daveshah1/RFToolSDR/hardware/rftool/rftool_impedances.png

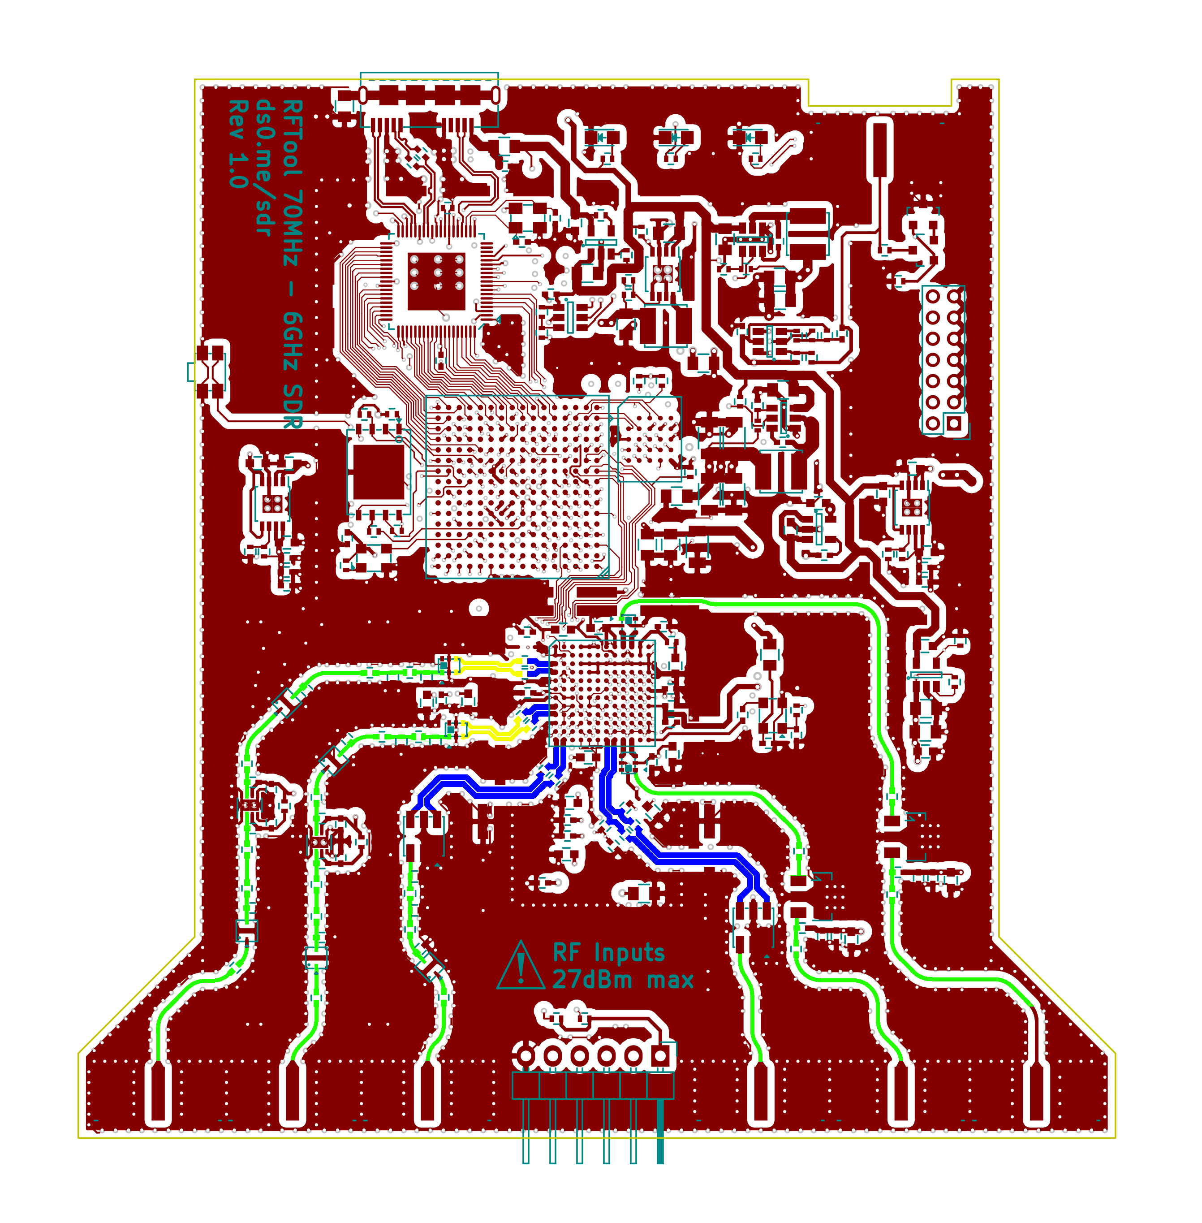
hardware/rftool/rftool_impedances.png
