daveshah1/RFToolSDR/hardware/rftool/bom/rftool_bom_r1.0_final_mpn.ods

Id | Designator | Package | Quantity | Designation | Description | Manufacturer | MPN | Notes/Positioning | Pin/Pad Count
23 | C103,C108,C111,C113,C118,C119,C120,C124,C132 | C_0805 | 9 | 4.7µ | 4.7uF 0805 capacitor | Murata | GRM21BR71A475KA73K | or any other equivalent part | 2
24 | C104,C105,C109,C110,C114,C115,C121,C123,C125,C126,C127,C128,C129,C130,C131,C133 | C_0402 | 16 | 470n | 470nF X7R 0402 capacitor | Murata | GRM155R71A474KE01D | or any other equivalent part | 2
13 | C122,C39,C41,C112,C116,C117 | C_1206 | 6 | 47µ | 47uF 6.3V 1206 capacitor | Murata | GRM31CR60J476ME19L | or any other equivalent part | 2
20 | C14,C30,C31,C58,C61,C101,C32 | C_0805 | 7 | 10µ | 10uF 0805 capacitor | Murata | GRM21BR71A106KA73K | or any other equivalent part | 2
15 | C2,C1,C7,C10,C11,C12,C22,C26,C27,C16,C146,C147,C149,C151 | C_0402 | 14 | 100p | 100pF 0402 C0G capacitor | Murata | GCM1555C1H101JA16D | or any other equivalent part | 2
5 | C20,C72,C59,C76,C25,C48,C56,C57,C60,C73,C79,C84,C87,C90,C150 | C_0402 | 15 | 10n | 10nF 0402 capacitor | Murata | GRM155R71E103KA01D | or any other equivalent part | 2
21 | C23,C24,C28,C29,C95,C100,C152,C153 | C_0402 | 8 | 18p | 18pF 0402 C0G capacitor | Murata | GRM1555C1E180JA01D | or any other equivalent part | 2
16 | C3,C9,C13,C62,C63,C85,C86,C15,C145 | C_0402 | 9 | 1n | 1nF 0402 capacitor | Murata | GRM155R71H102KA01D | or any other equivalent part | 2
22 | C36,C37,C38,C40 | C_0805 | 4 | 22µ | 22uF 0805 capacitor | Murata | GRM21BC80J226ME51L | or any other equivalent part | 2
17 | C4,C17 | C_0402 | 2 | 68p | 68pF 0402 C0G capacitor | Murata | GRM1555C1H680GA01D | or any other equivalent part | 2
18 | C5,C18 | C_0402 | 2 | 1.2n | 1.2nF 0402 capacitor | Murata | GRM155R71H122KA01J | or any other equivalent part | 2
3 | C52,C68,C8,C19,C21,C33,C42,C43,C44,C46,C47,C49,C53,C64,C69,C70,C71,C74,C75,C82,C83,C88,C89,C102,C135,C139,C148,C77,C45 | C_0603 | 29 | 1µ | 1uF 0603 capacitor | Murata | GRM188R71C105KE15D | or any other equivalent part | 2
19 | C6,C144 | C_0402 | 2 | 20p | 20pF 0402 C0G capacitor | Murata | GRM1555C1H200JA01D | or any other equivalent part | 2
7 | C80,C34,C35,C50,C54,C55,C65,C66,C67,C78,C81,C91,C92,C93,C94,C96,C97,C98,C99,C106,C107,C134,C136,C137,C138 | C_0402 | 25 | 100n | 100nF 0402 capacitor | Murata | GRM155R71C104KA88D | or any other equivalent part | 2
25 | D1,D2 | LED_0805 | 2 | GREEN | Green 0805 LED | OSRAM | LG R971-KN-1 | or any other equivalent part | 2
26 | D3 | LED_0805 | 1 | ORANGE | Orange 0805 LED | OSRAM | LO R976-PS-1 | or any other equivalent part | 2
27 | D4,D5,D6,D8,D9 | CLA4603-085LF | 5 | CLA4603-085LF | RF PIN limiter diode | Skyworks | CLA4603-085LF | or any other equivalent part | 3
9 | J2,J1 | BMI-S-230-F-R | 2 | BMI-S-230-F-R | RF shield frame 2”x1.5” | Laird | BMI-S-230-F-R | or any other equivalent part | 28
6 | J3 | BMI-S-209-F | 1 | BMI-S-209-F | RF shield frame 0.728”x1.156” | Laird | BMI-S-209-F | or any other equivalent part | 12
8 | J4,J5 | BMI-S-205-F | 2 | BMI-S-205-F | RF shield frame 1”x1.5” | Laird | BMI-S-205-F | or any other equivalent part | 20
12 | J6 | MICROUSB-GSB343K33HRCTV | 1 | GSB343K33HRCT | USB 3.0 micro-B connector SMD RA | Amphenol | GSB343K33HR | or any other equivalent part | 16
28 | L1,L8 | C_0402 | 2 | 43nH | 43nH 0402 inductor | Murata | LQW15AN43NG80D | or any other equivalent part | 2
32 | L12 | XFL4020 | 1 | 3.3µ | 3.3uH 5A 4x4mm inductor | Coilcraft | XFL4020-332MEB | or any other equivalent part | 2
33 | L13 | XFL4020 | 1 | 2.2µH | 2.2uH 8A 4x4mm inductor | Coilcraft | XFL4020-222MEB | or any other equivalent part | 2
34 | L14 | XFL4020 | 1 | 1.5µH | 1.5uH 9A 4x4mm inductor | Coilcraft | XFL4020-152MEB | or any other equivalent part | 2
35 | L15,L16,L17 | C_0805 | 3 | FERRITE | 120ohm@100MHz 3.5A 0805 ferrite | Laird | HI0805O121R-10 | or any other equivalent part | 2
2 | L3,L2,L5,L11,L10,L20,L22 | C_0402 | 7 | 30nH | 30nH 0402 inductor | Murata | LQW15AN30NG80D | or any other equivalent part | 2
29 | L4,L19 | C_0402 | 2 | 1nH | 1nH 0402 inductor | Murata | LQG15HN1N0S02D | or any other equivalent part | 2
30 | L6,L7 | C_0402 | 2 | 330nH | 330nH 0402 inductor | Bourns | CW201212-R33J | or any other equivalent part | 2
31 | L9,L21 | C_0402 | 2 | 36nH | 36nH 0402 inductor | Murata | LQW15AN36NG80D | or any other equivalent part | 2
36 | P5 | Pin_Header_Straight_2x07_Pitch2.00mm | 1 | JTAG | Shrouded 2x7 pin 2.00mm header | Molex | 0878311420 | or any other equivalent part | 14
11 | P6,P4,P8,P1,P2,P3,P9 | SMA-EDGE-73251-1150 | 7 | 73251-1150 | End launch SMA socket | Molex | 0732511150 | or any other equivalent part | 2
14 | P7 | Pin_Header_Angled_1x06 | 1 | AUX | 1x6 pin 2.54mm RA header | Molex | 0022053061 | or any other equivalent part | 6
1 | Q2,Q1 | SOT-23 | 2 | 2N7002 | N-channel logic level MOSFET | NXP | 2N7002P,215 | or any other equivalent part | 3
37 | R1,R61,R62 | R_0402 | 3 | 2.2k | 2.2kΩ 0402 resistor | Yageo | RC0402FR-072K2L | or any other equivalent part | 2
43 | R11 | R_0402 | 1 | 3.16k | 3.16kΩ 1% 0402 resistor | Yageo | RC0402FR-073K16L | or any other equivalent part | 2
44 | R17,R19 | R_0402 | 2 | 11.5k | 11.5kΩ 1% 0402 resistor | Yageo | RC0402FR-0711K5L | or any other equivalent part | 2
38 | R2,R3,R25,R56,R57,R58,R59 | R_0402 | 7 | 1k | 1kΩ 0402 resistor | Yageo | RC0402FR-071KL | or any other equivalent part | 2
45 | R24 | R_0402 | 1 | 14.3k | 14.3kΩ 1% 0402 resistor | Yageo | RC0402FR-0714K3L | or any other equivalent part | 2
69 | R26,R63,R70 | R_0402 | 3 | 82 | 82Ω 1% 0402 resistor | Yageo | RC0402FR-0782RL | or any other equivalent part | 2
70 | R27 | R_0402 | 1 | 100 | 100Ω 1% 0402 resistor | Yageo | RC0402FR-07100RL | or any other equivalent part | 2
46 | R29,R30 | R_0402 | 2 | 1 | 1Ω 0402 resistor | Panasonic | ERJ-2GEJ1R0X | or any other equivalent part | 2
47 | R34 | R_0402 | 1 | 1.6k | 1.6kΩ 1% 0402 resistor | Yageo | RC0402FR-071K6L | or any other equivalent part | 2
39 | R4,R15,R39,R40,R42,R43,R44,R45,R67 | R_0402 | 9 | 4.7k | 4.7kΩ 0402 resistor | Yageo | RC0402FR-074K7L | or any other equivalent part | 2
48 | R41 | R_0402 | 1 | 22 | 22Ω 0402 resistor | Yageo | RC0402FR-0722RL | or any other equivalent part | 2
71 | R46,R48,R68 | R_0402 | 3 | 75 | 75Ω 1% 0402 resistor | Yageo | RC0402FR-0775RL | or any other equivalent part | 2
49 | R47,R49,R50 | R_0402 | 3 | 0R | 0Ω 0402 resistor | Yageo | RC0402FR-070RL | or any other equivalent part | 2
40 | R5,R6,R8,R10,R12,R13,R14,R16,R18,R21,R22,R23,R28,R31,R32,R33,R35,R36,R37,R38,R53,R54,R55,R20 | R_0402 | 24 | 10k | 10kΩ 1% 0402 resistor | Yageo | RC0402FR-0710KL | or any other equivalent part | 2
72 | R51,R69 | R_0402 | 2 | 120 | 120Ω 1% 0402 resistor | Yageo | RC0402FR-07120RL | or any other equivalent part | 2
50 | R52 | R_0402 | 1 | 47 | 47Ω 1% 0402 resistor | Yageo | RC0402FR-0747RL | or any other equivalent part | 2
41 | R7,R60 | R_0402 | 2 | 45.3k | 45.3kΩ 1% 0402 resistor | Yageo | RC0402FR-0745K3L | or any other equivalent part | 2
42 | R9 | R_0402 | 1 | 13.7k | 13.7kΩ 1% 0402 resistor | Yageo | RC0402FR-0713K7L | or any other equivalent part | 2
73 | SWRST1 | PTS840G | 1 | PTS840 GKP SMTR LFS | Right Angle SMD tactile switch | Yageo | PTS840GKPSMTR |  | 4
51 | T1,T3 | TCM1-63AX+ | 2 | TCM1-63AX+ | RF Transformer 1:1 10MHz-6GHz | Mini-Circuits | TCM1-63AX+ |  | 6
67 | T4,T7 | 1720BL15B0050 | 2 | 1720BL15A0100 | Ceramic Balun 1:2 625MHz-2815MHz | Johanson | 1720BL15A0100 | coloured mark facing up | 6
68 | T5,T2 | 1720BL15B0050 | 2 | 1720BL15B0050 | Ceramic Balun 1:1 625MHz-2815MHz | Johanson | 1720BL15B0050 | coloured mark facing up | 6
10 | U1,U20 | SOT89-3 | 2 | ADL5611 | RF amplifier 30MHz-6GHz | Analog Devices | ADL5611ARKZ |  | 4
58 | U11 | SOT-23-6 | 1 | LM3880MF-1AA | Power supply sequencer | TI | LM3880MF-1AA |  | 6
4 | U12 | CSP_BGA_144_pitch0.8mm | 1 | AD9361BBCZ | RF transceiver 70MHz-6GHz | Analog Devices | AD9361BBCZ |  | 144
59 | U13 | XO_3.2x2.5mm | 1 | TXEAACSANF-40.000000 | 40MHz 2.8-3.3V 0.5ppm TCXO | Taiten | TXEAACSANF-40.000000 |  | 4
60 | U14 | QFN_76_pitch0.4mm | 1 | FT601Q | USB 3.0 to FIFO bridge | FTDI | FT601Q |  | 77
61 | U15 | XO_3.2x2.5mm | 1 | KC3225A50.0000C3GE00 | 50MHz 3.3V oscillator | AVX/Kyocera | KC3225A50.0000C3GE00 | or any other equivalent part | 4
62 | U16 | VDFPN8 | 1 | N25Q256A13EF840E | 256MBit 3.3V serial flash memory | Micron | N25Q256A13EF840E |  | 9
63 | U17 | BGA-256 | 1 | XC7A50T-2FTG256I | Artix-7 FPGA 52k logic cells | Xilinx | XC7A50T-2FTG256I | XC7A50T-2FTG256C also OK if cheaper | 256
64 | U18 | FBGA24_pitch1mm | 1 | IS66WVH8M8ALL-166B1LI | 64MBit HyperRAM 1.8V 166MHz | ISSI | IS66WVH8M8ALL-166B1LI |  | 24
65 | U19 | SOT-23-6 | 1 | SN74LVC2G17 | Dual schmitt-trigger buffer | TI | SN74LVC2G17DBVR |  | 6
52 | U2,U21 | DFN-8-1EP_2x2mm_Pitch0.5mm | 2 | SKY67159-396LF | RF LNA 200MHz-3.8GHz | Skyworks | SKY67159-396LF |  | 9
53 | U3,U8 | SOT-23-5 | 2 | TPS2069C-DBV | 1.5A USB power switch IC | TI | TPS2069CDBVR |  | 6
54 | U4 | MSOP-8-1EP_3x3mm_Pitch0.65mm | 1 | LM2832XMY | 2A buck switching regulator IC | TI | LM2832XMY/NOPB |  | 9
55 | U5,U6 | SOT-23-6 | 2 | TPS564208DDC | 4A buck switching regulator IC | TI | TPS564208DDCR |  | 6
56 | U7 | SOT-23-5 | 1 | LD3985M30R | 3.0V 150mA LDO regulator | ST | LD3985M30R |  | 5
57 | U9,U10 | MSOP-8-1EP_3x3mm_Pitch0.65mm | 2 | MIC47100YMME | Adjustable 1A LDO regulator | Microchip | MIC47100YMME |  | 9
66 | X1 | XTAL_3.2x2.5mm | 1 | ABM8-30.000MHZ-B2 | 30MHz crystal | Abracon | ABM8-30.000MHZ-B2-T | or any other equivalent part | 4
