daveshah1/RFToolSDR/hardware/rftool/pos/positions_bottom.pdf

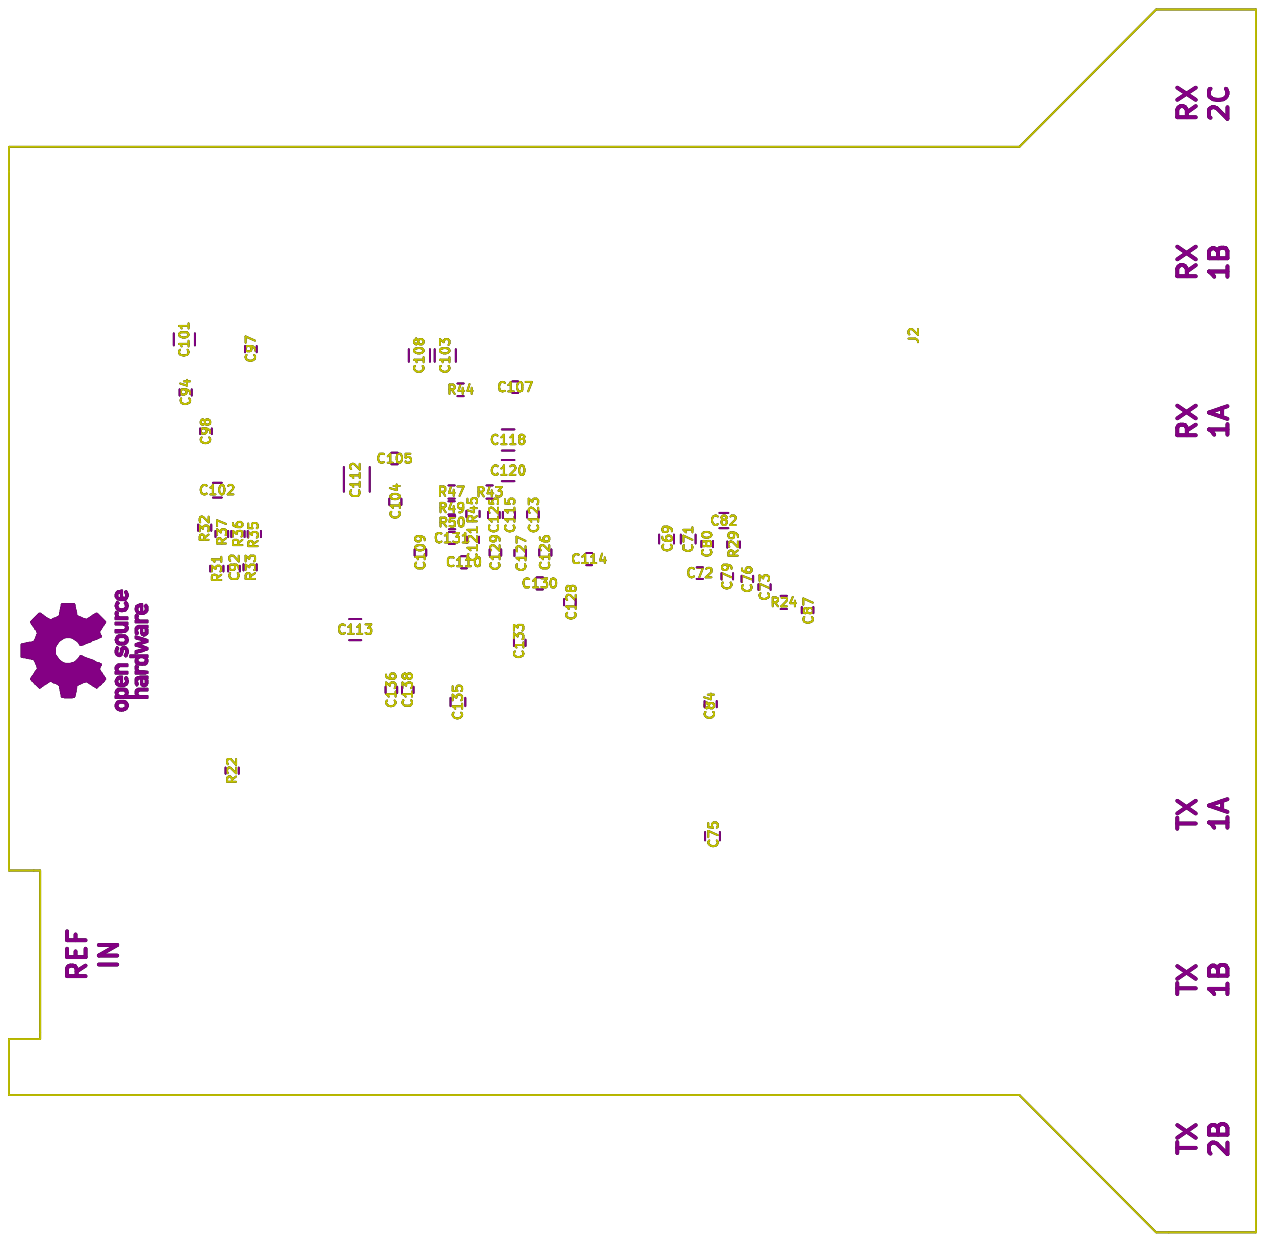
[picture p2: page 1]
