daveshah1/RFToolSDR/hardware/rftool/pos/positions_top.pdf

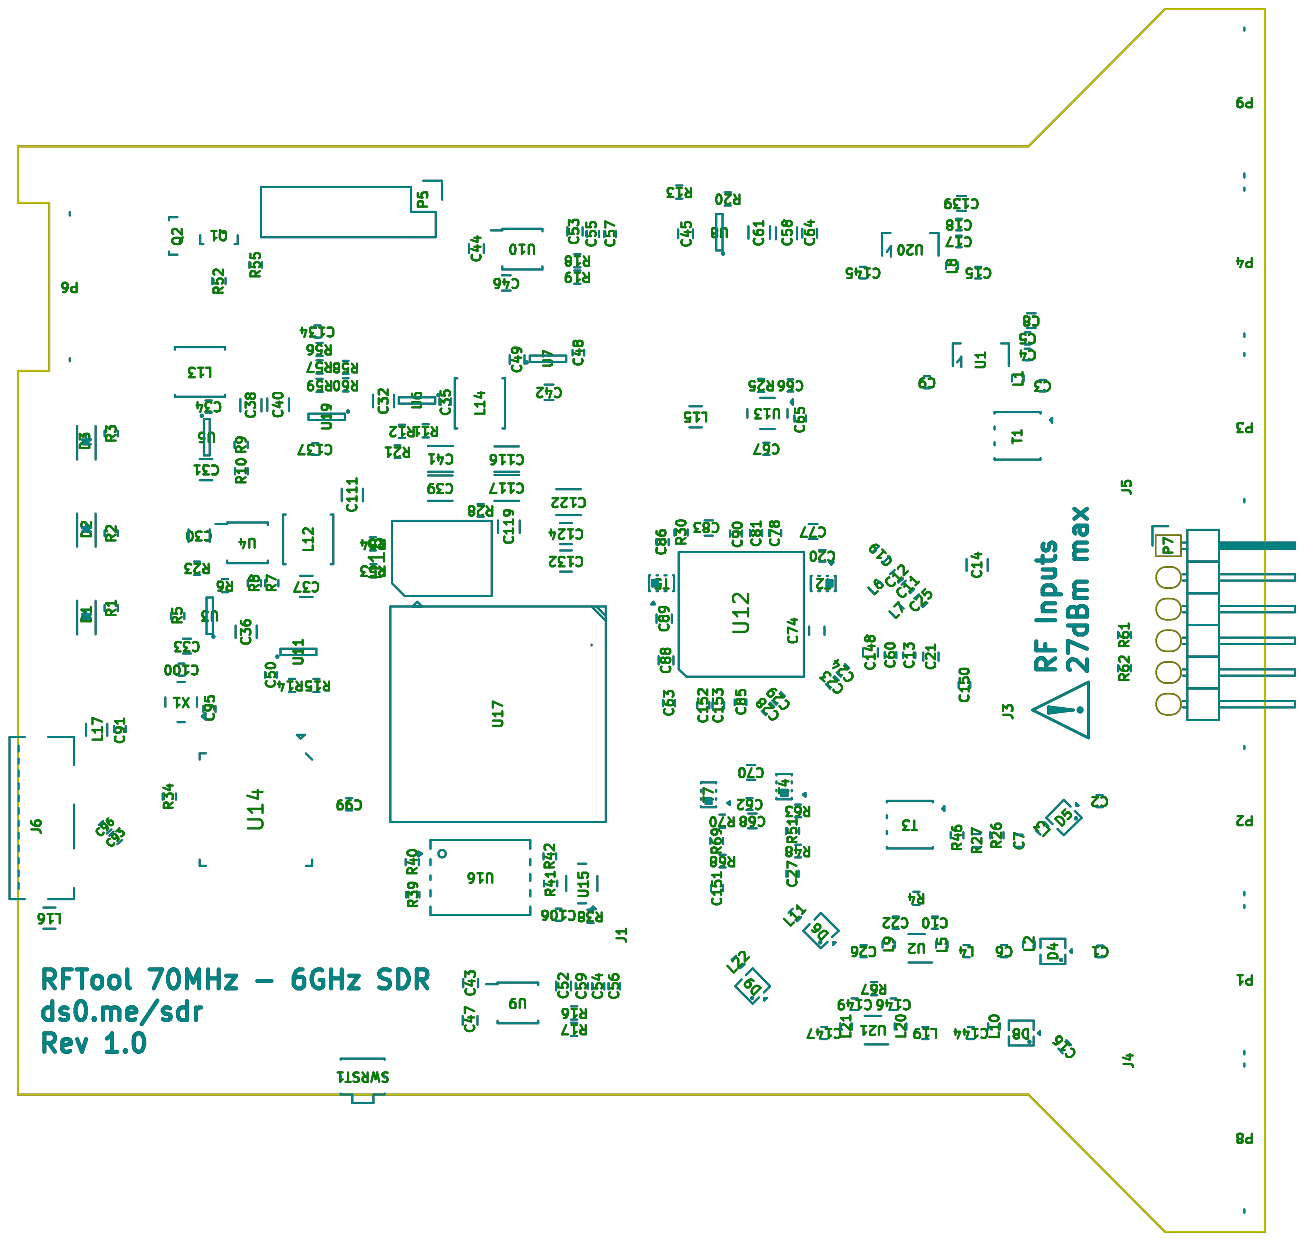
[picture p3: page 1]
