daveshah1/RFToolSDR/hardware/rftool/rftool.kicad_pcb

## KiCad design hardware/rftool/rftool.kicad_pcb (2016-12-20)

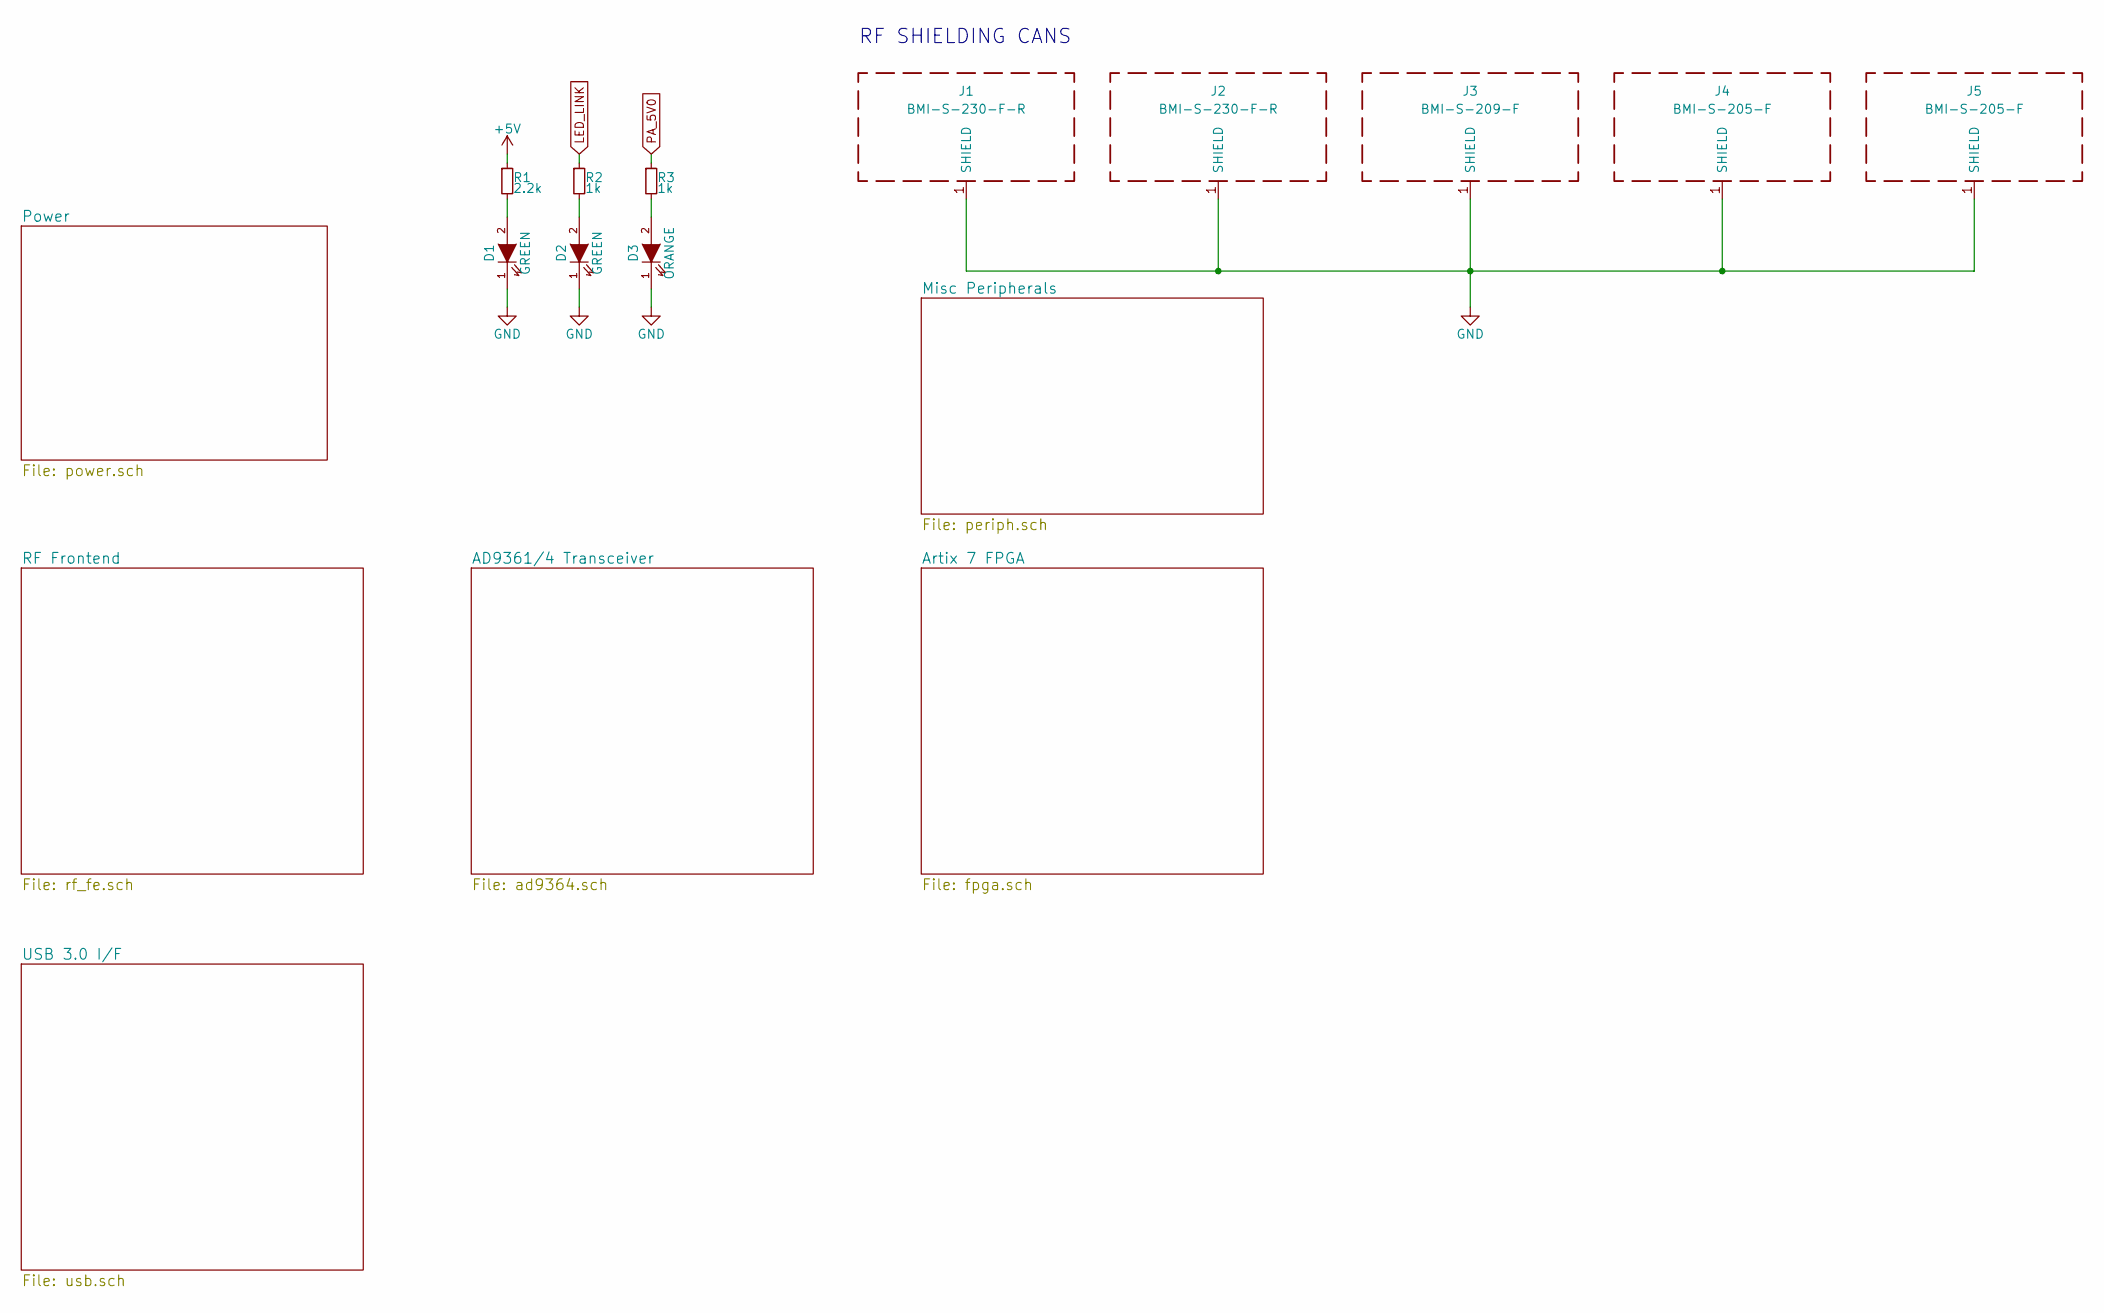
[picture p4: schematic rftool.sch, RFTool 70MHz-6GHz SDR]

Parts:
D1, D2: GREEN; LED_0805
D3: ORANGE; LED_0805
J1, J2: BMI-S-230-F-R
J3: BMI-S-209-F
J4, J5: BMI-S-205-F
R1: 2.2k; R_0402
R2, R3: 1k; R_0402

Connections:
+5V: R1.1; also elsewhere on the board
GND: D1.1 (K), D2.1 (K), D3.1 (K), J1.1, J2.1, J3.1, J4.1, J5.1; also elsewhere on the board
LED_LINK: R2.1; also elsewhere on the board
unnamed: D1.2 (A), R1.2
unnamed: D2.2 (A), R2.2
unnamed: D3.2 (A), R3.2
PA_5V0: R3.1; also elsewhere on the board

Notes on the sheet:
RF SHIELDING CANS

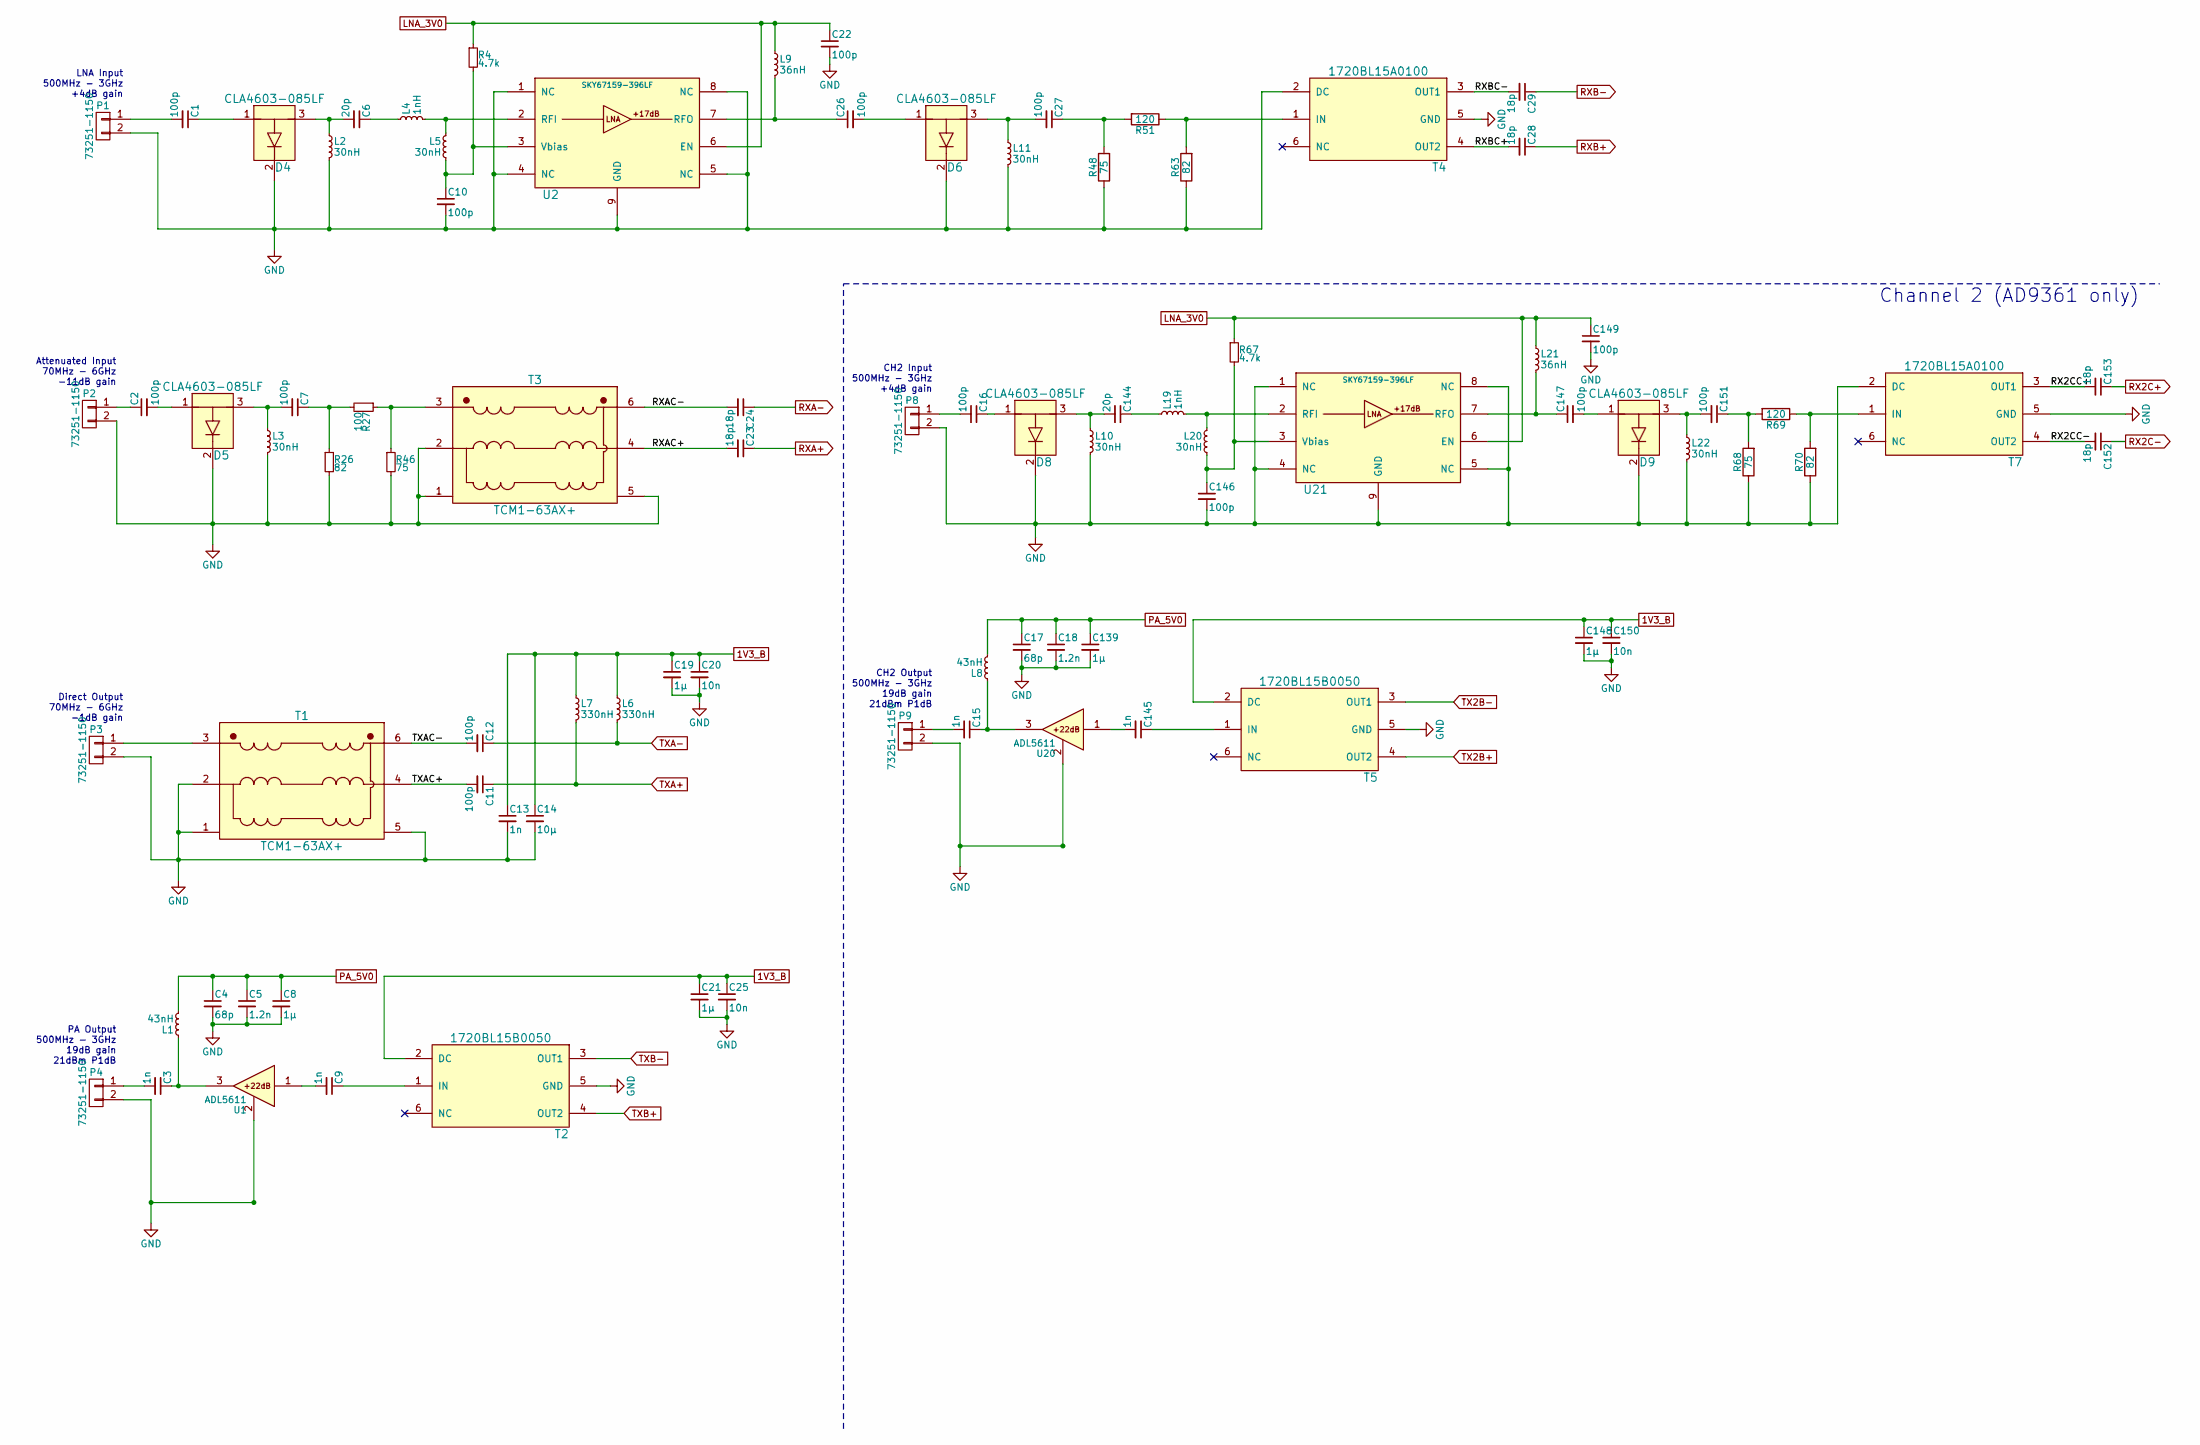
[picture p5: schematic rf_fe.sch, RFTool 70MHz-6GHz SDR]

Parts:
C1, C2, C7, C10, C11, C12, C16, C22, C26, C27, C146, C147, C149, C151: 100p; C_0402
C3, C9, C13, C15, C145: 1n; C_0402
C4, C17: 68p; C_0402
C5, C18: 1.2n; C_0402
C6, C144: 20p; C_0402
C8, C19, C21, C139, C148: 1µ; C_0603
C14: 10µ; C_0805
C20, C25, C150: 10n; C_0402
C23, C24, C28, C29, C152, C153: 18p; C_0402
D4, D5, D6, D8, D9: CLA4603-085LF
L1, L8: 43nH; C_0402
L2, L3, L5, L10, L11, L20, L22: 30nH; C_0402
L4, L19: 1nH; C_0402
L6, L7: 330nH; C_0402
L9, L21: 36nH; C_0402
P1, P2, P3, P4, P8, P9: 73251-1150; SMA-EDGE-73251-1150
R4, R67: 4.7k; R_0402
R26, R63, R70: 82; R_0402
R27: 100; R_0402
R46, R48, R68: 75; R_0402
R51, R69: 120; R_0402
T1, T3: TCM1-63AX+
T2, T5: 1720BL15B0050
T4, T7: 1720BL15A0100; 1720BL15B0050
U1, U20: ADL5611; SOT89-3_Housing
U2, U21: SKY67159-396LF; DFN-8-1EP_2x2mm_Pitch0.5mm

Connections:
1V3_B: C13.1, C14.1, C19.1, C20.1, C21.1, C25.1, C148.1, C150.1, L6.1, L7.1, T2.2 (DC), T5.2 (DC); also elsewhere on the board
/RF Frontend/RX2CC+: C153.2, T7.3 (OUT1)
/RF Frontend/RX2CC-: C152.2, T7.4 (OUT2)
/RF Frontend/RXAC+: C23.2, T3.4 (S)
/RF Frontend/RXAC-: C24.2, T3.6 (Sd)
/RF Frontend/RXBC+: C28.2, T4.4 (OUT2)
/RF Frontend/RXBC-: C29.2, T4.3 (OUT1)
/RF Frontend/TXAC+: C11.2, T1.4 (S)
/RF Frontend/TXAC-: C12.2, T1.6 (Sd)
GND: C4.2, C5.2, C8.2, C10.2, C13.2, C14.2, C17.2, C18.2, C19.2, C20.2, C21.2, C22.2, C25.2, C139.2, C146.2, C148.2, C149.2, C150.2, D4.2 (C), D5.2 (C), D6.2 (C), D8.2 (C), D9.2 (C), L2.2, L3.2, L10.2, L11.2, L22.2, P1.2, P2.2, P3.2, P4.2, P8.2, P9.2, R26.2, R46.2, R48.1, R63.1, R68.1, R70.1, T1.1 (NC), T1.2 (p), T1.5 (NC), T2.5 (GND), T3.1 (NC), T3.2 (p), T3.5 (NC), T4.2 (DC), T4.5 (GND), T5.5 (GND), T7.2 (DC), T7.5 (GND), U1.2 (GND), U2.1 (NC), U2.4 (NC), U2.5 (NC), U2.8 (NC), U2.9 (GND), U20.2 (GND), U21.1 (NC), U21.4 (NC), U21.5 (NC), U21.8 (NC), U21.9 (GND); also elsewhere on the board
LNA_3V0: C22.1, C149.1, L9.1, L21.1, R4.1, R67.1, U2.6 (EN), U21.6 (EN); also elsewhere on the board
unnamed: C1.1, D4.1 (A)
unnamed: C1.2, P1.1
unnamed: C2.1, P2.1
unnamed: C2.2, D5.1 (A)
unnamed: C3.1, L1.1, U1.3 (RFOUT)
unnamed: C3.2, P4.1
unnamed: C6.1, L4.1
unnamed: C6.2, D4.3 (A), L2.1
unnamed: C7.1, R26.1, R27.2
unnamed: C7.2, D5.3 (A), L3.1
unnamed: C9.1, T2.1 (IN)
unnamed: C9.2, U1.1 (RFIN)
unnamed: C10.1, L5.2, R4.2, U2.3 (Vbias)
unnamed: C15.1, L8.1, U20.3 (RFOUT)
unnamed: C15.2, P9.1
unnamed: C16.1, D8.1 (A)
unnamed: C16.2, P8.1
unnamed: C26.1, L9.2, U2.7 (RFO)
unnamed: C26.2, D6.1 (A)
unnamed: C27.1, R48.2, R51.2
unnamed: C27.2, D6.3 (A), L11.1
unnamed: C144.1, L19.1
unnamed: C144.2, D8.3 (A), L10.1
unnamed: C145.1, T5.1 (IN)
unnamed: C145.2, U20.1 (RFIN)
unnamed: C146.1, L20.2, R67.2, U21.3 (Vbias)
unnamed: C147.1, L21.2, U21.7 (RFO)
unnamed: C147.2, D9.1 (A)
unnamed: C151.1, R68.2, R69.2
unnamed: C151.2, D9.3 (A), L22.1
unnamed: L4.2, L5.1, U2.2 (RFI)
unnamed: L19.2, L20.1, U21.2 (RFI)
unnamed: P3.1, T1.3 (Pd)
unnamed: R27.1, R46.1, T3.3 (Pd)
unnamed: R51.1, R63.2, T4.1 (IN)
unnamed: R69.1, R70.2, T7.1 (IN)
PA_5V0: C4.1, C5.1, C8.1, C17.1, C18.1, C139.1, L1.2, L8.2; also elsewhere on the board
RX2C+: C153.1; also elsewhere on the board
RX2C-: C152.1; also elsewhere on the board
RXA+: C23.1; also elsewhere on the board
RXA-: C24.1; also elsewhere on the board
RXB+: C28.1; also elsewhere on the board
RXB-: C29.1; also elsewhere on the board
TX2B+: T5.4 (OUT2); also elsewhere on the board
TX2B-: T5.3 (OUT1); also elsewhere on the board
TXA+: C11.1, L7.2; also elsewhere on the board
TXA-: C12.1, L6.2; also elsewhere on the board
TXB+: T2.4 (OUT2); also elsewhere on the board
TXB-: T2.3 (OUT1); also elsewhere on the board

Notes on the sheet:
LNA Input 500MHz - 3GHz +4dB gain
Attenuated Input 70MHz - 6GHz -11dB gain
Direct Output 70MHz - 6GHz -1dB gain
PA Output 500MHz - 3GHz 19dB gain 21dBm P1dB
Channel 2 (AD9361 only)
CH2 Input 500MHz - 3GHz +4dB gain
CH2 Output 500MHz - 3GHz 19dB gain 21dBm P1dB

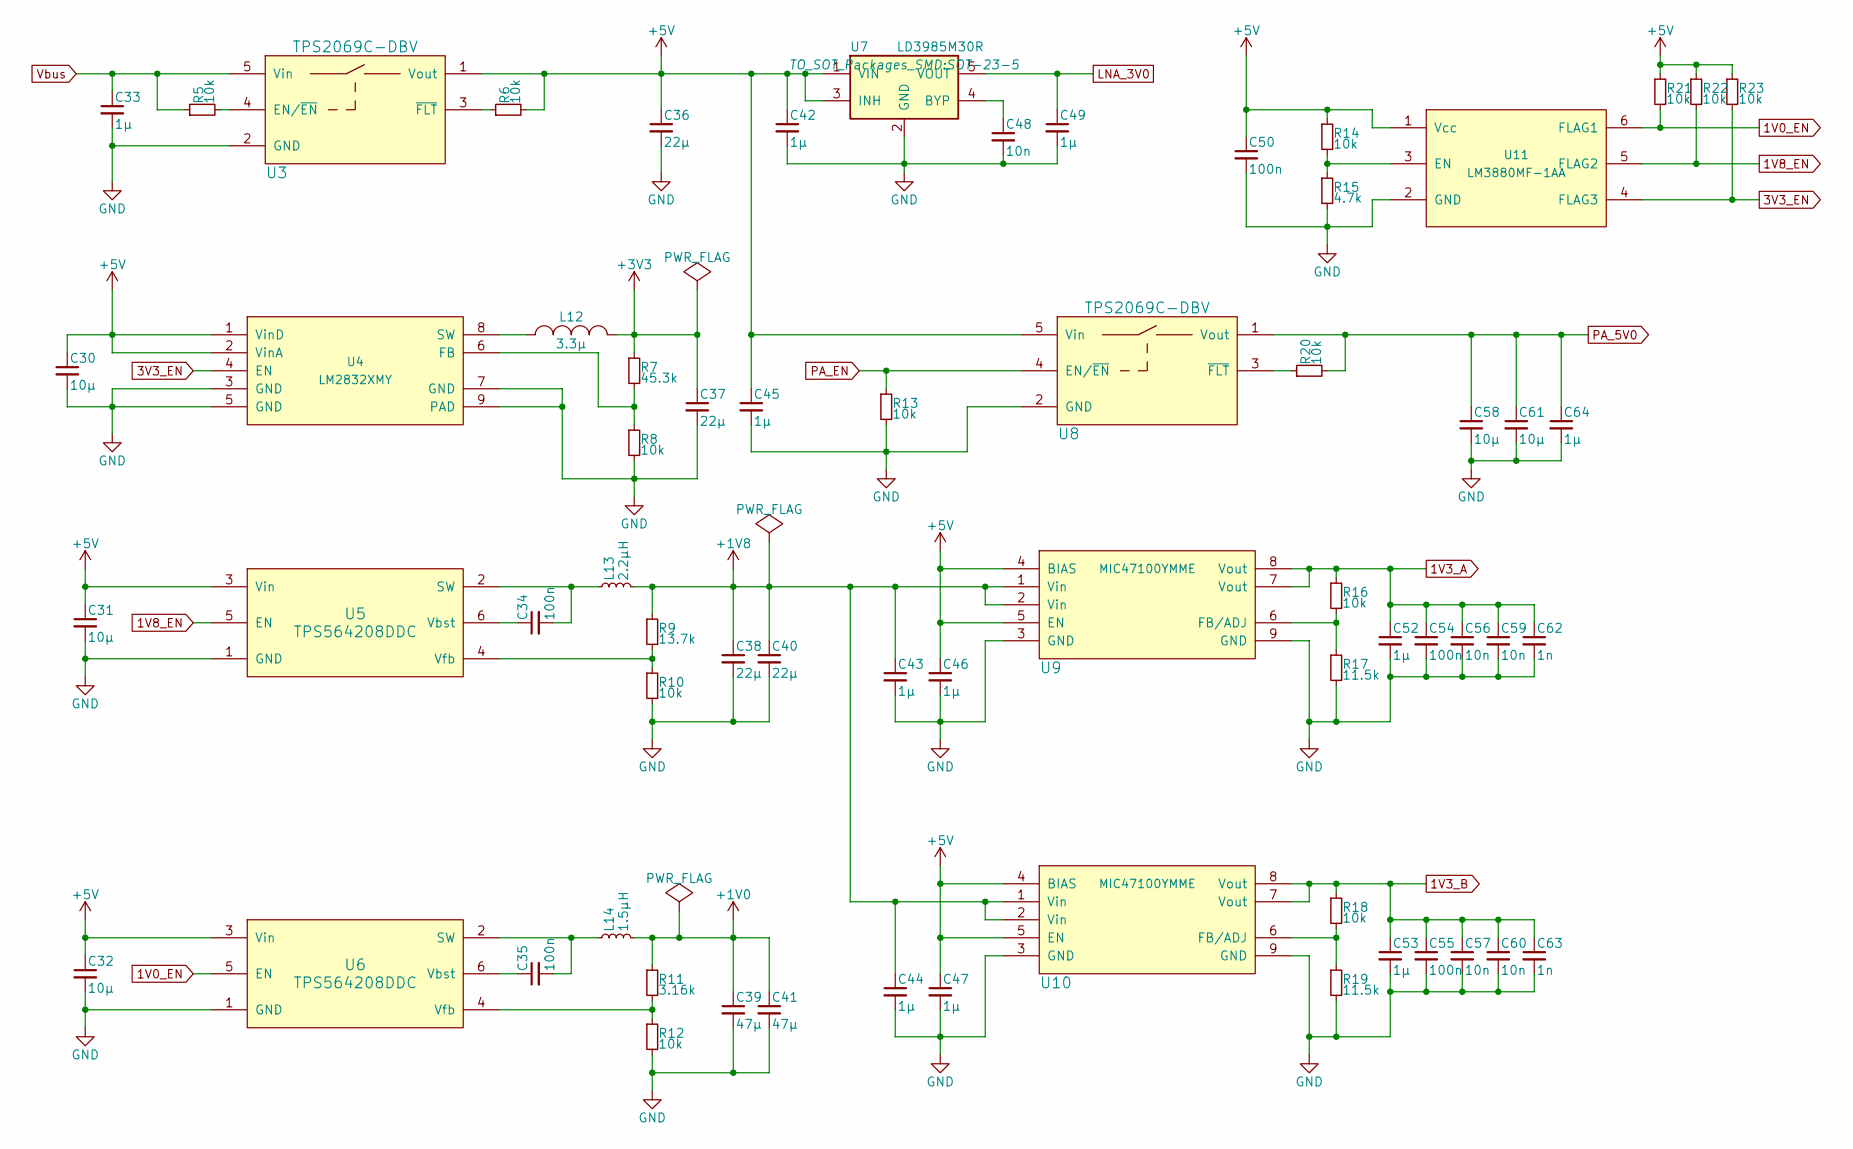
[picture p6: schematic power.sch, RFTool 70MHz-6GHz SDR]

Parts:
C30, C31, C32, C58, C61: 10µ; C_0805
C33, C42, C43, C44, C45, C46, C47, C49, C52, C53, C64: 1µ; C_0603
C34, C35, C50, C54, C55: 100n; C_0402
C36, C37, C38, C40: 22µ; C_0805
C39, C41: 47µ; C_1206
C48, C56, C57, C59, C60: 10n; C_0402
C62, C63: 1n; C_0402
L12: 3.3µ; XFL4020
L13: 2.2µH; XFL4020
L14: 1.5µH; XFL4020
R5, R6, R8, R10, R12, R13, R14, R16, R18, R20, R21, R22, R23: 10k; R_0402
R7: 45.3k; R_0402
R9: 13.7k; R_0402
R11: 3.16k; R_0402
R15: 4.7k; R_0402
R17, R19: 11.5k; R_0402
U3, U8: TPS2069C-DBV; SOT-23-5
U4: LM2832XMY; MSOP-8-1EP_3x3mm_Pitch0.65mm
U5, U6: TPS564208DDC; SOT-23-6
U7: LD3985M30R; SOT-23-5
U9, U10: MIC47100YMME; MSOP-8-1EP_3x3mm_Pitch0.65mm
U11: LM3880MF-1AA; SOT-23-6

Connections:
1V0_EN: R21.2, U6.5 (EN), U11.6 (FLAG1)
1V3_A: C52.1, C54.1, C56.1, C59.1, C62.1, R16.1, U9.7 (Vout), U9.8 (Vout); also elsewhere on the board
1V3_B: C53.1, C55.1, C57.1, C60.1, C63.1, R18.1, U10.7 (Vout), U10.8 (Vout); also elsewhere on the board
1V8_EN: R22.2, U5.5 (EN), U11.5 (FLAG2)
3V3_EN: R23.2, U4.4 (EN), U11.4 (FLAG3)
+1V0: C39.1, C41.1, L14.2, R11.1; also elsewhere on the board
+1V8: C38.1, C40.1, C43.1, C44.1, L13.2, R9.1, U9.1 (Vin), U9.2 (Vin), U10.1 (Vin), U10.2 (Vin); also elsewhere on the board
+3V3: C37.1, L12.2, R7.1; also elsewhere on the board
+5V: C30.1, C31.1, C32.1, C36.1, C42.1, C45.1, C46.1, C47.1, C50.1, R6.2, R14.1, R21.1, R22.1, R23.1, U3.1 (Vout), U4.1 (VinD), U4.2 (VinA), U5.3 (Vin), U6.3 (Vin), U7.1 (VIN), U7.3 (INH), U8.5 (Vin), U9.4 (BIAS), U9.5 (EN), U10.4 (BIAS), U10.5 (EN), U11.1 (Vcc); also elsewhere on the board
GND: C30.2, C31.2, C32.2, C33.2, C36.2, C37.2, C38.2, C39.2, C40.2, C41.2, C42.2, C43.2, C44.2, C45.2, C46.2, C47.2, C48.2, C49.2, C50.2, C52.2, C53.2, C54.2, C55.2, C56.2, C57.2, C58.2, C59.2, C60.2, C61.2, C62.2, C63.2, C64.2, R8.2, R10.2, R12.2, R13.2, R15.2, R17.2, R19.2, U3.2 (GND), U4.3 (GND), U4.5 (GND), U4.7 (GND), U4.9 (PAD), U5.1 (GND), U6.1 (GND), U7.2 (GND), U8.2 (GND), U9.3 (GND), U9.9 (GND), U10.3 (GND), U10.9 (GND), U11.2 (GND); also elsewhere on the board
LNA_3V0: C49.1, U7.5 (VOUT); also elsewhere on the board
unnamed: C34.1, U5.6 (Vbst)
unnamed: C34.2, L13.1, U5.2 (SW)
unnamed: C35.1, U6.6 (Vbst)
unnamed: C35.2, L14.1, U6.2 (SW)
unnamed: C48.1, U7.4 (BYP)
unnamed: L12.1, U4.8 (SW)
unnamed: R5.2, U3.4 (EN/~EN)
unnamed: R6.1, U3.3 (~FLT)
unnamed: R7.2, R8.1, U4.6 (FB)
unnamed: R9.2, R10.1, U5.4 (Vfb)
unnamed: R11.2, R12.1, U6.4 (Vfb)
unnamed: R14.2, R15.1, U11.3 (EN)
unnamed: R16.2, R17.1, U9.6 (FB/ADJ)
unnamed: R18.2, R19.1, U10.6 (FB/ADJ)
unnamed: R20.1, U8.3 (~FLT)
PA_5V0: C58.1, C61.1, C64.1, R20.2, U8.1 (Vout); also elsewhere on the board
PA_EN: R13.1, U8.4 (EN/~EN); also elsewhere on the board
Vbus: C33.1, R5.1, U3.5 (Vin); also elsewhere on the board

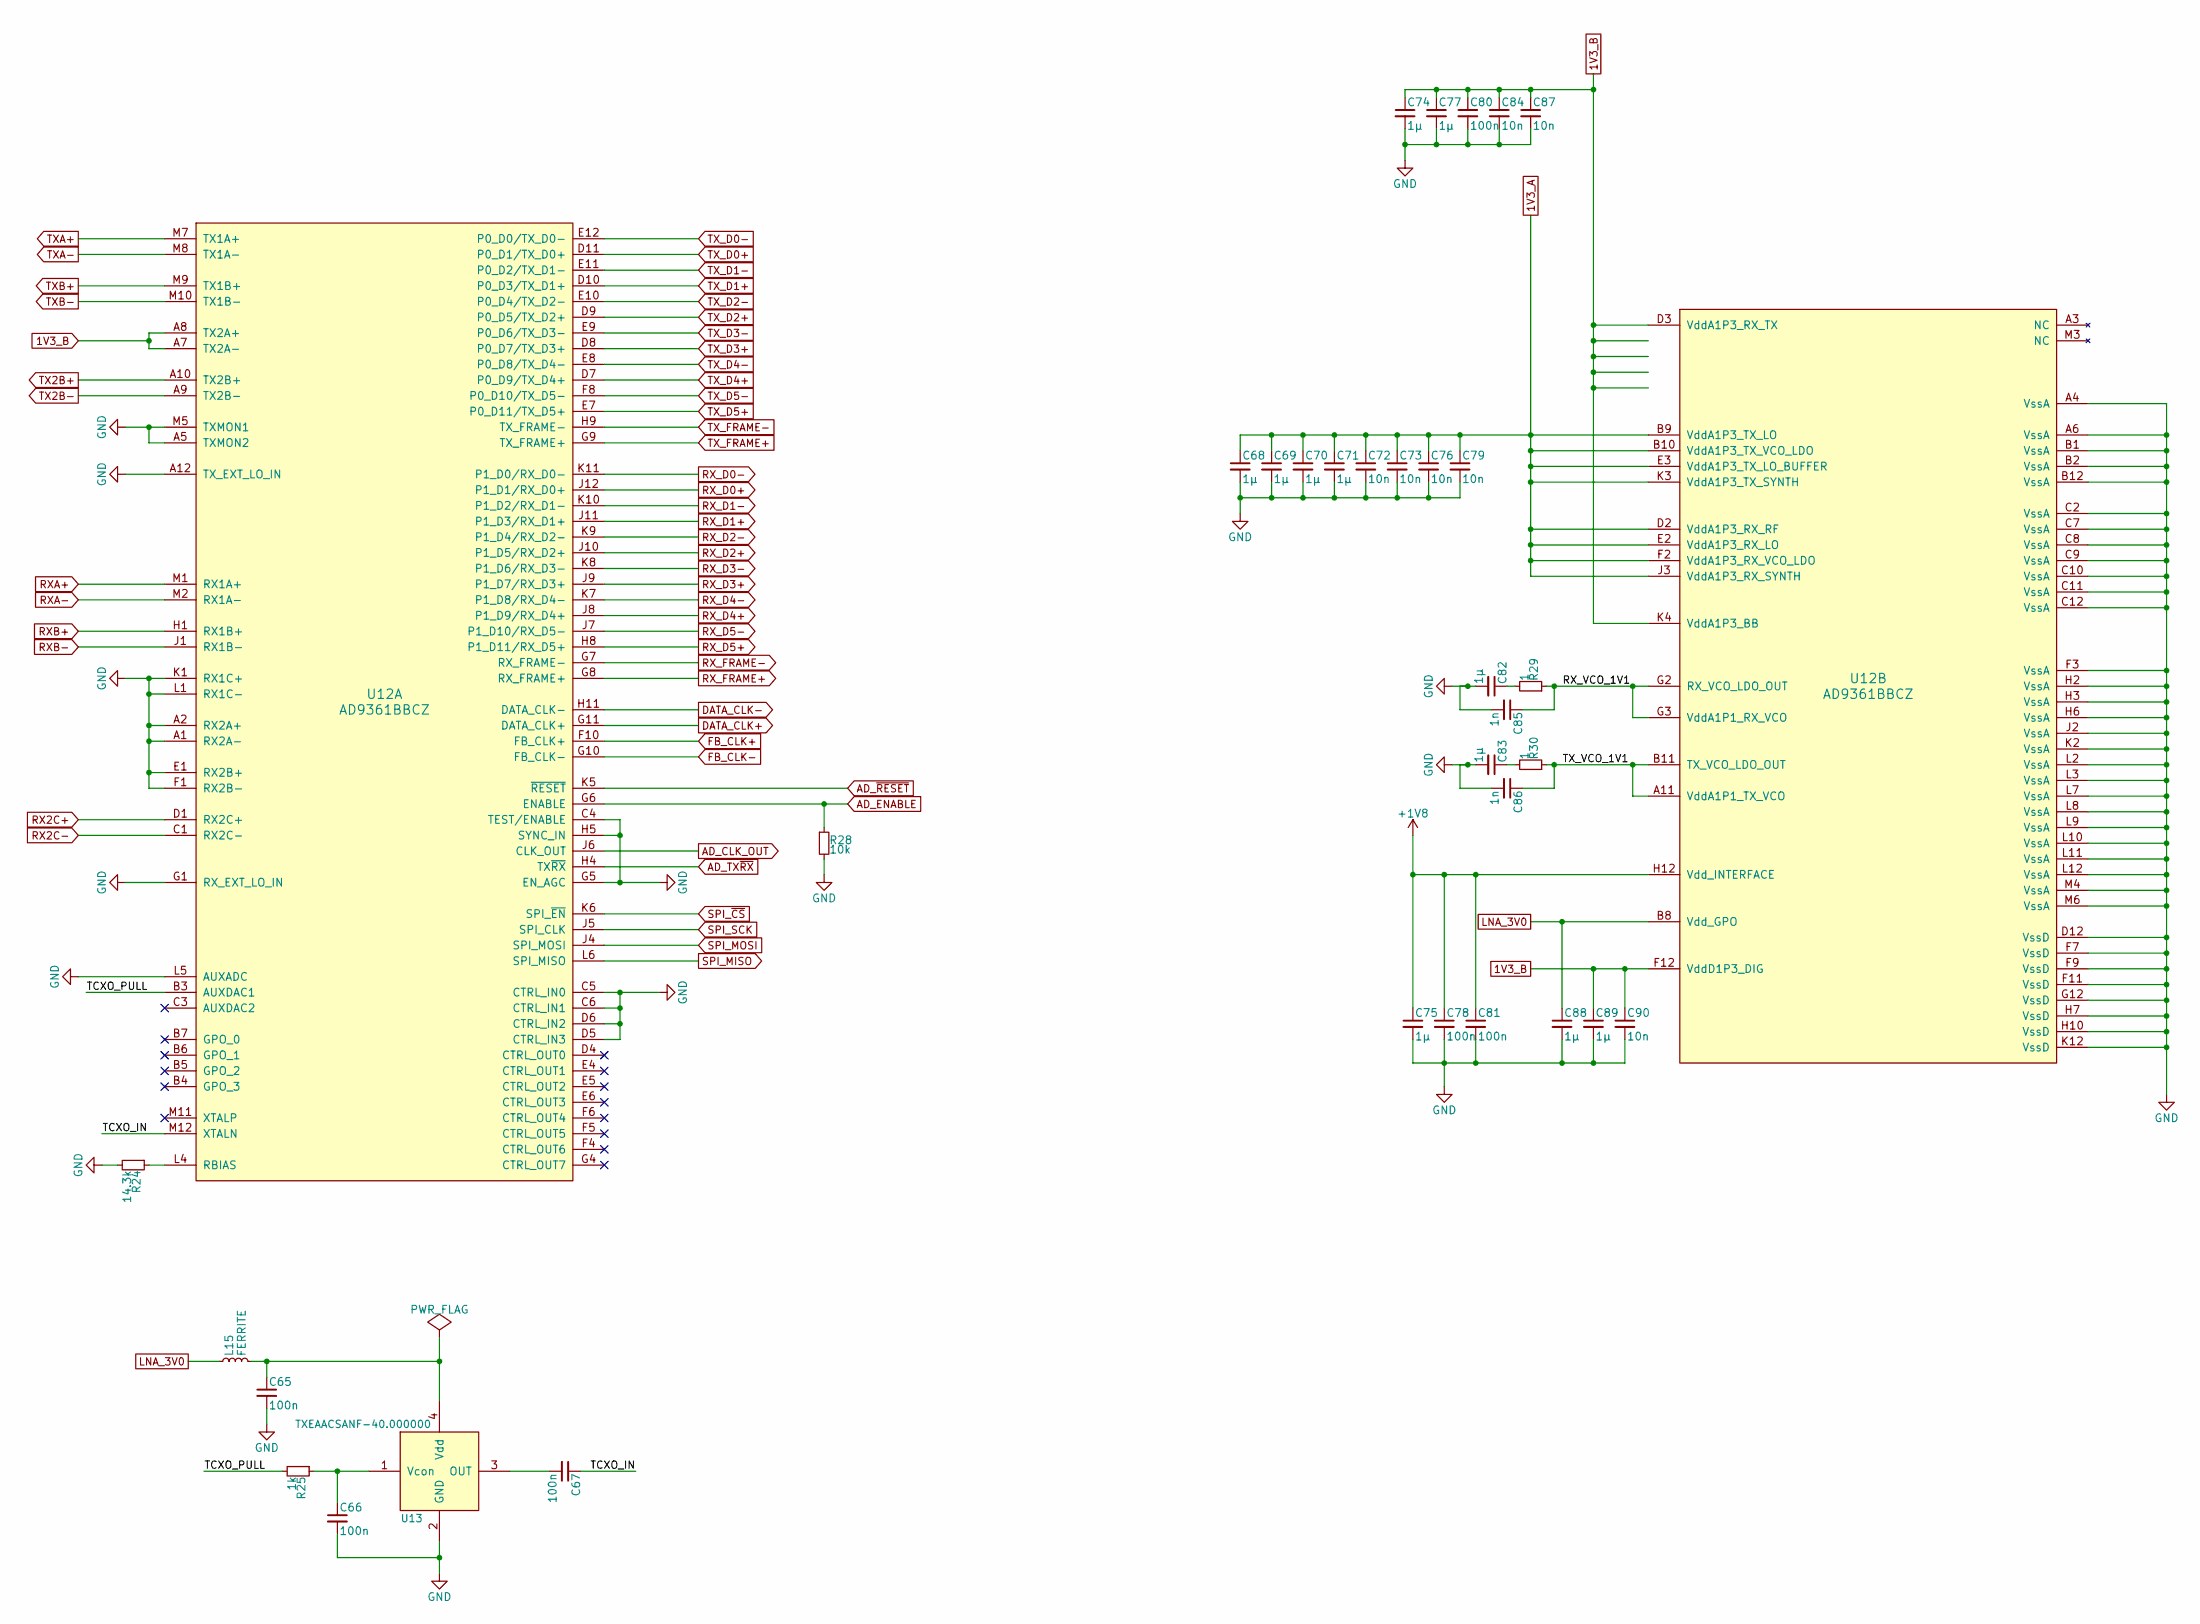
[picture p7: schematic ad9364.sch, RFTool 70MHz-6GHz SDR]

Parts:
C65, C66, C67, C78, C80, C81: 100n; C_0402
C68, C69, C70, C71, C74, C75, C77, C82, C83, C88, C89: 1µ; C_0603
C72, C73, C76, C79, C84, C87, C90: 10n; C_0402
C85, C86: 1n; C_0402
L15: FERRITE; C_0805
R24: 14.3k; R_0402
R25: 1k; R_0402
R28: 10k; R_0402
R29, R30: 1; R_0402
U12: AD9361BBCZ; CSP_BGA_144_pitch0.8mm
U13: TXEAACSANF-40.000000; VCTCXO_TX_3.2x2.5mm

Connections:
1V3_A: C68.1, C69.1, C70.1, C71.1, C72.1, C73.1, C76.1, C79.1, U12.B9 (VddA1P3_TX_LO), U12.B10 (VddA1P3_TX_VCO_LDO), U12.D2 (VddA1P3_RX_RF), U12.E2 (VddA1P3_RX_LO), U12.E3 (VddA1P3_TX_LO_BUFFER), U12.F2 (VddA1P3_RX_VCO_LDO), U12.J3 (VddA1P3_RX_SYNTH), U12.K3 (VddA1P3_TX_SYNTH); also elsewhere on the board
1V3_B: C74.1, C77.1, C80.1, C84.1, C87.1, C89.1, C90.1, U12.A7 (TX2A-), U12.A8 (TX2A+), U12.D3 (VddA1P3_RX_TX), U12.F12 (VddD1P3_DIG), U12.K4 (VddA1P3_BB); also elsewhere on the board
+1V8: C75.1, C78.1, C81.1, U12.H12 (Vdd_INTERFACE); also elsewhere on the board
/AD9361/4 Transceiver/RX_VCO_1V1: C85.1, R29.1, U12.G2 (RX_VCO_LDO_OUT), U12.G3 (VddA1P1_RX_VCO)
/AD9361/4 Transceiver/TCXO_IN: C67.1, U12.M12 (XTALN)
/AD9361/4 Transceiver/TCXO_PULL: R25.2, U12.B3 (AUXDAC1)
/AD9361/4 Transceiver/TX_VCO_1V1: C86.1, R30.1, U12.A11 (VddA1P1_TX_VCO), U12.B11 (TX_VCO_LDO_OUT)
AD_CLK_OUT: U12.J6 (CLK_OUT); also elsewhere on the board
AD_ENABLE: R28.1, U12.G6 (ENABLE); also elsewhere on the board
AD_TX~RX: U12.H4 (TX~RX); also elsewhere on the board
AD_~RESET: U12.K5 (~RESET); also elsewhere on the board
DATA_CLK+: U12.G11 (DATA_CLK+); also elsewhere on the board
DATA_CLK-: U12.H11 (DATA_CLK-); also elsewhere on the board
FB_CLK+: U12.F10 (FB_CLK+); also elsewhere on the board
FB_CLK-: U12.G10 (FB_CLK-); also elsewhere on the board
GND: C65.2, C66.2, C68.2, C69.2, C70.2, C71.2, C72.2, C73.2, C74.2, C75.2, C76.2, C77.2, C78.2, C79.2, C80.2, C81.2, C82.2, C83.2, C84.2, C85.2, C86.2, C87.2, C88.2, C89.2, C90.2, R24.2, R28.2, U12.A1 (RX2A-), U12.A2 (RX2A+), U12.A4 (VssA), U12.A5 (TXMON2), U12.A6 (VssA), U12.A12 (TX_EXT_LO_IN), U12.B1 (VssA), U12.B2 (VssA), U12.B12 (VssA), U12.C2 (VssA), U12.C4 (TEST/ENABLE), U12.C5 (CTRL_IN0), U12.C6 (CTRL_IN1), U12.C7 (VssA), U12.C8 (VssA), U12.C9 (VssA), U12.C10 (VssA), U12.C11 (VssA), U12.C12 (VssA), U12.D5 (CTRL_IN3), U12.D6 (CTRL_IN2), U12.D12 (VssD), U12.E1 (RX2B+), U12.F1 (RX2B-), U12.F3 (VssA), U12.F7 (VssD), U12.F9 (VssD), U12.F11 (VssD), U12.G1 (RX_EXT_LO_IN), U12.G5 (EN_AGC), U12.G12 (VssD), U12.H2 (VssA), U12.H3 (VssA), U12.H5 (SYNC_IN), U12.H6 (VssA), U12.H7 (VssD), U12.H10 (VssD), U12.J2 (VssA), U12.K1 (RX1C+), U12.K2 (VssA), U12.K12 (VssD), U12.L1 (RX1C-), U12.L2 (VssA), U12.L3 (VssA), U12.L5 (AUXADC), U12.L7 (VssA), U12.L8 (VssA), U12.L9 (VssA), U12.L10 (VssA), U12.L11 (VssA), U12.L12 (VssA), U12.M4 (VssA), U12.M5 (TXMON1), U12.M6 (VssA), U13.2 (GND); also elsewhere on the board
LNA_3V0: C88.1, L15.1, U12.B8 (Vdd_GPO); also elsewhere on the board
unnamed: C65.1, L15.2, U13.4 (Vdd)
unnamed: C66.1, R25.1, U13.1 (Vcon)
unnamed: C67.2, U13.3 (OUT)
unnamed: C82.1, R29.2
unnamed: C83.1, R30.2
unnamed: R24.1, U12.L4 (RBIAS)
RX2C+: U12.D1 (RX2C+); also elsewhere on the board
RX2C-: U12.C1 (RX2C-); also elsewhere on the board
RXA+: U12.M1 (RX1A+); also elsewhere on the board
RXA-: U12.M2 (RX1A-); also elsewhere on the board
RXB+: U12.H1 (RX1B+); also elsewhere on the board
RXB-: U12.J1 (RX1B-); also elsewhere on the board
RX_D0+: U12.J12 (P1_D1/RX_D0+); also elsewhere on the board
RX_D0-: U12.K11 (P1_D0/RX_D0-); also elsewhere on the board
RX_D1+: U12.J11 (P1_D3/RX_D1+); also elsewhere on the board
RX_D1-: U12.K10 (P1_D2/RX_D1-); also elsewhere on the board
RX_D2+: U12.J10 (P1_D5/RX_D2+); also elsewhere on the board
RX_D2-: U12.K9 (P1_D4/RX_D2-); also elsewhere on the board
RX_D3+: U12.J9 (P1_D7/RX_D3+); also elsewhere on the board
RX_D3-: U12.K8 (P1_D6/RX_D3-); also elsewhere on the board
RX_D4+: U12.J8 (P1_D9/RX_D4+); also elsewhere on the board
RX_D4-: U12.K7 (P1_D8/RX_D4-); also elsewhere on the board
RX_D5+: U12.H8 (P1_D11/RX_D5+); also elsewhere on the board
RX_D5-: U12.J7 (P1_D10/RX_D5-); also elsewhere on the board
RX_FRAME+: U12.G8 (RX_FRAME+); also elsewhere on the board
RX_FRAME-: U12.G7 (RX_FRAME-); also elsewhere on the board
SPI_MISO: U12.L6 (SPI_MISO); also elsewhere on the board
SPI_MOSI: U12.J4 (SPI_MOSI); also elsewhere on the board
SPI_SCK: U12.J5 (SPI_CLK); also elsewhere on the board
SPI_~CS: U12.K6 (SPI_~EN); also elsewhere on the board
TX2B+: U12.A10 (TX2B+); also elsewhere on the board
TX2B-: U12.A9 (TX2B-); also elsewhere on the board
TXA+: U12.M7 (TX1A+); also elsewhere on the board
TXA-: U12.M8 (TX1A-); also elsewhere on the board
TXB+: U12.M9 (TX1B+); also elsewhere on the board
TXB-: U12.M10 (TX1B-); also elsewhere on the board
TX_D0+: U12.D11 (P0_D1/TX_D0+); also elsewhere on the board
TX_D0-: U12.E12 (P0_D0/TX_D0-); also elsewhere on the board
TX_D1+: U12.D10 (P0_D3/TX_D1+); also elsewhere on the board
TX_D1-: U12.E11 (P0_D2/TX_D1-); also elsewhere on the board
TX_D2+: U12.D9 (P0_D5/TX_D2+); also elsewhere on the board
TX_D2-: U12.E10 (P0_D4/TX_D2-); also elsewhere on the board
TX_D3+: U12.D8 (P0_D7/TX_D3+); also elsewhere on the board
TX_D3-: U12.E9 (P0_D6/TX_D3-); also elsewhere on the board
TX_D4+: U12.D7 (P0_D9/TX_D4+); also elsewhere on the board
TX_D4-: U12.E8 (P0_D8/TX_D4-); also elsewhere on the board
TX_D5+: U12.E7 (P0_D11/TX_D5+); also elsewhere on the board
TX_D5-: U12.F8 (P0_D10/TX_D5-); also elsewhere on the board
TX_FRAME+: U12.G9 (TX_FRAME+); also elsewhere on the board
TX_FRAME-: U12.H9 (TX_FRAME-); also elsewhere on the board
