daveshah1/RFToolSDR/hardware/rftool/rftool.kicad_pcb

## KiCad design hardware/rftool/rftool.kicad_pcb (continued)

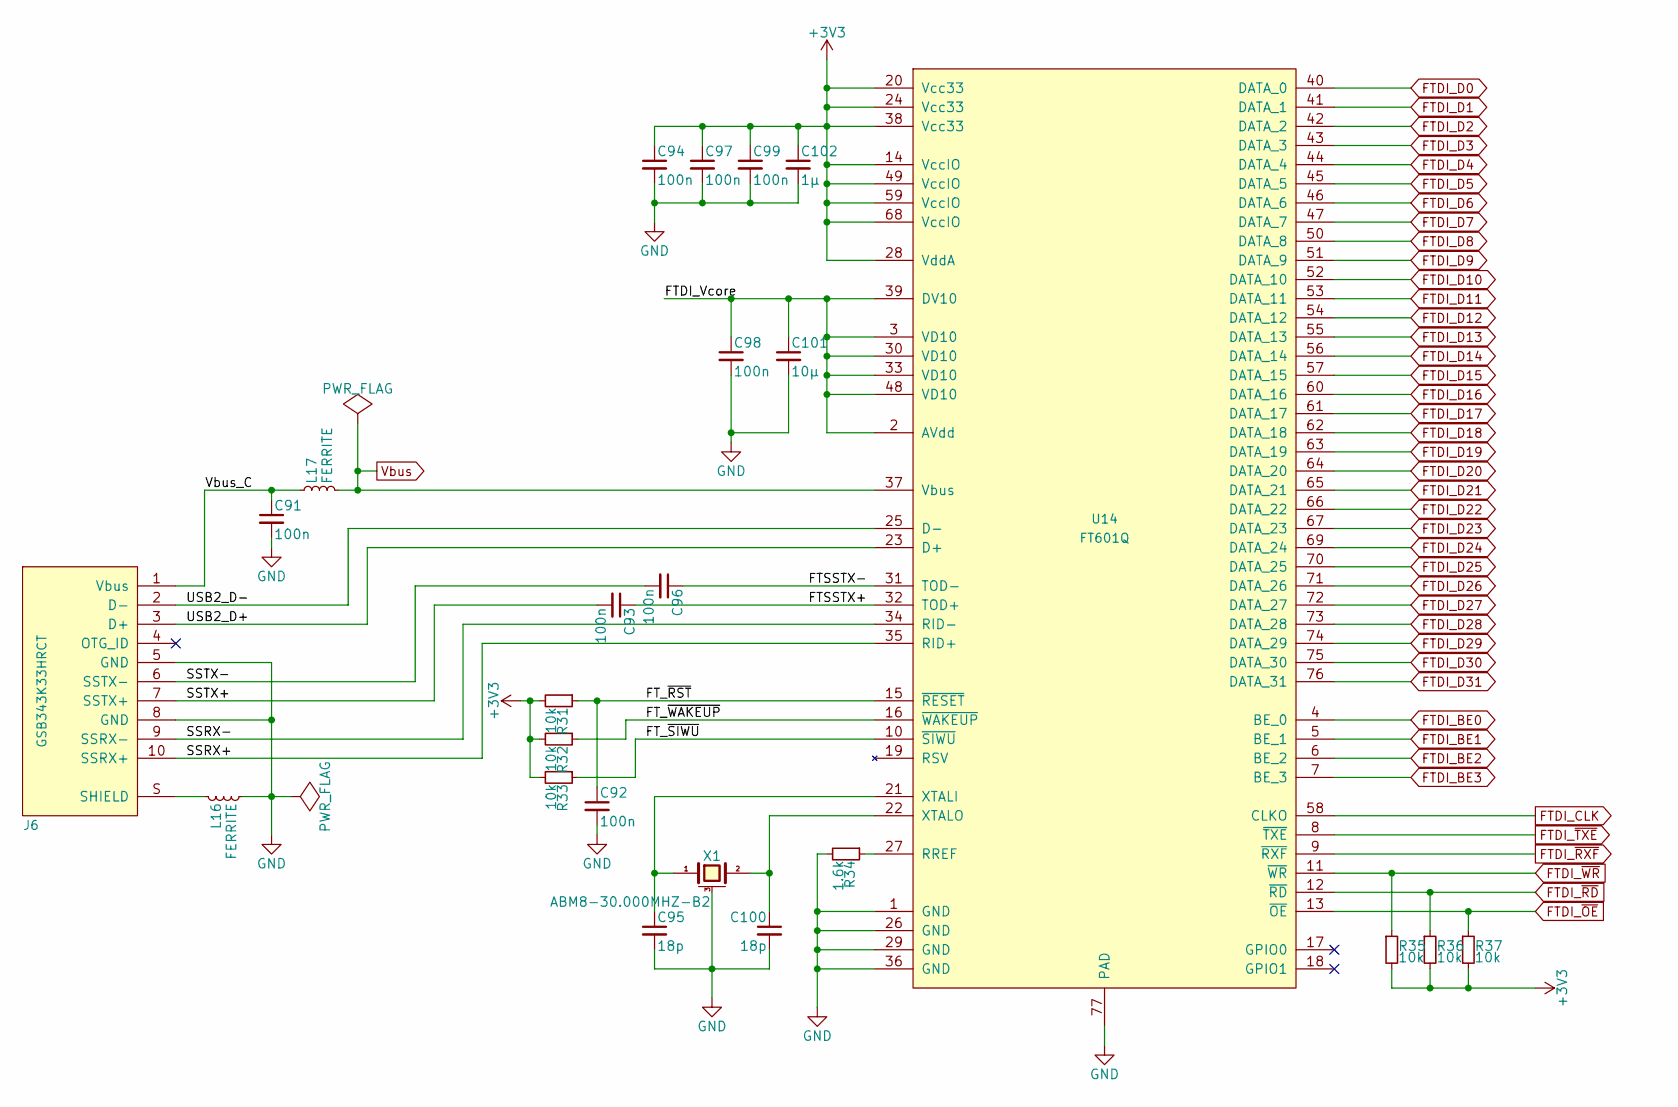
[picture p8: schematic usb.sch, RFTool 70MHz-6GHz SDR]

Parts:
C91, C92, C93, C94, C96, C97, C98, C99: 100n; C_0402
C95, C100: 18p; C_0402
C101: 10µ; C_0805
C102: 1µ; C_0603
J6: GSB343K33HRCT; MICROUSB-GSB343K33HRCTV
L16, L17: FERRITE; C_0805
R31, R32, R33, R35, R36, R37: 10k; R_0402
R34: 1.6k; R_0402
U14: FT601Q; QFN_76_pitch0.4mm
X1: ABM8-30.000MHZ-B2; XTAL_ABM8_3.2x2.5mm

Connections:
+3V3: C94.1, C97.1, C99.1, C102.1, R31.2, R32.2, R33.2, R35.2, R36.2, R37.2, U14.14 (VccIO), U14.20 (Vcc33), U14.24 (Vcc33), U14.28 (VddA), U14.38 (Vcc33), U14.49 (VccIO), U14.59 (VccIO), U14.68 (VccIO); also elsewhere on the board
/USB 3.0 I/F/FTDI_Vcore: C98.1, C101.1, U14.2 (AVdd), U14.3 (VD10), U14.30 (VD10), U14.33 (VD10), U14.39 (DV10), U14.48 (VD10)
/USB 3.0 I/F/FTSSTX+: C93.1, U14.32 (TOD+)
/USB 3.0 I/F/FTSSTX-: C96.1, U14.31 (TOD-)
/USB 3.0 I/F/FT_~RST: C92.1, R31.1, U14.15 (~RESET)
/USB 3.0 I/F/FT_~SIWU: R33.1, U14.10 (~SIWU)
/USB 3.0 I/F/FT_~WAKEUP: R32.1, U14.16 (~WAKEUP)
/USB 3.0 I/F/SSRX+: J6.10 (SSRX+), U14.35 (RID+)
/USB 3.0 I/F/SSRX-: J6.9 (SSRX-), U14.34 (RID-)
/USB 3.0 I/F/SSTX+: C93.2, J6.7 (SSTX+)
/USB 3.0 I/F/SSTX-: C96.2, J6.6 (SSTX-)
/USB 3.0 I/F/USB2_D+: J6.3 (D+), U14.23 (D+)
/USB 3.0 I/F/USB2_D-: J6.2 (D-), U14.25 (D-)
/USB 3.0 I/F/Vbus_C: C91.1, J6.1 (Vbus), L17.1
FTDI_BE0: U14.4 (BE_0); also elsewhere on the board
FTDI_BE1: U14.5 (BE_1); also elsewhere on the board
FTDI_BE2: U14.6 (BE_2); also elsewhere on the board
FTDI_BE3: U14.7 (BE_3); also elsewhere on the board
FTDI_CLK: U14.58 (CLKO); also elsewhere on the board
FTDI_D0: U14.40 (DATA_0); also elsewhere on the board
FTDI_D1: U14.41 (DATA_1); also elsewhere on the board
FTDI_D2: U14.42 (DATA_2); also elsewhere on the board
FTDI_D3: U14.43 (DATA_3); also elsewhere on the board
FTDI_D4: U14.44 (DATA_4); also elsewhere on the board
FTDI_D5: U14.45 (DATA_5); also elsewhere on the board
FTDI_D6: U14.46 (DATA_6); also elsewhere on the board
FTDI_D7: U14.47 (DATA_7); also elsewhere on the board
FTDI_D8: U14.50 (DATA_8); also elsewhere on the board
FTDI_D9: U14.51 (DATA_9); also elsewhere on the board
FTDI_D10: U14.52 (DATA_10); also elsewhere on the board
FTDI_D11: U14.53 (DATA_11); also elsewhere on the board
FTDI_D12: U14.54 (DATA_12); also elsewhere on the board
FTDI_D13: U14.55 (DATA_13); also elsewhere on the board
FTDI_D14: U14.56 (DATA_14); also elsewhere on the board
FTDI_D15: U14.57 (DATA_15); also elsewhere on the board
FTDI_D16: U14.60 (DATA_16); also elsewhere on the board
FTDI_D17: U14.61 (DATA_17); also elsewhere on the board
FTDI_D18: U14.62 (DATA_18); also elsewhere on the board
FTDI_D19: U14.63 (DATA_19); also elsewhere on the board
FTDI_D20: U14.64 (DATA_20); also elsewhere on the board
FTDI_D21: U14.65 (DATA_21); also elsewhere on the board
FTDI_D22: U14.66 (DATA_22); also elsewhere on the board
FTDI_D23: U14.67 (DATA_23); also elsewhere on the board
FTDI_D24: U14.69 (DATA_24); also elsewhere on the board
FTDI_D25: U14.70 (DATA_25); also elsewhere on the board
FTDI_D26: U14.71 (DATA_26); also elsewhere on the board
FTDI_D27: U14.72 (DATA_27); also elsewhere on the board
FTDI_D28: U14.73 (DATA_28); also elsewhere on the board
FTDI_D29: U14.74 (DATA_29); also elsewhere on the board
FTDI_D30: U14.75 (DATA_30); also elsewhere on the board
FTDI_D31: U14.76 (DATA_31); also elsewhere on the board
FTDI_~OE: R37.1, U14.13 (~OE); also elsewhere on the board
FTDI_~RD: R36.1, U14.12 (~RD); also elsewhere on the board
FTDI_~RXF: U14.9 (~RXF); also elsewhere on the board
FTDI_~TXE: U14.8 (~TXE); also elsewhere on the board
FTDI_~WR: R35.1, U14.11 (~WR); also elsewhere on the board
GND: C91.2, C92.2, C94.2, C95.2, C97.2, C98.2, C99.2, C100.2, C101.2, C102.2, J6.5 (GND), J6.8 (GND), L16.2, R34.2, U14.1 (GND), U14.26 (GND), U14.29 (GND), U14.36 (GND), U14.77 (PAD), X1.3 (case); also elsewhere on the board
unnamed: C95.1, U14.21 (XTALI), X1.1
unnamed: C100.1, U14.22 (XTALO), X1.2
unnamed: J6.S (SHIELD), L16.1
unnamed: R34.1, U14.27 (RREF)
Vbus: L17.2, U14.37 (Vbus); also elsewhere on the board

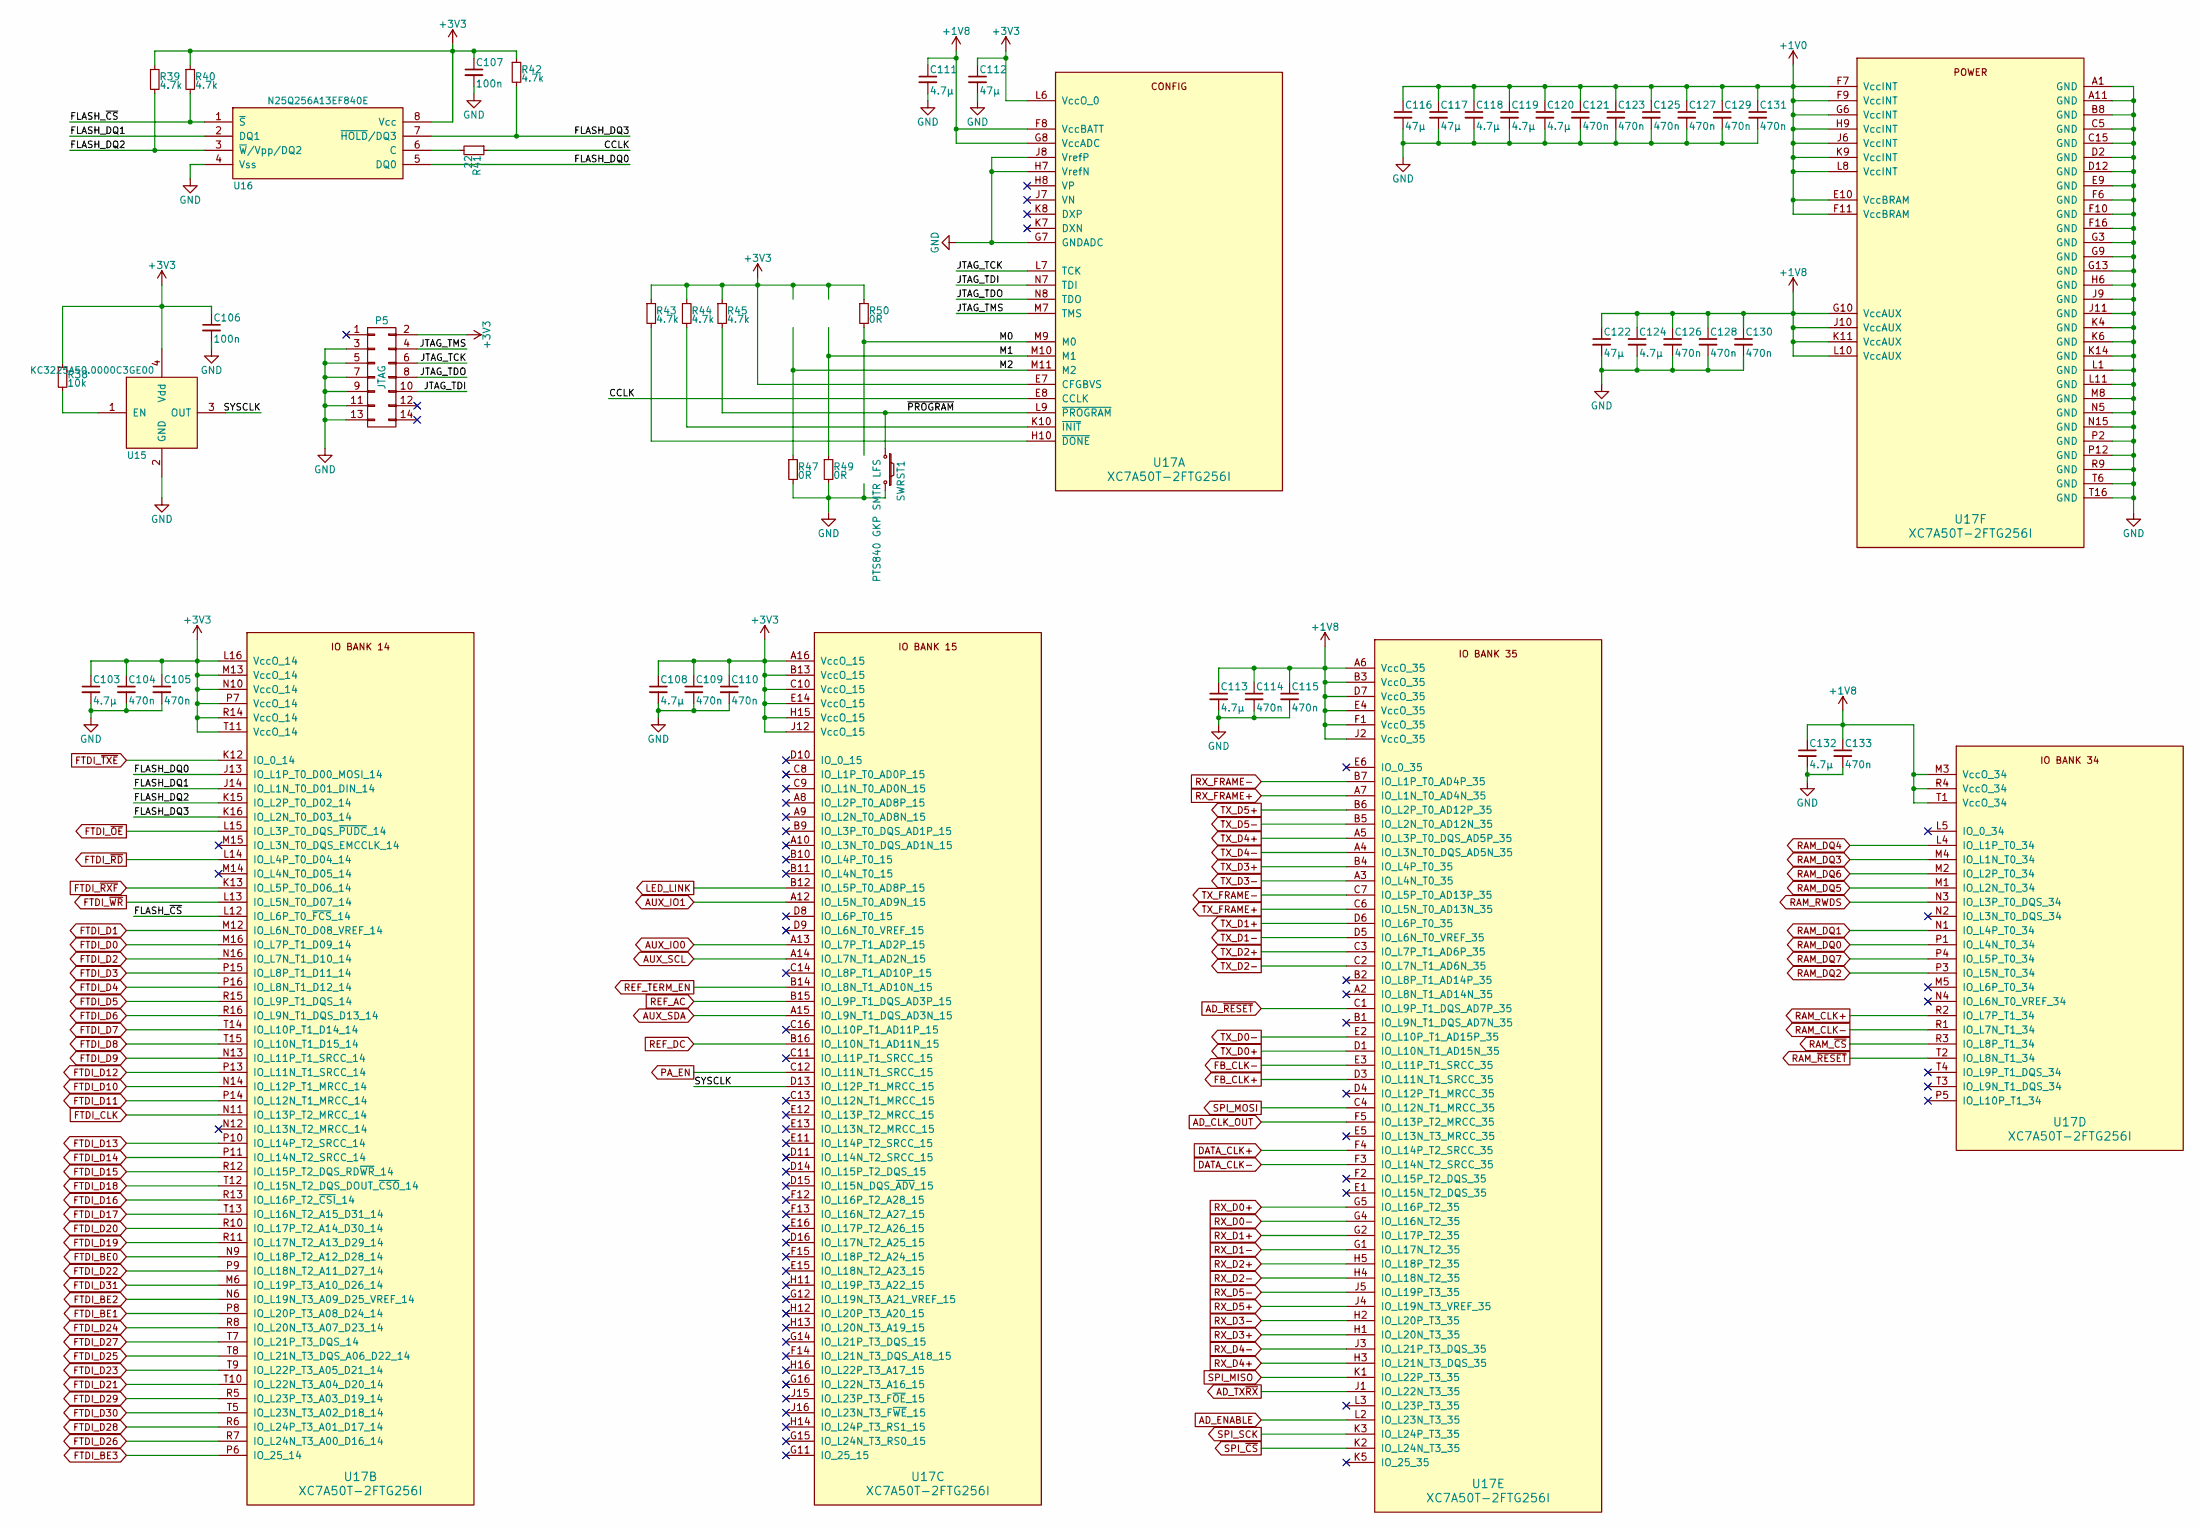
[picture p9: schematic fpga.sch, RFTool 70MHz-6GHz SDR]

Parts:
C103, C108, C111, C113, C118, C119, C120, C124, C132: 4.7µ; C_0805
C104, C105, C109, C110, C114, C115, C121, C123, C125, C126, C127, C128, C129, C130, C131, C133: 470n; C_0402
C106, C107: 100n; C_0402
C112, C116, C117, C122: 47µ; C_1206
P5: JTAG; Pin_Header_Straight_2x07_Pitch2.00mm
R38: 10k; R_0402
R39, R40, R42, R43, R44, R45: 4.7k; R_0402
R41: 22; R_0402
R47, R49, R50: 0R; R_0402
SWRST1: PTS840 GKP SMTR LFS; PTS840G
U15: KC3225A50.0000C3GE00; VCTCXO_TX_3.2x2.5mm
U16: N25Q256A13EF840E; VDFPN8
U17: XC7A50T-2FTG256I; BGA-256

Connections:
+1V0: C116.1, C117.1, C118.1, C119.1, C120.1, C121.1, C123.1, C125.1, C127.1, C129.1, C131.1, U17.E10 (VccBRAM), U17.F7 (VccINT), U17.F9 (VccINT), U17.F11 (VccBRAM), U17.G6 (VccINT), U17.H9 (VccINT), U17.J6 (VccINT), U17.K9 (VccINT), U17.L8 (VccINT); also elsewhere on the board
+1V8: C111.1, C113.1, C114.1, C115.1, C122.1, C124.1, C126.1, C128.1, C130.1, C132.1, C133.1, U17.A6 (VccO_35), U17.B3 (VccO_35), U17.D7 (VccO_35), U17.E4 (VccO_35), U17.F1 (VccO_35), U17.F8 (VccBATT), U17.G8 (VccADC), U17.G10 (VccAUX), U17.J2 (VccO_35), U17.J10 (VccAUX), U17.K11 (VccAUX), U17.L10 (VccAUX), U17.M3 (VccO_34), U17.R4 (VccO_34), U17.T1 (VccO_34); also elsewhere on the board
+3V3: C103.1, C104.1, C105.1, C106.1, C107.1, C108.1, C109.1, C110.1, C112.1, P5.2, R38.1, R39.1, R40.1, R42.1, R43.1, R44.1, R45.1, R50.1, U15.4 (Vdd), U16.8 (Vcc), U17.A16 (VccO_15), U17.B13 (VccO_15), U17.C10 (VccO_15), U17.E7 (CFGBVS), U17.E14 (VccO_15), U17.H15 (VccO_15), U17.J12 (VccO_15), U17.L6 (VccO_0), U17.L16 (VccO_14), U17.M13 (VccO_14), U17.N10 (VccO_14), U17.P7 (VccO_14), U17.R14 (VccO_14), U17.T11 (VccO_14); also elsewhere on the board
/Artix 7 FPGA/CCLK: R41.1, U17.E8 (CCLK)
/Artix 7 FPGA/FLASH_DQ0: U16.5 (DQ0), U17.J13 (IO_L1P_T0_D00_MOSI_14)
/Artix 7 FPGA/FLASH_DQ1: U16.2 (DQ1), U17.J14 (IO_L1N_T0_D01_DIN_14)
/Artix 7 FPGA/FLASH_DQ2: R39.2, U16.3 (~W~/Vpp/DQ2), U17.K15 (IO_L2P_T0_D02_14)
/Artix 7 FPGA/FLASH_DQ3: R42.2, U16.7 (~HOLD~/DQ3), U17.K16 (IO_L2N_T0_D03_14)
/Artix 7 FPGA/FLASH_~CS: R40.2, U16.1 (~S), U17.L12 (IO_L6P_T0_~FCS~_14)
/Artix 7 FPGA/JTAG_TCK: P5.6, U17.L7 (TCK)
/Artix 7 FPGA/JTAG_TDI: P5.10, U17.N7 (TDI)
/Artix 7 FPGA/JTAG_TDO: P5.8, U17.N8 (TDO)
/Artix 7 FPGA/JTAG_TMS: P5.4, U17.M7 (TMS)
/Artix 7 FPGA/M0: R50.2, U17.M9 (M0)
/Artix 7 FPGA/M1: R49.1, U17.M10 (M1)
/Artix 7 FPGA/M2: R47.1, U17.M11 (M2)
/Artix 7 FPGA/SYSCLK: U15.3 (OUT), U17.D13 (IO_L12P_T1_MRCC_15)
/Artix 7 FPGA/~PROGRAM: R45.2, SWRST1.1, U17.L9 (~PROGRAM)
AD_CLK_OUT: U17.F5 (IO_L13P_T2_MRCC_35); also elsewhere on the board
AD_ENABLE: U17.L2 (IO_L23N_T3_35); also elsewhere on the board
AD_TX~RX: U17.J1 (IO_L22N_T3_35); also elsewhere on the board
AD_~RESET: U17.C1 (IO_L9P_T1_DQS_AD7P_35); also elsewhere on the board
AUX_IO0: U17.A13 (IO_L7P_T1_AD2P_15); also elsewhere on the board
AUX_IO1: U17.A12 (IO_L5N_T0_AD9N_15); also elsewhere on the board
AUX_SCL: U17.A14 (IO_L7N_T1_AD2N_15); also elsewhere on the board
AUX_SDA: U17.A15 (IO_L9N_T1_DQS_AD3N_15); also elsewhere on the board
DATA_CLK+: U17.F4 (IO_L14P_T2_SRCC_35); also elsewhere on the board
DATA_CLK-: U17.F3 (IO_L14N_T2_SRCC_35); also elsewhere on the board
FB_CLK+: U17.D3 (IO_L11N_T1_SRCC_35); also elsewhere on the board
FB_CLK-: U17.E3 (IO_L11P_T1_SRCC_35); also elsewhere on the board
FTDI_BE0: U17.N9 (IO_L18P_T2_A12_D28_14); also elsewhere on the board
FTDI_BE1: U17.P8 (IO_L20P_T3_A08_D24_14); also elsewhere on the board
FTDI_BE2: U17.N6 (IO_L19N_T3_A09_D25_VREF_14); also elsewhere on the board
FTDI_BE3: U17.P6 (IO_25_14); also elsewhere on the board
FTDI_CLK: U17.N11 (IO_L13P_T2_MRCC_14); also elsewhere on the board
FTDI_D0: U17.M16 (IO_L7P_T1_D09_14); also elsewhere on the board
FTDI_D1: U17.M12 (IO_L6N_T0_D08_VREF_14); also elsewhere on the board
FTDI_D2: U17.N16 (IO_L7N_T1_D10_14); also elsewhere on the board
FTDI_D3: U17.P15 (IO_L8P_T1_D11_14); also elsewhere on the board
FTDI_D4: U17.P16 (IO_L8N_T1_D12_14); also elsewhere on the board
FTDI_D5: U17.R15 (IO_L9P_T1_DQS_14); also elsewhere on the board
FTDI_D6: U17.R16 (IO_L9N_T1_DQS_D13_14); also elsewhere on the board
FTDI_D7: U17.T14 (IO_L10P_T1_D14_14); also elsewhere on the board
FTDI_D8: U17.T15 (IO_L10N_T1_D15_14); also elsewhere on the board
FTDI_D9: U17.N13 (IO_L11P_T1_SRCC_14); also elsewhere on the board
FTDI_D10: U17.N14 (IO_L12P_T1_MRCC_14); also elsewhere on the board
FTDI_D11: U17.P14 (IO_L12N_T1_MRCC_14); also elsewhere on the board
FTDI_D12: U17.P13 (IO_L11N_T1_SRCC_14); also elsewhere on the board
FTDI_D13: U17.P10 (IO_L14P_T2_SRCC_14); also elsewhere on the board
FTDI_D14: U17.P11 (IO_L14N_T2_SRCC_14); also elsewhere on the board
FTDI_D15: U17.R12 (IO_L15P_T2_DQS_RD~WR~_14); also elsewhere on the board
FTDI_D16: U17.R13 (IO_L16P_T2_~CSI~_14); also elsewhere on the board
FTDI_D17: U17.T13 (IO_L16N_T2_A15_D31_14); also elsewhere on the board
FTDI_D18: U17.T12 (IO_L15N_T2_DQS_DOUT_~CSO~_14); also elsewhere on the board
FTDI_D19: U17.R11 (IO_L17N_T2_A13_D29_14); also elsewhere on the board
FTDI_D20: U17.R10 (IO_L17P_T2_A14_D30_14); also elsewhere on the board
FTDI_D21: U17.T10 (IO_L22N_T3_A04_D20_14); also elsewhere on the board
FTDI_D22: U17.P9 (IO_L18N_T2_A11_D27_14); also elsewhere on the board
FTDI_D23: U17.T9 (IO_L22P_T3_A05_D21_14); also elsewhere on the board
FTDI_D24: U17.R8 (IO_L20N_T3_A07_D23_14); also elsewhere on the board
FTDI_D25: U17.T8 (IO_L21N_T3_DQS_A06_D22_14); also elsewhere on the board
FTDI_D26: U17.R7 (IO_L24N_T3_A00_D16_14); also elsewhere on the board
FTDI_D27: U17.T7 (IO_L21P_T3_DQS_14); also elsewhere on the board
FTDI_D28: U17.R6 (IO_L24P_T3_A01_D17_14); also elsewhere on the board
FTDI_D29: U17.R5 (IO_L23P_T3_A03_D19_14); also elsewhere on the board
FTDI_D30: U17.T5 (IO_L23N_T3_A02_D18_14); also elsewhere on the board
FTDI_D31: U17.M6 (IO_L19P_T3_A10_D26_14); also elsewhere on the board
FTDI_~OE: U17.L15 (IO_L3P_T0_DQS_~PUDC~_14); also elsewhere on the board
FTDI_~RD: U17.L14 (IO_L4P_T0_D04_14); also elsewhere on the board
FTDI_~RXF: U17.K13 (IO_L5P_T0_D06_14); also elsewhere on the board
FTDI_~TXE: U17.K12 (IO_0_14); also elsewhere on the board
FTDI_~WR: U17.L13 (IO_L5N_T0_D07_14); also elsewhere on the board
GND: C103.2, C104.2, C105.2, C106.2, C107.2, C108.2, C109.2, C110.2, C111.2, C112.2, C113.2, C114.2, C115.2, C116.2, C117.2, C118.2, C119.2, C120.2, C121.2, C122.2, C123.2, C124.2, C125.2, C126.2, C127.2, C128.2, C129.2, C130.2, C131.2, C132.2, C133.2, P5.3, P5.5, P5.7, P5.9, P5.11, P5.13, R47.2, R49.2, SWRST1.2, U15.2 (GND), U16.4 (Vss), U17.A1 (GND), U17.A11 (GND), U17.B8 (GND), U17.C5 (GND), U17.C15 (GND), U17.D2 (GND), U17.D12 (GND), U17.E9 (GND), U17.F6 (GND), U17.F10 (GND), U17.F16 (GND), U17.G3 (GND), U17.G7 (GNDADC), U17.G9 (GND), U17.G13 (GND), U17.H6 (GND), U17.H7 (VrefN), U17.J8 (VrefP), U17.J9 (GND), U17.J11 (GND), U17.K4 (GND), U17.K6 (GND), U17.K14 (GND), U17.L1 (GND), U17.L11 (GND), U17.M8 (GND), U17.N5 (GND), U17.N15 (GND), U17.P2 (GND), U17.P12 (GND), U17.R9 (GND), U17.T6 (GND), U17.T16 (GND); also elsewhere on the board
LED_LINK: U17.B12 (IO_L5P_T0_AD8P_15); also elsewhere on the board
unnamed: R38.2, U15.1 (EN)
unnamed: R41.2, U16.6 (C)
unnamed: R43.2, U17.H10 (~DONE)
unnamed: R44.2, U17.K10 (~INIT)
PA_EN: U17.C12 (IO_L11N_T1_SRCC_15); also elsewhere on the board
RAM_CLK+: U17.R2 (IO_L7P_T1_34); also elsewhere on the board
RAM_CLK-: U17.R1 (IO_L7N_T1_34); also elsewhere on the board
RAM_DQ0: U17.P1 (IO_L4N_T0_34); also elsewhere on the board
RAM_DQ1: U17.N1 (IO_L4P_T0_34); also elsewhere on the board
RAM_DQ2: U17.P3 (IO_L5N_T0_34); also elsewhere on the board
RAM_DQ3: U17.M4 (IO_L1N_T0_34); also elsewhere on the board
RAM_DQ4: U17.L4 (IO_L1P_T0_34); also elsewhere on the board
RAM_DQ5: U17.M1 (IO_L2N_T0_34); also elsewhere on the board
RAM_DQ6: U17.M2 (IO_L2P_T0_34); also elsewhere on the board
RAM_DQ7: U17.P4 (IO_L5P_T0_34); also elsewhere on the board
RAM_RWDS: U17.N3 (IO_L3P_T0_DQS_34); also elsewhere on the board
RAM_~CS: U17.R3 (IO_L8P_T1_34); also elsewhere on the board
RAM_~RESET: U17.T2 (IO_L8N_T1_34); also elsewhere on the board
REF_AC: U17.B15 (IO_L9P_T1_DQS_AD3P_15); also elsewhere on the board
REF_DC: U17.B16 (IO_L10N_T1_AD11N_15); also elsewhere on the board
REF_TERM_EN: U17.B14 (IO_L8N_T1_AD10N_15); also elsewhere on the board
RX_D0+: U17.G5 (IO_L16P_T2_35); also elsewhere on the board
RX_D0-: U17.G4 (IO_L16N_T2_35); also elsewhere on the board
RX_D1+: U17.G2 (IO_L17P_T2_35); also elsewhere on the board
RX_D1-: U17.G1 (IO_L17N_T2_35); also elsewhere on the board
RX_D2+: U17.H5 (IO_L18P_T2_35); also elsewhere on the board
RX_D2-: U17.H4 (IO_L18N_T2_35); also elsewhere on the board
RX_D3+: U17.H1 (IO_L20N_T3_35); also elsewhere on the board
RX_D3-: U17.H2 (IO_L20P_T3_35); also elsewhere on the board
RX_D4+: U17.H3 (IO_L21N_T3_DQS_35); also elsewhere on the board
RX_D4-: U17.J3 (IO_L21P_T3_DQS_35); also elsewhere on the board
RX_D5+: U17.J4 (IO_L19N_T3_VREF_35); also elsewhere on the board
RX_D5-: U17.J5 (IO_L19P_T3_35); also elsewhere on the board
RX_FRAME+: U17.A7 (IO_L1N_T0_AD4N_35); also elsewhere on the board
RX_FRAME-: U17.B7 (IO_L1P_T0_AD4P_35); also elsewhere on the board
SPI_MISO: U17.K1 (IO_L22P_T3_35); also elsewhere on the board
SPI_MOSI: U17.C4 (IO_L12N_T1_MRCC_35); also elsewhere on the board
SPI_SCK: U17.K3 (IO_L24P_T3_35); also elsewhere on the board
SPI_~CS: U17.K2 (IO_L24N_T3_35); also elsewhere on the board
TX_D0+: U17.D1 (IO_L10N_T1_AD15N_35); also elsewhere on the board
TX_D0-: U17.E2 (IO_L10P_T1_AD15P_35); also elsewhere on the board
TX_D1+: U17.D6 (IO_L6P_T0_35); also elsewhere on the board
TX_D1-: U17.D5 (IO_L6N_T0_VREF_35); also elsewhere on the board
TX_D2+: U17.C3 (IO_L7P_T1_AD6P_35); also elsewhere on the board
TX_D2-: U17.C2 (IO_L7N_T1_AD6N_35); also elsewhere on the board
TX_D3+: U17.B4 (IO_L4P_T0_35); also elsewhere on the board
TX_D3-: U17.A3 (IO_L4N_T0_35); also elsewhere on the board
TX_D4+: U17.A5 (IO_L3P_T0_DQS_AD5P_35); also elsewhere on the board
TX_D4-: U17.A4 (IO_L3N_T0_DQS_AD5N_35); also elsewhere on the board
TX_D5+: U17.B6 (IO_L2P_T0_AD12P_35); also elsewhere on the board
TX_D5-: U17.B5 (IO_L2N_T0_AD12N_35); also elsewhere on the board
TX_FRAME+: U17.C6 (IO_L5N_T0_AD13N_35); also elsewhere on the board
TX_FRAME-: U17.C7 (IO_L5P_T0_AD13P_35); also elsewhere on the board

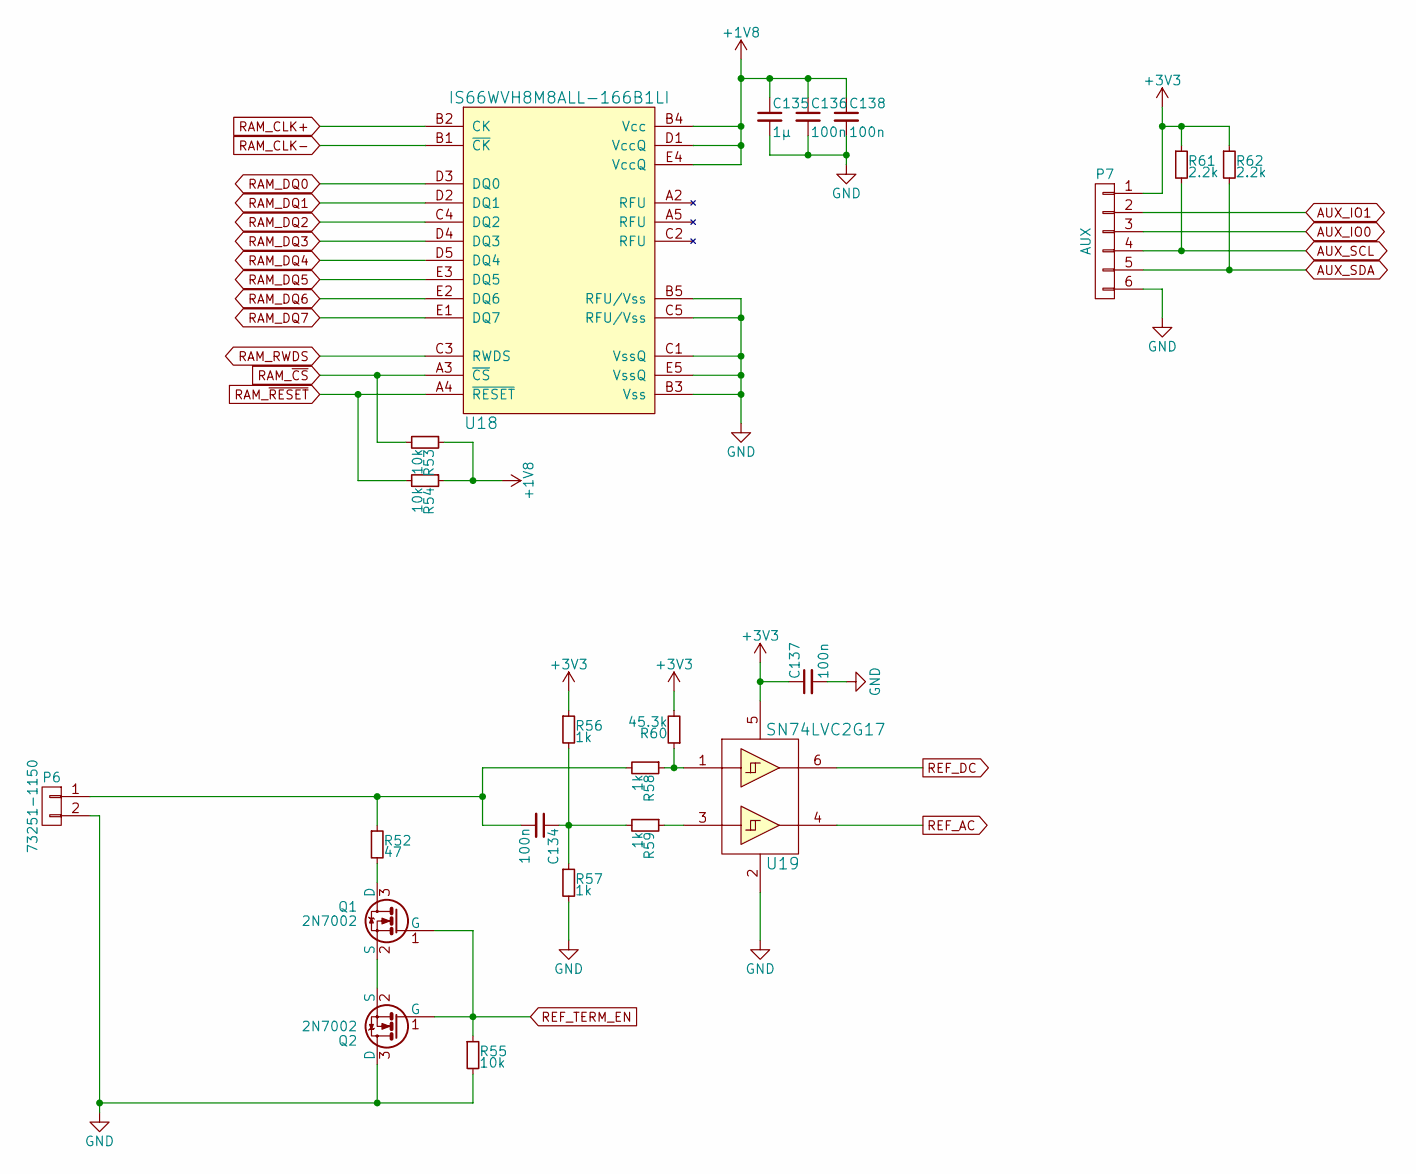
[picture p10: schematic periph.sch, RFTool 70MHz-6GHz SDR]

Parts:
C134, C136, C137, C138: 100n; C_0402
C135: 1µ; C_0603
P6: 73251-1150; SMA-EDGE-73251-1150
P7: AUX; Pin_Header_Angled_1x06
Q1, Q2: 2N7002; SOT-23
R52: 47; R_0402
R53, R54, R55: 10k; R_0402
R56, R57, R58, R59: 1k; R_0402
R60: 45.3k; R_0402
R61, R62: 2.2k; R_0402
U18: IS66WVH8M8ALL-166B1LI; FBGA24_pitch1mm
U19: SN74LVC2G17; SOT-23-6

Connections:
+1V8: C135.1, C136.1, C138.1, R53.1, R54.1, U18.B4 (Vcc), U18.D1 (VccQ), U18.E4 (VccQ); also elsewhere on the board
+3V3: C137.1, P7.1, R56.1, R60.2, R61.1, R62.1, U19.5 (Vcc); also elsewhere on the board
AUX_IO0: P7.3; also elsewhere on the board
AUX_IO1: P7.2; also elsewhere on the board
AUX_SCL: P7.4, R61.2; also elsewhere on the board
AUX_SDA: P7.5, R62.2; also elsewhere on the board
GND: C135.2, C136.2, C137.2, C138.2, P6.2, P7.6, Q2.3 (D), R55.2, R57.2, U18.B3 (Vss), U18.B5 (RFU/Vss), U18.C1 (VssQ), U18.C5 (RFU/Vss), U18.E5 (VssQ), U19.2 (GND); also elsewhere on the board
unnamed: C134.1, R56.2, R57.1, R59.2
unnamed: C134.2, P6.1, R52.1, R58.2
unnamed: Q1.2 (S), Q2.2 (S)
unnamed: Q1.3 (D), R52.2
unnamed: R58.1, R60.1, U19.1 (1A)
unnamed: R59.1, U19.3 (2A)
RAM_CLK+: U18.B2 (CK); also elsewhere on the board
RAM_CLK-: U18.B1 (~CK); also elsewhere on the board
RAM_DQ0: U18.D3 (DQ0); also elsewhere on the board
RAM_DQ1: U18.D2 (DQ1); also elsewhere on the board
RAM_DQ2: U18.C4 (DQ2); also elsewhere on the board
RAM_DQ3: U18.D4 (DQ3); also elsewhere on the board
RAM_DQ4: U18.D5 (DQ4); also elsewhere on the board
RAM_DQ5: U18.E3 (DQ5); also elsewhere on the board
RAM_DQ6: U18.E2 (DQ6); also elsewhere on the board
RAM_DQ7: U18.E1 (DQ7); also elsewhere on the board
RAM_RWDS: U18.C3 (RWDS); also elsewhere on the board
RAM_~CS: R53.2, U18.A3 (~CS); also elsewhere on the board
RAM_~RESET: R54.2, U18.A4 (~RESET); also elsewhere on the board
REF_AC: U19.4 (Y); also elsewhere on the board
REF_DC: U19.6 (1Y); also elsewhere on the board
REF_TERM_EN: Q1.1 (G), Q2.1 (G), R55.1; also elsewhere on the board

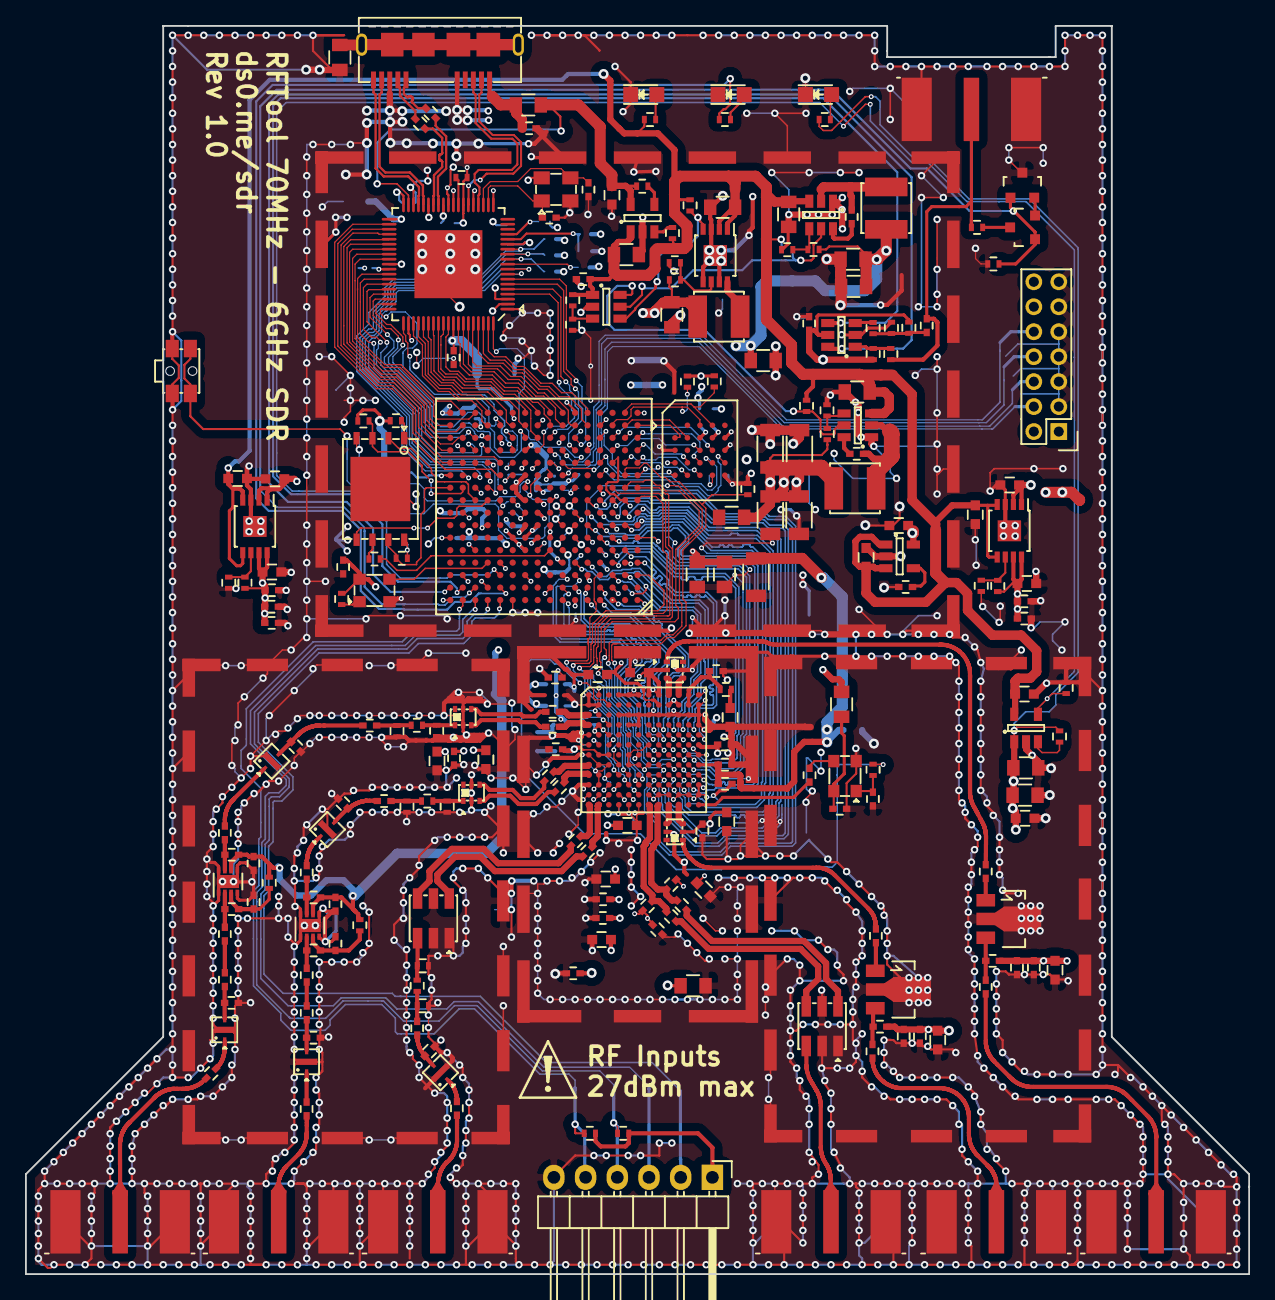
[picture p11: board rftool.kicad_pcb from above]

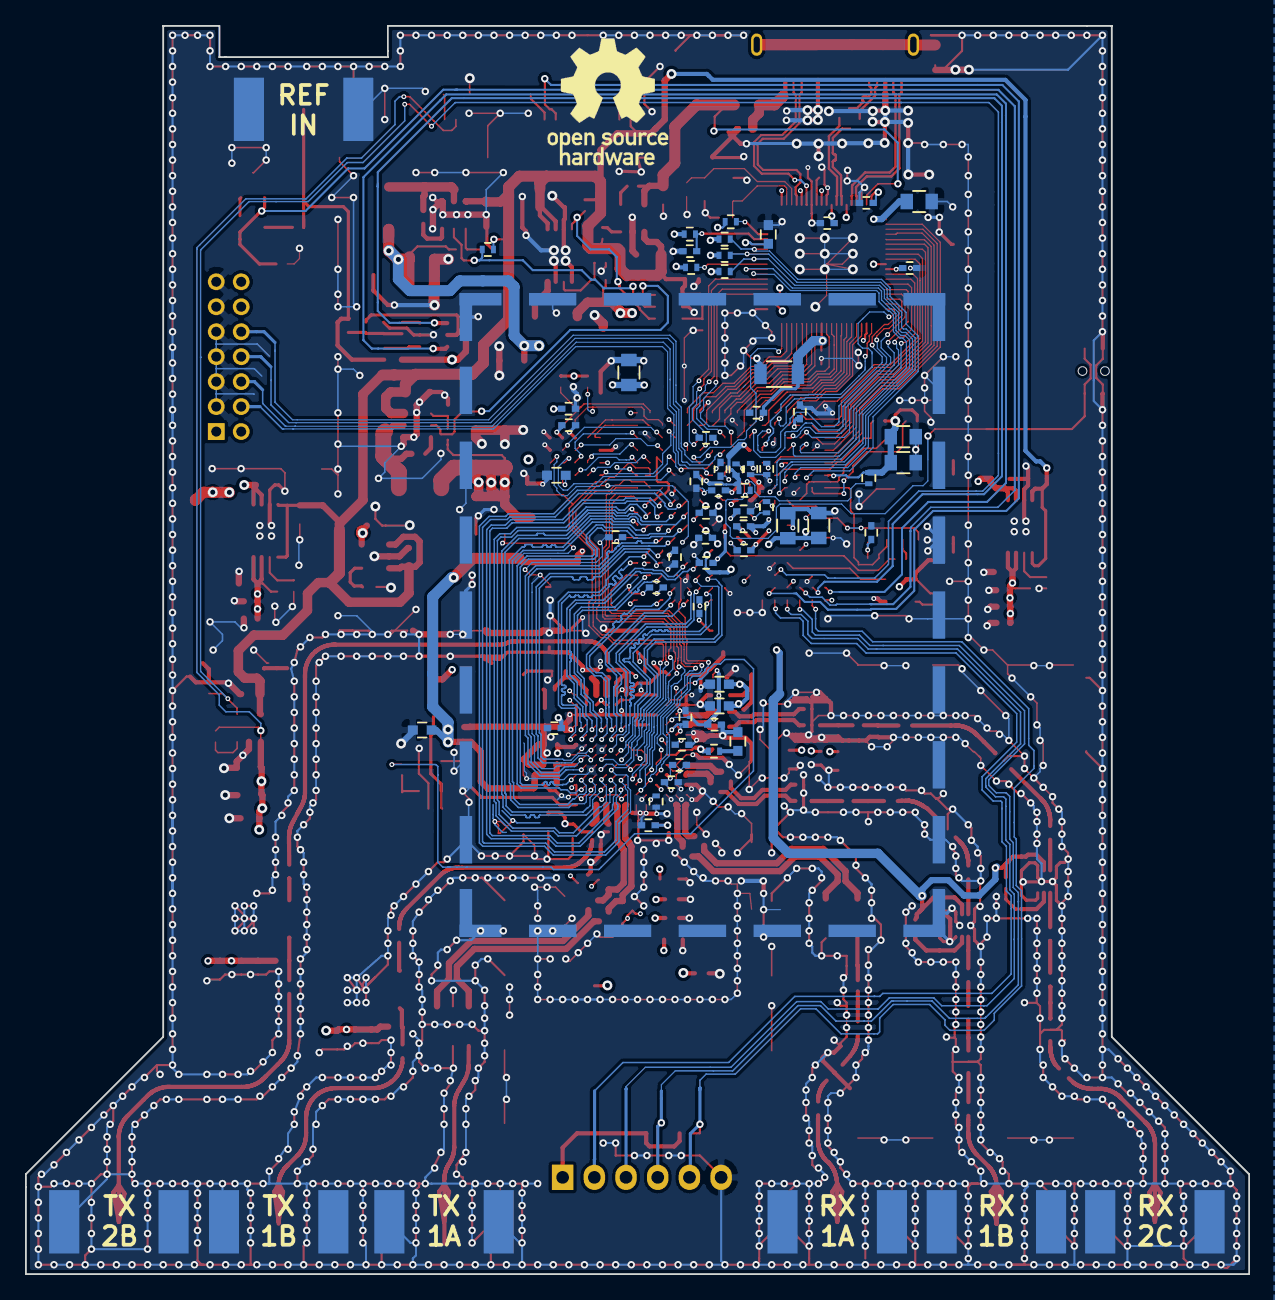
[picture p12: board rftool.kicad_pcb from below]

Board: 4 copper layers, 98.0 x 100.0 mm, 290 parts (59 on the bottom side), 243 nets.
