daveshah1/RFToolSDR/fpga/projects/rx_only/rx_only.runs/synth_1/.Xil/rx_only_top_propImpl.xdc

set_property SRC_FILE_INFO {cfile:/home/dave/misc-projects/rftool-fpga/projects/rx_only/rx_only.srcs/constrs_1/new/rftool_rev1.xdc rfile:../../../rx_only.srcs/constrs_1/new/rftool_rev1.xdc id:1} [current_design]
set_property src_info {type:XDC file:1 line:1 export:INPUT save:INPUT read:READ} [current_design]
set_property PACKAGE_PIN F5 [get_ports ad_clock]
set_property src_info {type:XDC file:1 line:2 export:INPUT save:INPUT read:READ} [current_design]
set_property PACKAGE_PIN F3 [get_ports ad_data_clock_n]
set_property src_info {type:XDC file:1 line:3 export:INPUT save:INPUT read:READ} [current_design]
set_property PACKAGE_PIN F4 [get_ports ad_data_clock_p]
set_property src_info {type:XDC file:1 line:4 export:INPUT save:INPUT read:READ} [current_design]
set_property PACKAGE_PIN L2 [get_ports ad_enable]
set_property src_info {type:XDC file:1 line:5 export:INPUT save:INPUT read:READ} [current_design]
set_property PACKAGE_PIN D3 [get_ports ad_fb_clock_p]
set_property src_info {type:XDC file:1 line:6 export:INPUT save:INPUT read:READ} [current_design]
set_property PACKAGE_PIN E3 [get_ports ad_fb_clock_n]
set_property src_info {type:XDC file:1 line:7 export:INPUT save:INPUT read:READ} [current_design]
set_property PACKAGE_PIN D1 [get_ports {ad_p0_d[1]}]
set_property src_info {type:XDC file:1 line:8 export:INPUT save:INPUT read:READ} [current_design]
set_property PACKAGE_PIN E2 [get_ports {ad_p0_d[0]}]
set_property src_info {type:XDC file:1 line:9 export:INPUT save:INPUT read:READ} [current_design]
set_property PACKAGE_PIN D5 [get_ports {ad_p0_d[2]}]
set_property src_info {type:XDC file:1 line:10 export:INPUT save:INPUT read:READ} [current_design]
set_property PACKAGE_PIN D6 [get_ports {ad_p0_d[3]}]
set_property src_info {type:XDC file:1 line:11 export:INPUT save:INPUT read:READ} [current_design]
set_property PACKAGE_PIN C3 [get_ports {ad_p0_d[5]}]
set_property src_info {type:XDC file:1 line:12 export:INPUT save:INPUT read:READ} [current_design]
set_property PACKAGE_PIN C2 [get_ports {ad_p0_d[4]}]
set_property src_info {type:XDC file:1 line:13 export:INPUT save:INPUT read:READ} [current_design]
set_property PACKAGE_PIN B4 [get_ports {ad_p0_d[7]}]
set_property src_info {type:XDC file:1 line:14 export:INPUT save:INPUT read:READ} [current_design]
set_property PACKAGE_PIN A3 [get_ports {ad_p0_d[6]}]
set_property src_info {type:XDC file:1 line:15 export:INPUT save:INPUT read:READ} [current_design]
set_property PACKAGE_PIN A5 [get_ports {ad_p0_d[9]}]
set_property src_info {type:XDC file:1 line:16 export:INPUT save:INPUT read:READ} [current_design]
set_property PACKAGE_PIN A4 [get_ports {ad_p0_d[8]}]
set_property src_info {type:XDC file:1 line:17 export:INPUT save:INPUT read:READ} [current_design]
set_property PACKAGE_PIN B6 [get_ports {ad_p0_d[11]}]
set_property src_info {type:XDC file:1 line:18 export:INPUT save:INPUT read:READ} [current_design]
set_property PACKAGE_PIN B5 [get_ports {ad_p0_d[10]}]
set_property src_info {type:XDC file:1 line:19 export:INPUT save:INPUT read:READ} [current_design]
set_property PACKAGE_PIN G5 [get_ports {ad_p1_d[1]}]
set_property src_info {type:XDC file:1 line:20 export:INPUT save:INPUT read:READ} [current_design]
set_property PACKAGE_PIN G4 [get_ports {ad_p1_d[0]}]
set_property src_info {type:XDC file:1 line:21 export:INPUT save:INPUT read:READ} [current_design]
set_property PACKAGE_PIN G1 [get_ports {ad_p1_d[2]}]
set_property src_info {type:XDC file:1 line:22 export:INPUT save:INPUT read:READ} [current_design]
set_property PACKAGE_PIN G2 [get_ports {ad_p1_d[3]}]
set_property src_info {type:XDC file:1 line:23 export:INPUT save:INPUT read:READ} [current_design]
set_property PACKAGE_PIN H4 [get_ports {ad_p1_d[4]}]
set_property src_info {type:XDC file:1 line:24 export:INPUT save:INPUT read:READ} [current_design]
set_property PACKAGE_PIN H5 [get_ports {ad_p1_d[5]}]
set_property src_info {type:XDC file:1 line:25 export:INPUT save:INPUT read:READ} [current_design]
set_property PACKAGE_PIN H2 [get_ports {ad_p1_d[6]}]
set_property src_info {type:XDC file:1 line:26 export:INPUT save:INPUT read:READ} [current_design]
set_property PACKAGE_PIN H1 [get_ports {ad_p1_d[7]}]
set_property src_info {type:XDC file:1 line:27 export:INPUT save:INPUT read:READ} [current_design]
set_property PACKAGE_PIN J3 [get_ports {ad_p1_d[8]}]
set_property src_info {type:XDC file:1 line:28 export:INPUT save:INPUT read:READ} [current_design]
set_property PACKAGE_PIN H3 [get_ports {ad_p1_d[9]}]
set_property src_info {type:XDC file:1 line:29 export:INPUT save:INPUT read:READ} [current_design]
set_property PACKAGE_PIN J4 [get_ports {ad_p1_d[11]}]
set_property src_info {type:XDC file:1 line:30 export:INPUT save:INPUT read:READ} [current_design]
set_property PACKAGE_PIN J5 [get_ports {ad_p1_d[10]}]
set_property src_info {type:XDC file:1 line:31 export:INPUT save:INPUT read:READ} [current_design]
set_property PACKAGE_PIN C1 [get_ports ad_reset]
set_property src_info {type:XDC file:1 line:32 export:INPUT save:INPUT read:READ} [current_design]
set_property PACKAGE_PIN B7 [get_ports ad_rx_frame_n]
set_property src_info {type:XDC file:1 line:33 export:INPUT save:INPUT read:READ} [current_design]
set_property PACKAGE_PIN A7 [get_ports ad_rx_frame_p]
set_property src_info {type:XDC file:1 line:34 export:INPUT save:INPUT read:READ} [current_design]
set_property PACKAGE_PIN K3 [get_ports ad_spi_clk]
set_property src_info {type:XDC file:1 line:35 export:INPUT save:INPUT read:READ} [current_design]
set_property PACKAGE_PIN K2 [get_ports ad_spi_csn]
set_property src_info {type:XDC file:1 line:36 export:INPUT save:INPUT read:READ} [current_design]
set_property PACKAGE_PIN K1 [get_ports ad_spi_miso]
set_property src_info {type:XDC file:1 line:37 export:INPUT save:INPUT read:READ} [current_design]
set_property PACKAGE_PIN C4 [get_ports ad_spi_mosi]
set_property src_info {type:XDC file:1 line:38 export:INPUT save:INPUT read:READ} [current_design]
set_property PACKAGE_PIN C7 [get_ports ad_tx_frame_n]
set_property src_info {type:XDC file:1 line:39 export:INPUT save:INPUT read:READ} [current_design]
set_property PACKAGE_PIN C6 [get_ports ad_tx_frame_p]
set_property src_info {type:XDC file:1 line:40 export:INPUT save:INPUT read:READ} [current_design]
set_property PACKAGE_PIN J1 [get_ports ad_txnrx]
set_property src_info {type:XDC file:1 line:41 export:INPUT save:INPUT read:READ} [current_design]
set_property PACKAGE_PIN A13 [get_ports aux_io0]
set_property src_info {type:XDC file:1 line:42 export:INPUT save:INPUT read:READ} [current_design]
set_property PACKAGE_PIN A12 [get_ports aux_io1]
set_property src_info {type:XDC file:1 line:43 export:INPUT save:INPUT read:READ} [current_design]
set_property PACKAGE_PIN A14 [get_ports aux_scl]
set_property src_info {type:XDC file:1 line:44 export:INPUT save:INPUT read:READ} [current_design]
set_property PACKAGE_PIN A15 [get_ports aux_sda]
set_property src_info {type:XDC file:1 line:45 export:INPUT save:INPUT read:READ} [current_design]
set_property PACKAGE_PIN N9 [get_ports {ftdi_be[0]}]
set_property src_info {type:XDC file:1 line:46 export:INPUT save:INPUT read:READ} [current_design]
set_property PACKAGE_PIN P8 [get_ports {ftdi_be[1]}]
set_property src_info {type:XDC file:1 line:47 export:INPUT save:INPUT read:READ} [current_design]
set_property PACKAGE_PIN N6 [get_ports {ftdi_be[2]}]
set_property src_info {type:XDC file:1 line:48 export:INPUT save:INPUT read:READ} [current_design]
set_property PACKAGE_PIN P6 [get_ports {ftdi_be[3]}]
set_property src_info {type:XDC file:1 line:49 export:INPUT save:INPUT read:READ} [current_design]
set_property PACKAGE_PIN N11 [get_ports ftdi_clock]
set_property src_info {type:XDC file:1 line:50 export:INPUT save:INPUT read:READ} [current_design]
set_property PACKAGE_PIN M16 [get_ports {ftdi_data[0]}]
set_property src_info {type:XDC file:1 line:51 export:INPUT save:INPUT read:READ} [current_design]
set_property PACKAGE_PIN M12 [get_ports {ftdi_data[1]}]
set_property src_info {type:XDC file:1 line:52 export:INPUT save:INPUT read:READ} [current_design]
set_property PACKAGE_PIN N16 [get_ports {ftdi_data[2]}]
set_property src_info {type:XDC file:1 line:53 export:INPUT save:INPUT read:READ} [current_design]
set_property PACKAGE_PIN P15 [get_ports {ftdi_data[3]}]
set_property src_info {type:XDC file:1 line:54 export:INPUT save:INPUT read:READ} [current_design]
set_property PACKAGE_PIN P16 [get_ports {ftdi_data[4]}]
set_property src_info {type:XDC file:1 line:55 export:INPUT save:INPUT read:READ} [current_design]
set_property PACKAGE_PIN R15 [get_ports {ftdi_data[5]}]
set_property src_info {type:XDC file:1 line:56 export:INPUT save:INPUT read:READ} [current_design]
set_property PACKAGE_PIN R16 [get_ports {ftdi_data[6]}]
set_property src_info {type:XDC file:1 line:57 export:INPUT save:INPUT read:READ} [current_design]
set_property PACKAGE_PIN T14 [get_ports {ftdi_data[7]}]
set_property src_info {type:XDC file:1 line:58 export:INPUT save:INPUT read:READ} [current_design]
set_property PACKAGE_PIN T15 [get_ports {ftdi_data[8]}]
set_property src_info {type:XDC file:1 line:59 export:INPUT save:INPUT read:READ} [current_design]
set_property PACKAGE_PIN N13 [get_ports {ftdi_data[9]}]
set_property src_info {type:XDC file:1 line:60 export:INPUT save:INPUT read:READ} [current_design]
set_property PACKAGE_PIN P13 [get_ports {ftdi_data[12]}]
set_property src_info {type:XDC file:1 line:61 export:INPUT save:INPUT read:READ} [current_design]
set_property PACKAGE_PIN N14 [get_ports {ftdi_data[10]}]
set_property src_info {type:XDC file:1 line:62 export:INPUT save:INPUT read:READ} [current_design]
set_property PACKAGE_PIN P14 [get_ports {ftdi_data[11]}]
set_property src_info {type:XDC file:1 line:63 export:INPUT save:INPUT read:READ} [current_design]
set_property PACKAGE_PIN P10 [get_ports {ftdi_data[13]}]
set_property src_info {type:XDC file:1 line:64 export:INPUT save:INPUT read:READ} [current_design]
set_property PACKAGE_PIN P11 [get_ports {ftdi_data[14]}]
set_property src_info {type:XDC file:1 line:65 export:INPUT save:INPUT read:READ} [current_design]
set_property PACKAGE_PIN R12 [get_ports {ftdi_data[15]}]
set_property src_info {type:XDC file:1 line:66 export:INPUT save:INPUT read:READ} [current_design]
set_property PACKAGE_PIN R13 [get_ports {ftdi_data[16]}]
set_property src_info {type:XDC file:1 line:67 export:INPUT save:INPUT read:READ} [current_design]
set_property PACKAGE_PIN T13 [get_ports {ftdi_data[17]}]
set_property src_info {type:XDC file:1 line:68 export:INPUT save:INPUT read:READ} [current_design]
set_property PACKAGE_PIN T12 [get_ports {ftdi_data[18]}]
set_property src_info {type:XDC file:1 line:69 export:INPUT save:INPUT read:READ} [current_design]
set_property PACKAGE_PIN R11 [get_ports {ftdi_data[19]}]
set_property src_info {type:XDC file:1 line:70 export:INPUT save:INPUT read:READ} [current_design]
set_property PACKAGE_PIN R10 [get_ports {ftdi_data[20]}]
set_property src_info {type:XDC file:1 line:71 export:INPUT save:INPUT read:READ} [current_design]
set_property PACKAGE_PIN T10 [get_ports {ftdi_data[21]}]
set_property src_info {type:XDC file:1 line:72 export:INPUT save:INPUT read:READ} [current_design]
set_property PACKAGE_PIN P9 [get_ports {ftdi_data[22]}]
set_property src_info {type:XDC file:1 line:73 export:INPUT save:INPUT read:READ} [current_design]
set_property PACKAGE_PIN T9 [get_ports {ftdi_data[23]}]
set_property src_info {type:XDC file:1 line:74 export:INPUT save:INPUT read:READ} [current_design]
set_property PACKAGE_PIN R8 [get_ports {ftdi_data[24]}]
set_property src_info {type:XDC file:1 line:75 export:INPUT save:INPUT read:READ} [current_design]
set_property PACKAGE_PIN T8 [get_ports {ftdi_data[25]}]
set_property src_info {type:XDC file:1 line:76 export:INPUT save:INPUT read:READ} [current_design]
set_property PACKAGE_PIN R7 [get_ports {ftdi_data[26]}]
set_property src_info {type:XDC file:1 line:77 export:INPUT save:INPUT read:READ} [current_design]
set_property PACKAGE_PIN T7 [get_ports {ftdi_data[27]}]
set_property src_info {type:XDC file:1 line:78 export:INPUT save:INPUT read:READ} [current_design]
set_property PACKAGE_PIN R6 [get_ports {ftdi_data[28]}]
set_property src_info {type:XDC file:1 line:79 export:INPUT save:INPUT read:READ} [current_design]
set_property PACKAGE_PIN R5 [get_ports {ftdi_data[29]}]
set_property src_info {type:XDC file:1 line:80 export:INPUT save:INPUT read:READ} [current_design]
set_property PACKAGE_PIN T5 [get_ports {ftdi_data[30]}]
set_property src_info {type:XDC file:1 line:81 export:INPUT save:INPUT read:READ} [current_design]
set_property PACKAGE_PIN M6 [get_ports {ftdi_data[31]}]
set_property src_info {type:XDC file:1 line:82 export:INPUT save:INPUT read:READ} [current_design]
set_property PACKAGE_PIN L15 [get_ports ftdi_oe_n]
set_property src_info {type:XDC file:1 line:83 export:INPUT save:INPUT read:READ} [current_design]
set_property PACKAGE_PIN L14 [get_ports ftdi_rd_n]
set_property src_info {type:XDC file:1 line:84 export:INPUT save:INPUT read:READ} [current_design]
set_property PACKAGE_PIN K13 [get_ports ftdi_rxf_n]
set_property src_info {type:XDC file:1 line:85 export:INPUT save:INPUT read:READ} [current_design]
set_property PACKAGE_PIN K12 [get_ports ftdi_txe_n]
set_property src_info {type:XDC file:1 line:86 export:INPUT save:INPUT read:READ} [current_design]
set_property PACKAGE_PIN L13 [get_ports ftdi_wr_n]
set_property src_info {type:XDC file:1 line:87 export:INPUT save:INPUT read:READ} [current_design]
set_property PACKAGE_PIN B12 [get_ports led_link]
set_property src_info {type:XDC file:1 line:88 export:INPUT save:INPUT read:READ} [current_design]
set_property PACKAGE_PIN C12 [get_ports pa_en]
set_property src_info {type:XDC file:1 line:89 export:INPUT save:INPUT read:READ} [current_design]
set_property PACKAGE_PIN R1 [get_ports ram_clk_n]
set_property src_info {type:XDC file:1 line:90 export:INPUT save:INPUT read:READ} [current_design]
set_property PACKAGE_PIN R2 [get_ports ram_clk_p]
set_property src_info {type:XDC file:1 line:91 export:INPUT save:INPUT read:READ} [current_design]
set_property PACKAGE_PIN R3 [get_ports ram_csn]
set_property src_info {type:XDC file:1 line:92 export:INPUT save:INPUT read:READ} [current_design]
set_property PACKAGE_PIN P1 [get_ports {ram_dq[0]}]
set_property src_info {type:XDC file:1 line:93 export:INPUT save:INPUT read:READ} [current_design]
set_property PACKAGE_PIN N1 [get_ports {ram_dq[1]}]
set_property src_info {type:XDC file:1 line:94 export:INPUT save:INPUT read:READ} [current_design]
set_property PACKAGE_PIN P3 [get_ports {ram_dq[2]}]
set_property src_info {type:XDC file:1 line:95 export:INPUT save:INPUT read:READ} [current_design]
set_property PACKAGE_PIN M4 [get_ports {ram_dq[3]}]
set_property src_info {type:XDC file:1 line:96 export:INPUT save:INPUT read:READ} [current_design]
set_property PACKAGE_PIN L4 [get_ports {ram_dq[4]}]
set_property src_info {type:XDC file:1 line:97 export:INPUT save:INPUT read:READ} [current_design]
set_property PACKAGE_PIN M1 [get_ports {ram_dq[5]}]
set_property src_info {type:XDC file:1 line:98 export:INPUT save:INPUT read:READ} [current_design]
set_property PACKAGE_PIN M2 [get_ports {ram_dq[6]}]
set_property src_info {type:XDC file:1 line:99 export:INPUT save:INPUT read:READ} [current_design]
set_property PACKAGE_PIN P4 [get_ports {ram_dq[7]}]
set_property src_info {type:XDC file:1 line:100 export:INPUT save:INPUT read:READ} [current_design]
set_property PACKAGE_PIN T2 [get_ports ram_rstn]
set_property src_info {type:XDC file:1 line:101 export:INPUT save:INPUT read:READ} [current_design]
set_property PACKAGE_PIN N3 [get_ports ram_rwds]
set_property src_info {type:XDC file:1 line:102 export:INPUT save:INPUT read:READ} [current_design]
set_property PACKAGE_PIN B15 [get_ports ref_ac]
set_property src_info {type:XDC file:1 line:103 export:INPUT save:INPUT read:READ} [current_design]
set_property PACKAGE_PIN B16 [get_ports ref_dc]
set_property src_info {type:XDC file:1 line:104 export:INPUT save:INPUT read:READ} [current_design]
set_property PACKAGE_PIN B14 [get_ports ref_term_en]
set_property src_info {type:XDC file:1 line:105 export:INPUT save:INPUT read:READ} [current_design]
set_property PACKAGE_PIN D13 [get_ports sys_clock_in]
