daveshah1/RFToolSDR/fpga/projects/rx_tx_gen/rx_tx_gen.runs/command_fifo_synth_1/.Xil/command_fifo_propImpl.xdc

set_property SRC_FILE_INFO {cfile:/home/dave/misc-projects/rftool-fpga/projects/rx_only/rx_only.srcs/sources_1/ip/command_fifo/command_fifo/command_fifo_clocks.xdc rfile:../../../rx_only.srcs/sources_1/ip/command_fifo/command_fifo/command_fifo_clocks.xdc id:1 order:LATE scoped_inst:U0} [current_design]
set_property src_info {type:SCOPED_XDC file:1 line:62 export:INPUT save:INPUT read:READ} [current_design]
set_max_delay -from [get_cells inst_fifo_gen/gconvfifo.rf/grf.rf/gntv_or_sync_fifo.gcx.clkx/*rd_pntr_gc_reg[*]] -to [get_cells inst_fifo_gen/gconvfifo.rf/grf.rf/gntv_or_sync_fifo.gcx.clkx/*gsync_stage[1].wr_stg_inst/Q_reg_reg[*]] -datapath_only [get_property -min PERIOD [get_clocks -of_objects [get_ports rd_clk]]]
set_property src_info {type:SCOPED_XDC file:1 line:65 export:INPUT save:INPUT read:READ} [current_design]
set_max_delay -from [get_cells inst_fifo_gen/gconvfifo.rf/grf.rf/gntv_or_sync_fifo.gcx.clkx/*wr_pntr_gc_reg[*]] -to [get_cells inst_fifo_gen/gconvfifo.rf/grf.rf/gntv_or_sync_fifo.gcx.clkx/*gsync_stage[1].rd_stg_inst/Q_reg_reg[*]] -datapath_only [get_property -min PERIOD [get_clocks -of_objects [get_ports wr_clk]]]
current_instance U0
set_property src_info {type:SCOPED_XDC file:1 line:63 export:INPUT save:INPUT read:READ} [current_design]
set_bus_skew -from [get_cells {inst_fifo_gen/gconvfifo.rf/grf.rf/gntv_or_sync_fifo.gcx.clkx/*rd_pntr_gc_reg[*]}] -to [get_cells {inst_fifo_gen/gconvfifo.rf/grf.rf/gntv_or_sync_fifo.gcx.clkx/*gsync_stage[1].wr_stg_inst/Q_reg_reg[*]}] 10.000
set_property src_info {type:SCOPED_XDC file:1 line:66 export:INPUT save:INPUT read:READ} [current_design]
set_bus_skew -from [get_cells {inst_fifo_gen/gconvfifo.rf/grf.rf/gntv_or_sync_fifo.gcx.clkx/*wr_pntr_gc_reg[*]}] -to [get_cells {inst_fifo_gen/gconvfifo.rf/grf.rf/gntv_or_sync_fifo.gcx.clkx/*gsync_stage[1].rd_stg_inst/Q_reg_reg[*]}] 10.000
