daveshah1/RFToolSDR/linux-app/spectrum-analyser/ad9361/ad9361.c

/***************************************************************************//**
 *   @file   ad9361.c
 *   @brief  Implementation of AD9361 Driver.
********************************************************************************
 * Copyright 2014-2015(c) Analog Devices, Inc.
 *
 * All rights reserved.
 *
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
 * THIS SOFTWARE IS PROVIDED BY ANALOG DEVICES "AS IS" AND ANY EXPRESS OR
 * IMPLIED WARRANTIES, INCLUDING, BUT NOT LIMITED TO, NON-INFRINGEMENT,
 * MERCHANTABILITY AND FITNESS FOR A PARTICULAR PURPOSE ARE DISCLAIMED.
 * IN NO EVENT SHALL ANALOG DEVICES BE LIABLE FOR ANY DIRECT, INDIRECT,
 * INCIDENTAL, SPECIAL, EXEMPLARY, OR CONSEQUENTIAL DAMAGES (INCLUDING, BUT NOT
 * LIMITED TO, INTELLECTUAL PROPERTY RIGHTS, PROCUREMENT OF SUBSTITUTE GOODS OR
 * SERVICES; LOSS OF USE, DATA, OR PROFITS; OR BUSINESS INTERRUPTION) HOWEVER
 * CAUSED AND ON ANY THEORY OF LIABILITY, WHETHER IN CONTRACT, STRICT LIABILITY,
 * OR TORT (INCLUDING NEGLIGENCE OR OTHERWISE) ARISING IN ANY WAY OUT OF THE USE
 * OF THIS SOFTWARE, EVEN IF ADVISED OF THE POSSIBILITY OF SUCH DAMAGE.
*******************************************************************************/

/******************************************************************************/
/***************************** Include Files **********************************/
/******************************************************************************/
#include <malloc.h>
#include <limits.h>
#include <stdint.h>
#include <stdio.h>
#include <stdlib.h>
#include <string.h>
#include <inttypes.h>
#include "ad9361.h"
#include "platform.h"
#include "util.h"
#include "config.h"

/* Used for static code size optimization: please see config.h */
const bool has_split_gt = HAVE_SPLIT_GAIN_TABLE;
const bool have_tdd_tables = HAVE_TDD_SYNTH_TABLE;

#define SYNTH_LUT_SIZE	53

static const struct SynthLUT SynthLUT_FDD[LUT_FTDD_ENT][SYNTH_LUT_SIZE] = {
	{
		{ 12605, 10, 0, 4, 0, 15, 8, 8, 12, 3, 14, 15, 11 }, /* 40 MHz */
		{ 12245, 10, 0, 4, 0, 15, 8, 9, 12, 3, 14, 15, 11 },
		{ 11906, 10, 0, 4, 0, 15, 8, 9, 12, 3, 14, 15, 11 },
		{ 11588, 10, 0, 4, 0, 15, 8, 10, 12, 3, 14, 15, 11 },
		{ 11288, 10, 0, 4, 0, 15, 8, 11, 12, 3, 14, 15, 11 },
		{ 11007, 10, 0, 4, 0, 15, 8, 11, 12, 3, 14, 15, 11 },
		{ 10742, 10, 0, 4, 0, 14, 8, 12, 12, 3, 14, 15, 11 },
		{ 10492, 10, 0, 5, 1, 14, 9, 13, 12, 3, 14, 15, 11 },
		{ 10258, 10, 0, 5, 1, 14, 9, 13, 12, 3, 14, 15, 11 },
		{ 10036, 10, 0, 5, 1, 14, 9, 14, 12, 3, 14, 15, 11 },
		{ 9827, 10, 0, 5, 1, 14, 9, 15, 12, 3, 14, 15, 11 },
		{ 9631, 10, 0, 5, 1, 14, 9, 15, 12, 3, 14, 15, 11 },
		{ 9445, 10, 0, 5, 1, 14, 9, 16, 12, 3, 14, 15, 11 },
		{ 9269, 10, 0, 5, 1, 14, 9, 17, 12, 3, 14, 15, 11 },
		{ 9103, 10, 0, 5, 1, 14, 9, 17, 12, 3, 14, 15, 11 },
		{ 8946, 10, 0, 5, 1, 14, 9, 18, 12, 3, 14, 15, 11 },
		{ 8797, 10, 1, 6, 1, 15, 11, 13, 12, 3, 14, 15, 11 },
		{ 8655, 10, 1, 6, 1, 15, 11, 14, 12, 3, 14, 15, 11 },
		{ 8520, 10, 1, 6, 1, 15, 11, 14, 12, 3, 14, 15, 11 },
		{ 8392, 10, 1, 6, 1, 15, 11, 15, 12, 3, 14, 15, 11 },
		{ 8269, 10, 1, 6, 1, 15, 11, 15, 12, 3, 14, 15, 11 },
		{ 8153, 10, 1, 6, 1, 15, 11, 16, 12, 3, 14, 15, 11 },
		{ 8041, 10, 1, 6, 1, 15, 11, 16, 12, 3, 14, 15, 11 },
		{ 7934, 10, 1, 6, 1, 15, 11, 17, 12, 3, 14, 15, 11 },
		{ 7831, 10, 1, 6, 1, 15, 11, 17, 12, 3, 14, 15, 11 },
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
	{ 0x65, 0x38, 0x20 }, { 0x66, 0x38, 0x20 }, { 0x67, 0x38, 0x20 },
	{ 0x68, 0x38, 0x20 }, { 0x69, 0x38, 0x20 }, { 0x6A, 0x38, 0x20 },
	{ 0x6B, 0x38, 0x20 }, { 0x6C, 0x38, 0x20 }, { 0x6D, 0x38, 0x20 },
	{ 0x6E, 0x38, 0x20 }, { 0x6F, 0x38, 0x20 },
} };

/* Mixer GM Sub-table */

static const uint8_t gm_st_gain[16] = { 0x78, 0x74, 0x70, 0x6C, 0x68, 0x64, 0x60,
0x5C, 0x58, 0x54, 0x50, 0x4C, 0x48, 0x30, 0x18, 0x0 };
static const uint8_t gm_st_ctrl[16] = { 0x0, 0xD, 0x15, 0x1B, 0x21, 0x25, 0x29,
0x2C, 0x2F, 0x31, 0x33, 0x34, 0x35, 0x3A, 0x3D, 0x3E };

static const int8_t lna_table[RXGAIN_TBLS_END][4] = {
	{5, 17, 19, 24}, {3, 14, 17, 21}, {-4, 10, 13, 14}};
static const int8_t tia_table[] = { -6, 0 };
static const int8_t mixer_table[RXGAIN_TBLS_END][16] = {
	{0, 3, 9, 13, 14, 15, 16, 17, 18, 19, 20, 21, 22, 23, 24, 25},
	{0, 3, 9, 14, 15, 16, 17, 18, 19, 20, 21, 22, 23, 24, 25, 26},
	{0, 3, 8, 12, 13, 14, 15, 16, 17, 18, 19, 20, 21, 22, 23, 24}};

/******************************************************************************/
/********************** Macros and Constants Definitions **********************/
/******************************************************************************/
const char *ad9361_ensm_states[] = {
	"sleep", "", "", "", "", "alert", "tx", "tx flush",
	"rx", "rx_flush", "fdd", "fdd_flush"
};

/**
 * SPI multiple bytes register read.
 * @param spi
 * @param reg The register address.
 * @param rbuf The data buffer.
 * @param num The number of bytes to read.
 * @return 0 in case of success, negative error code otherwise.
 */
int32_t ad9361_spi_readm(struct spi_device *spi, uint32_t reg,
	uint8_t *rbuf, uint32_t num)
{
	uint8_t buf[2];
	int32_t ret;
	uint16_t cmd;

	if (num > MAX_MBYTE_SPI)
		return -EINVAL;

	cmd = AD_READ | AD_CNT(num) | AD_ADDR(reg);
	buf[0] = cmd >> 8;
	buf[1] = cmd & 0xFF;

	ret = spi_write_then_read(spi, &buf[0], 2, rbuf, num);
	if (ret < 0) {
		dev_err(&spi->dev, "Read Error %"PRId32, ret);
		return ret;
	}
#ifdef _DEBUG
	{
		int32_t i;
		for (i = 0; i < num; i++)
			dev_dbg(&spi->dev, "%s: reg 0x%"PRIX32" val 0x%X",
			__func__, reg--, rbuf[i]);
	}
#endif

	return 0;
}

/**
 * SPI register read.
 * @param spi
 * @param reg The register address.
 * @return The register value or negative error code in case of failure.
 */
int32_t ad9361_spi_read(struct spi_device *spi, uint32_t reg)
{
	uint8_t buf;
	int32_t ret;

	ret = ad9361_spi_readm(spi, reg, &buf, 1);
	if (ret < 0)
		return ret;

	return buf;
}

/**
 * SPI register bits read.
 * @param spi
 * @param reg The register address.
 * @param mask The bits mask.
 * @param offset The mask offset.
 * @return The bits value or negative error code in case of failure.
 */
static int32_t __ad9361_spi_readf(struct spi_device *spi, uint32_t reg,
	uint32_t mask, uint32_t offset)
{
	uint8_t buf;
	int32_t ret;

	if (!mask)
		return -EINVAL;

	ret = ad9361_spi_readm(spi, reg, &buf, 1);
	if (ret < 0)
		return ret;

	buf &= mask;
	buf >>= offset;

	return buf;
}

/**
 * SPI register bits read.
 * @param spi
 * @param reg The register address.
 * @param mask The bits mask.
 * @return The bits value or negative error code in case of failure.
 */
#define ad9361_spi_readf(spi, reg, mask) \
	__ad9361_spi_readf(spi, reg, mask, __the_real_ffs(mask))

/**
 * SPI register write.
 * @param spi
 * @param reg The register address.
 * @param val The value of the register.
 * @return 0 in case of success, negative error code otherwise.
 */
int32_t ad9361_spi_write(struct spi_device *spi,
	uint32_t reg, uint32_t val)
{
	uint8_t buf[3];
	int32_t ret;
	uint16_t cmd;

	cmd = AD_WRITE | AD_CNT(1) | AD_ADDR(reg);
	buf[0] = cmd >> 8;
	buf[1] = cmd & 0xFF;
	buf[2] = val;

	ret = spi_write_then_read(spi, buf, 3, NULL, 0);
	if (ret < 0) {
		dev_err(&spi->dev, "Write Error %"PRId32, ret);
		return ret;
	}

#ifdef _DEBUG
	dev_dbg(&spi->dev, "%s: reg 0x%"PRIX32" val 0x%X", __func__, reg, buf[2]);
#endif

	return 0;
}

/**
 * SPI register bits write.
 * @param spi
 * @param reg The register address.
 * @param mask The bits mask.
 * @param offset The mask offset.
 * @param val The bits value.
 * @return 0 in case of success, negative error code otherwise.
 */
static int32_t __ad9361_spi_writef(struct spi_device *spi, uint32_t reg,
	uint32_t mask, uint32_t offset, uint32_t val)
{
	//printf("writef %04x %02x %02x %02x\n", reg, mask, offset, val);
	uint8_t buf;
	int32_t ret;

	if (!mask)
		return -EINVAL;

	ret = ad9361_spi_readm(spi, reg, &buf, 1);
	if (ret < 0)
		return ret;
	//printf("orig %02x\n", buf);

	buf &= ~mask;
	buf |= ((val << offset) & mask);

	return ad9361_spi_write(spi, reg, buf);
}

/**
 * SPI register bits write.
 * @param spi
 * @param reg The register address.
 * @param mask The bits mask.
 * @param val The bits value.
 * @return 0 in case of success, negative error code otherwise.
 */
#define ad9361_spi_writef(spi, reg, mask, val) \
	__ad9361_spi_writef(spi, reg, mask, __the_real_ffs(mask), val)

/**
 * SPI multiple bytes register write.
 * @param spi
 * @param reg The register address.
 * @param tbuf The data buffer.
 * @param num The number of bytes to read.
 * @return 0 in case of success, negative error code otherwise.
 */
static int32_t ad9361_spi_writem(struct spi_device *spi,
	uint32_t reg, uint8_t *tbuf, uint32_t num)
{
	uint8_t buf[10];
	int32_t ret;
	uint16_t cmd;

	if (num > MAX_MBYTE_SPI)
		return -EINVAL;

	cmd = AD_WRITE | AD_CNT(num) | AD_ADDR(reg);
	buf[0] = cmd >> 8;
	buf[1] = cmd & 0xFF;

	memcpy(&buf[2], tbuf, num);

	ret = spi_write_then_read(spi, buf, num + 2, NULL, 0);
	if (ret < 0) {
		dev_err(&spi->dev, "Write Error %"PRId32, ret);
		return ret;
	}

#ifdef _DEBUG
	{
		int32_t i;
		for (i = 0; i < num; i++)
			dev_dbg(&spi->dev, "Reg 0x%"PRIX32" val 0x%X", reg--, tbuf[i]);
	}
#endif

	return 0;
}

/**
 * Find optimal value.
 * @param field
 * @param ret_start
 * @return The optimal delay in case of success, negative error code otherwise.
 */
int32_t ad9361_find_opt(uint8_t *field, uint32_t size, uint32_t *ret_start)
{
	int32_t i, cnt = 0, max_cnt = 0, start, max_start = 0;

	for(i = 0, start = -1; i < (int64_t)size; i++) {
		if (field[i] == 0) {
			if (start == -1)
				start = i;
			cnt++;
		} else {
			if (cnt > max_cnt) {
				max_cnt = cnt;
				max_start = start;
			}
			start = -1;
			cnt = 0;
		}
	}

	if (cnt > max_cnt) {
		max_cnt = cnt;
		max_start = start;
	}

	*ret_start = max_start;

	return max_cnt;
}

/**
 * AD9361 Device Reset
 * @param phy The AD9361 state structure.
 * @return 0 in case of success, negative error code otherwise.
 */
int32_t ad9361_reset(struct ad9361_rf_phy *phy)
{
	if (gpio_is_valid(phy->pdata->gpio_resetb)) {
		gpio_set_value(phy->pdata->gpio_resetb, 0);
		mdelay(1);
		gpio_set_value(phy->pdata->gpio_resetb, 1);
		mdelay(1);
		dev_dbg(&phy->spi->dev, "%s: by GPIO", __func__);
		return 0;
	}

	/* SPI Soft Reset was removed from the register map, since it doesn't
	 * work reliably. Without a prober HW reset randomness may happen.
	 * Please specify a RESET GPIO.
	 */

	ad9361_spi_write(phy->spi, REG_SPI_CONF, SOFT_RESET | _SOFT_RESET);
	ad9361_spi_write(phy->spi, REG_SPI_CONF, 0x0);
	dev_err(&phy->spi->dev,
		 "%s: by SPI, this may cause unpredicted behavior!", __func__);

	return -ENODEV;
}

/**
 * BIST loopback mode.
 * @param phy The AD9361 state structure.
 * @param mode BIST loopback mode.
 * @return 0 in case of success, negative error code otherwise.
 */
int32_t ad9361_bist_loopback(struct ad9361_rf_phy *phy, int32_t mode)
{
	uint32_t sp_hd, reg;

	dev_dbg(&phy->spi->dev, "%s: mode %"PRId32, __func__, mode);

	reg = ad9361_spi_read(phy->spi, REG_OBSERVE_CONFIG);

	phy->bist_loopback_mode = mode;

	switch (mode) {
	case 0:
		ad9361_hdl_loopback(phy, false);
		reg &= ~(DATA_PORT_SP_HD_LOOP_TEST_OE |
			DATA_PORT_LOOP_TEST_ENABLE);
		return ad9361_spi_write(phy->spi, REG_OBSERVE_CONFIG, reg);
	case 1:
		/* loopback (AD9361 internal) TX->RX */
		ad9361_hdl_loopback(phy, false);
		sp_hd = ad9361_spi_read(phy->spi, REG_PARALLEL_PORT_CONF_3);
		if ((sp_hd & SINGLE_PORT_MODE) && (sp_hd & HALF_DUPLEX_MODE))
			reg |= DATA_PORT_SP_HD_LOOP_TEST_OE;
		else
			reg &= ~DATA_PORT_SP_HD_LOOP_TEST_OE;

		reg |= DATA_PORT_LOOP_TEST_ENABLE;

		return ad9361_spi_write(phy->spi, REG_OBSERVE_CONFIG, reg);
	case 2:
		/* loopback (FPGA internal) RX->TX */
		ad9361_hdl_loopback(phy, true);
		reg &= ~(DATA_PORT_SP_HD_LOOP_TEST_OE |
			DATA_PORT_LOOP_TEST_ENABLE);
		return ad9361_spi_write(phy->spi, REG_OBSERVE_CONFIG, reg);
	default:
		return -EINVAL;
	}
}

/**
 * Get BIST loopback mode.
 * @param phy The AD9361 state structure.
 * @param mode BIST loopback mode.
 * @return 0 in case of success, negative error code otherwise.
 */
void ad9361_get_bist_loopback(struct ad9361_rf_phy *phy, int32_t *mode)
{
	*mode = phy->bist_loopback_mode;
}

/**
 * BIST mode.
 * @param phy The AD9361 state structure.
 * @param mode Bist mode.
 * @return 0 in case of success, negative error code otherwise.
 */
int32_t ad9361_bist_prbs(struct ad9361_rf_phy *phy, enum ad9361_bist_mode mode)
{
	uint32_t reg = 0;

	dev_dbg(&phy->spi->dev, "%s: mode %d", __func__, mode);

	phy->bist_prbs_mode = mode;

	switch (mode) {
	case BIST_DISABLE:
		reg = 0;
		break;
	case BIST_INJ_TX:
		reg = BIST_CTRL_POINT(0) | BIST_ENABLE;
		break;
	case BIST_INJ_RX:
		reg = BIST_CTRL_POINT(2) | BIST_ENABLE;
		break;
	};

	return ad9361_spi_write(phy->spi, REG_BIST_CONFIG, reg);
}

/**
 * Get BIST mode settings.
 * @param phy The AD9361 state structure.
 * @param mode Bist mode.
 * @return 0 in case of success, negative error code otherwise.
 */
void ad9361_get_bist_prbs(struct ad9361_rf_phy *phy, enum ad9361_bist_mode *mode)
{
	*mode = phy->bist_prbs_mode;
}

/**
 * BIST tone.
 * @param phy The AD9361 state structure.
 * @param mode Bist tone mode.
 * @param freq_Hz Bist tone frequency.
 * @param level_dB Bist tone level.
 * @param mask Bist reg mask.
 * @return 0 in case of success, negative error code otherwise.
 */
int32_t ad9361_bist_tone(struct ad9361_rf_phy *phy,
						 enum ad9361_bist_mode mode, uint32_t freq_Hz,
						 uint32_t level_dB, uint32_t mask)
{
	uint32_t clk = 0;
	uint32_t reg = 0, reg1, reg_mask;

	dev_dbg(&phy->spi->dev, "%s: mode %d", __func__, mode);

	phy->bist_tone_mode = mode;
	phy->bist_tone_freq_Hz = freq_Hz;
	phy->bist_tone_level_dB = level_dB;
	phy->bist_tone_mask = mask;

	switch (mode) {
	case BIST_DISABLE:
		reg = 0;
		break;
	case BIST_INJ_TX:
		clk = clk_get_rate(phy, phy->ref_clk_scale[TX_SAMPL_CLK]);
		reg = BIST_CTRL_POINT(0) | BIST_ENABLE;
		break;
	case BIST_INJ_RX:
		clk = clk_get_rate(phy, phy->ref_clk_scale[RX_SAMPL_CLK]);
		reg = BIST_CTRL_POINT(2) | BIST_ENABLE;
		break;
	};

	reg |= TONE_PRBS;
	reg |= TONE_LEVEL(level_dB / 6);

	if (freq_Hz < 4) {
		reg |= TONE_FREQ(freq_Hz);
	}
	else {
		if (clk)
			reg |= TONE_FREQ(DIV_ROUND_CLOSEST(freq_Hz * 32, clk) - 1);
	}

	reg_mask = BIST_MASK_CHANNEL_1_I_DATA | BIST_MASK_CHANNEL_1_Q_DATA |
		BIST_MASK_CHANNEL_2_I_DATA | BIST_MASK_CHANNEL_2_Q_DATA;

	reg1 = ((mask << 2) & reg_mask);
	ad9361_spi_write(phy->spi, REG_BIST_AND_DATA_PORT_TEST_CONFIG, reg1);

	return ad9361_spi_write(phy->spi, REG_BIST_CONFIG, reg);
}

/**
 * Get BIST tone settings.
 * @param phy The AD9361 state structure.
 * @param mode Bist tone mode.
 * @param freq_Hz Bist tone frequency.
 * @param level_dB Bist tone level.
 * @param mask Bist reg mask.
 * @return 0 in case of success, negative error code otherwise.
 */
void ad9361_get_bist_tone(struct ad9361_rf_phy *phy,
						 enum ad9361_bist_mode *mode, uint32_t *freq_Hz,
						 uint32_t *level_dB, uint32_t *mask)
{
	*mode = phy->bist_tone_mode;
	*freq_Hz = phy->bist_tone_freq_Hz;
	*level_dB = phy->bist_tone_level_dB;
	*mask = phy->bist_tone_mask;
}

/**
 * Check the calibration done bit.
 * @param phy The AD9361 state structure.
 * @param reg The register address.
 * @param mask The bit mask.
 * @param done_state The done state [0,1].
 * @return 0 in case of success, negative error code otherwise.
 */
static int32_t ad9361_check_cal_done(struct ad9361_rf_phy *phy, uint32_t reg,
	uint32_t mask, bool done_state)
{
	uint32_t timeout = 5000; /* RFDC_CAL can take long */
	uint32_t state;

	do {
		state = ad9361_spi_readf(phy->spi, reg, mask);
		if (state == done_state)
			return 0;

		if (reg == REG_CALIBRATION_CTRL)
			udelay(1200);
		else
			udelay(120);
	} while (timeout--);

	dev_err(&phy->spi->dev, "Calibration TIMEOUT (0x%"PRIX32", 0x%"PRIX32")", reg, mask);

	return -ETIMEDOUT;
}

/**
 * Run an AD9361 calibration and check the calibration done bit.
 * @param phy The AD9361 state structure.
 * @param mask The calibration bit mask[RX_BB_TUNE_CAL, TX_BB_TUNE_CAL,
 *             RX_QUAD_CAL, TX_QUAD_CAL, RX_GAIN_STEP_CAL, TXMON_CAL,
 *             RFDC_CAL, BBDC_CAL].
 * @return 0 in case of success, negative error code otherwise.
 */
static int32_t ad9361_run_calibration(struct ad9361_rf_phy *phy, uint32_t mask)
{
	int32_t ret = ad9361_spi_write(phy->spi, REG_CALIBRATION_CTRL, mask);
	if (ret < 0)
		return ret;

	dev_dbg(&phy->spi->dev, "%s: CAL Mask 0x%"PRIx32, __func__, mask);

	return ad9361_check_cal_done(phy, REG_CALIBRATION_CTRL, mask, 0);
}

/**
 * Choose the right RX gain table index for the selected frequency.
 * @param freq The frequency value [Hz].
 * @return The index to the RX gain table.
 */
static enum rx_gain_table_name ad9361_gt_tableindex(uint64_t freq)
{
	if (freq <= 1300000000ULL)
		return TBL_200_1300_MHZ;

	if (freq <= 4000000000ULL)
		return TBL_1300_4000_MHZ;

	return TBL_4000_6000_MHZ;
}

/**
 * Shift the real frequency value, so it fits type unsigned long
 * Note: PLL operates between 47 .. 6000 MHz which is > 2^32.
 * @param freq The frequency value [Hz].
 * @return The shifted frequency value.
 */
uint32_t ad9361_to_clk(uint64_t freq)
{
	return (uint32_t)(freq >> 1);
}

/**
 * Shift back the frequency value, so it reflects the real value.
 * Note: PLL operates between 47 .. 6000 MHz which is > 2^32.
 * @param freq The frequency value [Hz].
 * @return The shifted frequency value.
 */
uint64_t ad9361_from_clk(uint32_t freq)
{
	return ((uint64_t)freq << 1);
}

/**
 * Load the gain table for the selected frequency range and receiver.
 * @param phy The AD9361 state structure.
 * @param freq The frequency value [Hz].
 * @param dest The destination [GT_RX1, GT_RX2].
 * @return 0 in case of success, negative error code otherwise.
 */
static int32_t ad9361_load_gt(struct ad9361_rf_phy *phy, uint64_t freq, uint32_t dest)
{
	struct spi_device *spi = phy->spi;
	const uint8_t(*tab)[3];
	enum rx_gain_table_name band;
	uint32_t index_max, i, lna;

	dev_dbg(&phy->spi->dev, "%s: frequency %"PRIu64, __func__, freq);

	band = ad9361_gt_tableindex(freq);

	dev_dbg(&phy->spi->dev, "%s: frequency %"PRIu64" (band %d)",
		__func__, freq, band);

	/* check if table is present */
	if (phy->current_table == band)
		return 0;

	ad9361_spi_writef(spi, REG_AGC_CONFIG_2,
		AGC_USE_FULL_GAIN_TABLE, !phy->pdata->split_gt);

	if (has_split_gt && phy->pdata->split_gt) {
		tab = &split_gain_table[band][0];
		index_max = SIZE_SPLIT_TABLE;
	}
	else {
		tab = &full_gain_table[band][0];
		index_max = SIZE_FULL_TABLE;
	}

	lna = phy->pdata->elna_ctrl.elna_in_gaintable_all_index_en ?
			EXT_LNA_CTRL : 0;

	ad9361_spi_write(spi, REG_GAIN_TABLE_CONFIG, START_GAIN_TABLE_CLOCK |
		RECEIVER_SELECT(dest)); /* Start Gain Table Clock */

	for (i = 0; i < index_max; i++) {
		ad9361_spi_write(spi, REG_GAIN_TABLE_ADDRESS, i); /* Gain Table Index */
		ad9361_spi_write(spi, REG_GAIN_TABLE_WRITE_DATA1, tab[i][0] | lna); /* Ext LNA, Int LNA, & Mixer Gain Word */
		ad9361_spi_write(spi, REG_GAIN_TABLE_WRITE_DATA2, tab[i][1]); /* TIA & LPF Word */
		ad9361_spi_write(spi, REG_GAIN_TABLE_WRITE_DATA3, tab[i][2]); /* DC Cal bit & Dig Gain Word */
		ad9361_spi_write(spi, REG_GAIN_TABLE_CONFIG,
			START_GAIN_TABLE_CLOCK |
			WRITE_GAIN_TABLE |
			RECEIVER_SELECT(dest)); /* Gain Table Index */
		ad9361_spi_write(spi, REG_GAIN_TABLE_READ_DATA1, 0); /* Dummy Write to delay 3 ADCCLK/16 cycles */
		ad9361_spi_write(spi, REG_GAIN_TABLE_READ_DATA1, 0); /* Dummy Write to delay ~1u */
	}

	ad9361_spi_write(spi, REG_GAIN_TABLE_CONFIG, START_GAIN_TABLE_CLOCK |
		RECEIVER_SELECT(dest)); /* Clear Write Bit */
	ad9361_spi_write(spi, REG_GAIN_TABLE_READ_DATA1, 0); /* Dummy Write to delay ~1u */
	ad9361_spi_write(spi, REG_GAIN_TABLE_READ_DATA1, 0); /* Dummy Write to delay ~1u */
	ad9361_spi_write(spi, REG_GAIN_TABLE_CONFIG, 0); /* Stop Gain Table Clock */

	phy->current_table = band;

	return 0;
}

/**
 * Setup the external low-noise amplifier (LNA).
 * @param phy The AD9361 state structure.
 * @param ctrl Pointer to eLNA control structure.
 * @return 0 in case of success, negative error code otherwise.
 */
static int32_t ad9361_setup_ext_lna(struct ad9361_rf_phy *phy,
struct elna_control *ctrl)
{
	ad9361_spi_writef(phy->spi, REG_EXTERNAL_LNA_CTRL, EXTERNAL_LNA1_CTRL,
		ctrl->elna_1_control_en);

	ad9361_spi_writef(phy->spi, REG_EXTERNAL_LNA_CTRL, EXTERNAL_LNA2_CTRL,
		ctrl->elna_2_control_en);

	ad9361_spi_write(phy->spi, REG_EXT_LNA_HIGH_GAIN,
		EXT_LNA_HIGH_GAIN(ctrl->gain_mdB / 500));

	return ad9361_spi_write(phy->spi, REG_EXT_LNA_LOW_GAIN,
		EXT_LNA_LOW_GAIN(ctrl->bypass_loss_mdB / 500));
}

/**
 * Set the clock output mode.
 * @param phy The AD9361 state structure.
 * @param mode The clock output mode [].
 * @return 0 in case of success, negative error code otherwise.
 */
static int32_t ad9361_clkout_control(struct ad9361_rf_phy *phy,
enum ad9361_clkout mode)
{
	if (mode == CLKOUT_DISABLE)
		return ad9361_spi_writef(phy->spi, REG_BBPLL, CLKOUT_ENABLE, 0);

	return ad9361_spi_writef(phy->spi, REG_BBPLL,
		CLKOUT_ENABLE | CLKOUT_SELECT(~0),
		((mode - 1) << 1) | 0x1);
}

/**
 * Load the Gm Sub Table.
 * @param phy The AD9361 state structure.
 * @return 0 in case of success, negative error code otherwise.
 */
static int32_t ad9361_load_mixer_gm_subtable(struct ad9361_rf_phy *phy)
{
	int32_t i, addr;
	dev_dbg(&phy->spi->dev, "%s", __func__);

	ad9361_spi_write(phy->spi, REG_GM_SUB_TABLE_CONFIG,
		START_GM_SUB_TABLE_CLOCK); /* Start Clock */

	for (i = 0, addr = ARRAY_SIZE(gm_st_ctrl); i < (int64_t)ARRAY_SIZE(gm_st_ctrl); i++) {
		ad9361_spi_write(phy->spi, REG_GM_SUB_TABLE_ADDRESS, --addr); /* Gain Table Index */
		ad9361_spi_write(phy->spi, REG_GM_SUB_TABLE_BIAS_WRITE, 0); /* Bias */
		ad9361_spi_write(phy->spi, REG_GM_SUB_TABLE_GAIN_WRITE, gm_st_gain[i]); /* Gain */
		ad9361_spi_write(phy->spi, REG_GM_SUB_TABLE_CTRL_WRITE, gm_st_ctrl[i]); /* Control */
		ad9361_spi_write(phy->spi, REG_GM_SUB_TABLE_CONFIG,
			WRITE_GM_SUB_TABLE | START_GM_SUB_TABLE_CLOCK); /* Write Words */
		ad9361_spi_write(phy->spi, REG_GM_SUB_TABLE_GAIN_READ, 0); /* Dummy Delay */
		ad9361_spi_write(phy->spi, REG_GM_SUB_TABLE_GAIN_READ, 0); /* Dummy Delay */
	}

	ad9361_spi_write(phy->spi, REG_GM_SUB_TABLE_CONFIG, START_GM_SUB_TABLE_CLOCK); /* Clear Write */
	ad9361_spi_write(phy->spi, REG_GM_SUB_TABLE_GAIN_READ, 0); /* Dummy Delay */
	ad9361_spi_write(phy->spi, REG_GM_SUB_TABLE_GAIN_READ, 0); /* Dummy Delay */
	ad9361_spi_write(phy->spi, REG_GM_SUB_TABLE_CONFIG, 0); /* Stop Clock */

	return 0;
}

/**
 * Set the attenuation for the selected TX channels.
 * @param phy The AD9361 state structure.
 * @param atten_mdb Attenuation value [mdB].
 * @param tx1 Set true, the attenuation of the TX1 will be affected.
 * @param tx2 Set true, the attenuation of the TX2 will be affected.
 * @param immed Set true, an immediate update will take place.
 * @return 0 in case of success, negative error code otherwise.
 */
int32_t ad9361_set_tx_atten(struct ad9361_rf_phy *phy, uint32_t atten_mdb,
	bool tx1, bool tx2, bool immed)
{
	uint8_t buf[2];
	int32_t ret = 0;

	dev_dbg(&phy->spi->dev, "%s : attenuation %"PRIu32" mdB tx1=%d tx2=%d",
		__func__, atten_mdb, tx1, tx2);

	if (atten_mdb > 89750) /* 89.75 dB */
		return -EINVAL;

	atten_mdb /= 250; /* Scale to 0.25dB / LSB */

	buf[0] = atten_mdb >> 8;
	buf[1] = atten_mdb & 0xFF;

	ad9361_spi_writef(phy->spi, REG_TX2_DIG_ATTEN,
		IMMEDIATELY_UPDATE_TPC_ATTEN, 0);

	if (tx1)
		ret = ad9361_spi_writem(phy->spi, REG_TX1_ATTEN_1, buf, 2);

	if (tx2)
		ret = ad9361_spi_writem(phy->spi, REG_TX2_ATTEN_1, buf, 2);

	if (immed)
		ad9361_spi_writef(phy->spi, REG_TX2_DIG_ATTEN,
		IMMEDIATELY_UPDATE_TPC_ATTEN, 1);

	return ret;
}

/**
 * Get the attenuation for the selected TX channel.
 * @param phy The AD9361 state structure.
 * @param tx_num The selected channel [1, 2].
 * @return The attenuation value [mdB] or negative error code in case of failure.
 */
int32_t ad9361_get_tx_atten(struct ad9361_rf_phy *phy, uint32_t tx_num)
{
	uint8_t buf[2];
	int32_t ret = 0;
	uint32_t code;

	ret = ad9361_spi_readm(phy->spi, (tx_num == 1) ?
	REG_TX1_ATTEN_1 : REG_TX2_ATTEN_1, buf, 2);

	if (ret < 0)
		return ret;

	code = (buf[0] << 8) | buf[1];

	code *= 250;

	return code;
}

/**
 * Choose the right RF VCO table index for the selected frequency.
 * @param freq The frequency value [Hz].
 * @return The index from the RF VCO table.
 */
static uint32_t ad9361_rfvco_tableindex(uint32_t freq)
{
	if (freq < 50000000UL)
		return LUT_FTDD_40;

	if (freq <= 70000000UL)
		return LUT_FTDD_60;

	return LUT_FTDD_80;
}

/**
 * Initialize the RFPLL VCO.
 * @param phy The AD9361 state structure.
 * @param tx Set true for TX_RFPLL.
 * @param vco_freq The VCO frequency [Hz].
 * @param ref_clk The reference clock frequency [Hz].
 * @return 0 in case of success
 */
static int32_t ad9361_rfpll_vco_init(struct ad9361_rf_phy *phy,
	bool tx, uint64_t vco_freq,
	uint32_t ref_clk)
{
	struct spi_device *spi = phy->spi;
	const struct SynthLUT(*tab);
	int32_t i = 0;
	uint32_t range, offs = 0;

	range = ad9361_rfvco_tableindex(ref_clk);

	dev_dbg(&phy->spi->dev, "%s : vco_freq %"PRIu64" : ref_clk %"PRIu32" : range %"PRIu32,
		__func__, vco_freq, ref_clk, range);

	do_div(&vco_freq, 1000000UL); /* vco_freq in MHz */

	if (phy->pdata->fdd || phy->pdata->tdd_use_fdd_tables) {
		tab = &SynthLUT_FDD[range][0];
	} else if (have_tdd_tables) {
		tab = &SynthLUT_TDD[range][0];
	}

	if (tx)
		offs = REG_TX_VCO_OUTPUT - REG_RX_VCO_OUTPUT;

	while (i < SYNTH_LUT_SIZE && tab[i].VCO_MHz > vco_freq)
		i++;

	dev_dbg(&phy->spi->dev, "%s : freq %d MHz : index %"PRId32,
		__func__, tab[i].VCO_MHz, i);

	ad9361_spi_write(spi, REG_RX_VCO_OUTPUT + offs,
		VCO_OUTPUT_LEVEL(tab[i].VCO_Output_Level) |
		PORB_VCO_LOGIC);
	ad9361_spi_writef(spi, REG_RX_ALC_VARACTOR + offs,
		VCO_VARACTOR(~0), tab[i].VCO_Varactor);
	ad9361_spi_write(spi, REG_RX_VCO_BIAS_1 + offs,
		VCO_BIAS_REF(tab[i].VCO_Bias_Ref) |
		VCO_BIAS_TCF(tab[i].VCO_Bias_Tcf));

	ad9361_spi_write(spi, REG_RX_FORCE_VCO_TUNE_1 + offs,
		VCO_CAL_OFFSET(tab[i].VCO_Cal_Offset));
	ad9361_spi_write(spi, REG_RX_VCO_VARACTOR_CTRL_1 + offs,
		VCO_VARACTOR_REFERENCE(
		tab[i].VCO_Varactor_Reference));

	ad9361_spi_write(spi, REG_RX_VCO_CAL_REF + offs, VCO_CAL_REF_TCF(0));

	ad9361_spi_write(spi, REG_RX_VCO_VARACTOR_CTRL_0 + offs,
		VCO_VARACTOR_OFFSET(0) |
		VCO_VARACTOR_REFERENCE_TCF(7));

	ad9361_spi_writef(spi, REG_RX_CP_CURRENT + offs, CHARGE_PUMP_CURRENT(~0),
		tab[i].Charge_Pump_Current);
	ad9361_spi_write(spi, REG_RX_LOOP_FILTER_1 + offs,
		LOOP_FILTER_C2(tab[i].LF_C2) |
		LOOP_FILTER_C1(tab[i].LF_C1));
	ad9361_spi_write(spi, REG_RX_LOOP_FILTER_2 + offs,
		LOOP_FILTER_R1(tab[i].LF_R1) |
		LOOP_FILTER_C3(tab[i].LF_C3));
	ad9361_spi_write(spi, REG_RX_LOOP_FILTER_3 + offs,
		LOOP_FILTER_R3(tab[i].LF_R3));

	return 0;
}

/**
 * Get the current gain in Split Gain Table Mode
 * @param phy The AD9361 state structure.
 * @param idx_reg Register base address for the selected receiver
 * @param rx_gain  A rf_rx_gain struct to store the RF gain.
 * @return 0 in case of success,
 */
static int32_t ad9361_get_split_table_gain(struct ad9361_rf_phy *phy, uint32_t idx_reg,
struct rf_rx_gain *rx_gain)
{
	struct spi_device *spi = phy->spi;
	uint32_t val, tbl_addr;
	int32_t rc = 0;

	rx_gain->fgt_lmt_index = ad9361_spi_readf(spi, idx_reg,
		FULL_TABLE_GAIN_INDEX(~0));
	tbl_addr = ad9361_spi_read(spi, REG_GAIN_TABLE_ADDRESS);

	ad9361_spi_write(spi, REG_GAIN_TABLE_ADDRESS, rx_gain->fgt_lmt_index);

	val = ad9361_spi_read(spi, REG_GAIN_TABLE_READ_DATA1);
	rx_gain->lna_index = TO_LNA_GAIN(val);
	rx_gain->mixer_index = TO_MIXER_GM_GAIN(val);

	rx_gain->tia_index = ad9361_spi_readf(spi, REG_GAIN_TABLE_READ_DATA2, TIA_GAIN);

	rx_gain->lmt_gain = lna_table[phy->current_table][rx_gain->lna_index] +
		mixer_table[phy->current_table][rx_gain->mixer_index] +
		tia_table[rx_gain->tia_index];

	ad9361_spi_write(spi, REG_GAIN_TABLE_ADDRESS, tbl_addr);

	/* Read LPF Index */
	rx_gain->lpf_gain = ad9361_spi_readf(spi, idx_reg + 1, LPF_GAIN_RX(~0));

	/* Read Digital Gain */
	rx_gain->digital_gain = ad9361_spi_readf(spi, idx_reg + 2,
		DIGITAL_GAIN_RX(~0));

	rx_gain->gain_db = rx_gain->lmt_gain + rx_gain->lpf_gain +
		rx_gain->digital_gain;
	return rc;
}

/**
 * Get the current gain in Full Gain Table Mode
 * @param phy The AD9361 state structure.
 * @param idx_reg Register base address for the selected receiver
 * @param rx_gain A rf_rx_gain struct to store the RF gain.
 * @return 0 in case of success
 */
static int32_t ad9361_get_full_table_gain(struct ad9361_rf_phy *phy, uint32_t idx_reg,
struct rf_rx_gain *rx_gain)
{
	struct spi_device *spi = phy->spi;
	int32_t val;
	enum rx_gain_table_name tbl;
	struct rx_gain_info *gain_info;
	int32_t rc = 0, rx_gain_db;

	tbl = ad9361_gt_tableindex(
		ad9361_from_clk(clk_get_rate(phy, phy->ref_clk_scale[RX_RFPLL])));

	rx_gain->fgt_lmt_index = val = ad9361_spi_readf(spi, idx_reg,
		FULL_TABLE_GAIN_INDEX(~0));
	gain_info = &phy->rx_gain[tbl];
	if (val > gain_info->idx_step_offset) {
		val = val - gain_info->idx_step_offset;
		rx_gain_db = gain_info->starting_gain_db +
			((val)* gain_info->gain_step_db);
	}
	else {
		rx_gain_db = gain_info->starting_gain_db;
	}

	/* Read Digital Gain */
	rx_gain->digital_gain = ad9361_spi_readf(spi, idx_reg + 2,
		DIGITAL_GAIN_RX(~0));

	rx_gain->gain_db = rx_gain_db;

	return rc;
}

/**
 * Get current RX gain for the selected channel.
 * @param phy The AD9361 state structure.
 * @param rx_id The desired channel number (0, 1).
 * @param rx_gain A rf_rx_gain struct to store the RF gain.
 * @return 0 in case of success, negative error code otherwise.
 */
int32_t ad9361_get_rx_gain(struct ad9361_rf_phy *phy,
	uint32_t rx_id, struct rf_rx_gain *rx_gain)
{
	struct spi_device *spi = phy->spi;
	uint32_t val, idx_reg;
	uint8_t gain_ctl_shift, rx_enable_mask;
	uint8_t fast_atk_shift;
	int32_t rc = 0;

	if (rx_id == 1) {
		gain_ctl_shift = RX1_GAIN_CTRL_SHIFT;
		idx_reg = REG_GAIN_RX1;
		rx_enable_mask = RX_CHANNEL_ENABLE(RX_1);
		fast_atk_shift = RX1_FAST_ATK_SHIFT;

	}
	else if (rx_id == 2) {
		gain_ctl_shift = RX2_GAIN_CTRL_SHIFT;
		idx_reg = REG_GAIN_RX2;
		rx_enable_mask = RX_CHANNEL_ENABLE(RX_2);
		fast_atk_shift = RX2_FAST_ATK_SHIFT;
	}
	else {
		dev_err(dev, "Unknown Rx path %"PRIu32, rx_id);
		rc = -EINVAL;
		goto out;
	}

	val = ad9361_spi_readf(spi, REG_RX_ENABLE_FILTER_CTRL, rx_enable_mask);

	if (!val) {
		dev_dbg(dev, "Rx%"PRIu32" is not enabled", rx_gain->ant);
		rc = -EAGAIN;
		goto out;
	}

	val = ad9361_spi_read(spi, REG_AGC_CONFIG_1);

	val = (val >> gain_ctl_shift) & RX_GAIN_CTL_MASK;

	if (val == RX_GAIN_CTL_AGC_FAST_ATK) {
		/* In fast attack mode check whether Fast attack state machine
		* has locked gain, if not then we can not read gain.
		*/
		val = ad9361_spi_read(spi, REG_FAST_ATTACK_STATE);
		val = (val >> fast_atk_shift) & FAST_ATK_MASK;
		if (val != FAST_ATK_GAIN_LOCKED) {
			dev_warn(dev, "Failed to read gain, state m/c at %"PRIx32,
				val);
			rc = -EAGAIN;
			goto out;
		}
	}

	if (has_split_gt && phy->pdata->split_gt)
		rc = ad9361_get_split_table_gain(phy, idx_reg, rx_gain);
	else
		rc = ad9361_get_full_table_gain(phy, idx_reg, rx_gain);

out:
	return rc;
}

/**
 * Force Enable State Machine (ENSM) to the desired state (internally used only).
 * @param phy The AD9361 state structure.
 * @param ensm_state The ENSM state [ENSM_STATE_SLEEP_WAIT, ENSM_STATE_ALERT,
 *                   ENSM_STATE_TX, ENSM_STATE_TX_FLUSH, ENSM_STATE_RX,
 *                   ENSM_STATE_RX_FLUSH, ENSM_STATE_FDD, ENSM_STATE_FDD_FLUSH].
 * @return None.
 */
void ad9361_ensm_force_state(struct ad9361_rf_phy *phy, uint8_t ensm_state)
{
	struct spi_device *spi = phy->spi;
	uint8_t dev_ensm_state;
	int32_t rc;
	uint32_t val;

	dev_ensm_state = ad9361_spi_readf(spi, REG_STATE, ENSM_STATE(~0));

	phy->prev_ensm_state = dev_ensm_state;

	if (dev_ensm_state == ensm_state) {
		dev_dbg(dev, "Nothing to do, device is already in %d state",
			ensm_state);
		goto out;
	}

	dev_dbg(dev, "Device is in %x state, forcing to %x", dev_ensm_state,
		ensm_state);

	val = ad9361_spi_read(spi, REG_ENSM_CONFIG_1);

	/* Enable control through SPI writes, and take out from
	* Alert
	*/
	if (val & ENABLE_ENSM_PIN_CTRL) {
		val &= ~ENABLE_ENSM_PIN_CTRL;
		phy->ensm_pin_ctl_en = true;
	}
	else {
		phy->ensm_pin_ctl_en = false;
	}

	if (dev_ensm_state)
		val &= ~(TO_ALERT);

	switch (ensm_state) {

	case ENSM_STATE_TX:
	case ENSM_STATE_FDD:
		val |= FORCE_TX_ON;
		break;
	case ENSM_STATE_RX:
		val |= FORCE_RX_ON;
		break;
	case ENSM_STATE_ALERT:
		val &= ~(FORCE_TX_ON | FORCE_RX_ON);
		val |= TO_ALERT | FORCE_ALERT_STATE;
		break;
	default:
		dev_err(dev, "No handling for forcing %d ensm state",
			ensm_state);
		goto out;
	}

	ad9361_spi_write(spi, REG_ENSM_CONFIG_1, TO_ALERT | FORCE_ALERT_STATE);

	rc = ad9361_spi_write(spi, REG_ENSM_CONFIG_1, val);
	if (rc)
		dev_err(dev, "Failed to restore state");

out:
	return;

}

/**
 * Restore the previous Enable State Machine (ENSM) state.
 * @param phy The AD9361 state structure.
 * @return None.
 */
void ad9361_ensm_restore_prev_state(struct ad9361_rf_phy *phy)
{
	struct spi_device *spi = phy->spi;
	int32_t rc;
	uint32_t val;

	val = ad9361_spi_read(spi, REG_ENSM_CONFIG_1);

	/* We are restoring state only, so clear State bits first
	* which might have set while forcing a particular state
	*/
	val &= ~(FORCE_TX_ON | FORCE_RX_ON |
		TO_ALERT | FORCE_ALERT_STATE);

	switch (phy->prev_ensm_state) {

	case ENSM_STATE_TX:
	case ENSM_STATE_FDD:
		val |= FORCE_TX_ON;
		break;
	case ENSM_STATE_RX:
		val |= FORCE_RX_ON;
		break;
	case ENSM_STATE_ALERT:
		val |= TO_ALERT;
		break;
	case ENSM_STATE_INVALID:
		dev_dbg(dev, "No need to restore, ENSM state wasn't saved");
		goto out;
	default:
		dev_dbg(dev, "Could not restore to %d ENSM state",
			phy->prev_ensm_state);
		goto out;
	}

	ad9361_spi_write(spi, REG_ENSM_CONFIG_1, TO_ALERT | FORCE_ALERT_STATE);

	rc = ad9361_spi_write(spi, REG_ENSM_CONFIG_1, val);
	if (rc) {
		dev_err(dev, "Failed to write ENSM_CONFIG_1");
		goto out;
	}

	if (phy->ensm_pin_ctl_en) {
		val |= ENABLE_ENSM_PIN_CTRL;
		rc = ad9361_spi_write(spi, REG_ENSM_CONFIG_1, val);
		if (rc)
			dev_err(dev, "Failed to write ENSM_CONFIG_1");
	}

out:
	return;
}

/**
 * Set gain in Split Gain Table Mode (used only in Manual Gain Control Mode).
 * @param phy The AD9361 state structure.
 * @param idx_reg Register base address for the selected receiver
 * @param rx_gain The rf_rx_gain struct containing the RF gain.
 * @return 0 in case of success, negative error code otherwise.
 */
static int32_t set_split_table_gain(struct ad9361_rf_phy *phy, uint32_t idx_reg,
struct rf_rx_gain *rx_gain)
{
	struct spi_device *spi = phy->spi;
	int32_t rc = 0;

	if ((rx_gain->fgt_lmt_index > MAX_LMT_INDEX) ||
		(rx_gain->lpf_gain > MAX_LPF_GAIN) ||
		(rx_gain->digital_gain > MAX_DIG_GAIN)) {
		dev_err(dev, "LMT_INDEX missing or greater than max value %d",
			MAX_LMT_INDEX);
		dev_err(dev, "LPF_GAIN missing or greater than max value %d",
			MAX_LPF_GAIN);
		dev_err(dev, "DIGITAL_GAIN cannot be more than %d",
			MAX_DIG_GAIN);
		rc = -EINVAL;
		goto out;
	}
	if (rx_gain->gain_db > 0)
		dev_dbg(dev, "Ignoring rx_gain value in split table mode.");
	if (rx_gain->fgt_lmt_index == 0 && rx_gain->lpf_gain == 0 &&
		rx_gain->digital_gain == 0) {
		dev_err(dev,
			"In split table mode, All LMT/LPF/digital gains cannot be 0");
		rc = -EINVAL;
		goto out;
	}

	ad9361_spi_writef(spi, idx_reg, RX_FULL_TBL_IDX_MASK, rx_gain->fgt_lmt_index);
	ad9361_spi_writef(spi, idx_reg + 1, RX_LPF_IDX_MASK, rx_gain->lpf_gain);

	if (phy->pdata->gain_ctrl.dig_gain_en) {
		ad9361_spi_writef(spi, idx_reg + 2, RX_DIGITAL_IDX_MASK, rx_gain->digital_gain);

	}
	else if (rx_gain->digital_gain > 0) {
		dev_err(dev, "Digital gain is disabled and cannot be set");
	}
out:
	return rc;
}

/**
 * Set gain in Full Gain Table Mode (used only in Manual Gain Control Mode).
 * @param phy The AD9361 state structure.
 * @param idx_reg Register base address for the selected receiver
 * @param rx_gain The rf_rx_gain struct containing the RF gain.
 * @return 0 in case of success, negative error code otherwise.
 */
static int32_t set_full_table_gain(struct ad9361_rf_phy *phy, uint32_t idx_reg,
struct rf_rx_gain *rx_gain)
{
	struct spi_device *spi = phy->spi;
	enum rx_gain_table_name tbl;
	struct rx_gain_info *gain_info;
	uint32_t val;
	int32_t rc = 0;

	if (rx_gain->fgt_lmt_index != (uint32_t)~0 || (int64_t)rx_gain->lpf_gain != (uint32_t)~0 ||
		rx_gain->digital_gain > 0)
		dev_dbg(dev,
		"Ignoring lmt/lpf/digital gains in Single Table mode");

	tbl = ad9361_gt_tableindex(
		ad9361_from_clk(clk_get_rate(phy, phy->ref_clk_scale[RX_RFPLL])));

	gain_info = &phy->rx_gain[tbl];
	if ((rx_gain->gain_db < gain_info->starting_gain_db) ||
		(rx_gain->gain_db > gain_info->max_gain_db)) {

		dev_err(dev, "Invalid gain %"PRId32", supported range [%"PRId32" - %"PRId32"]",
			rx_gain->gain_db, gain_info->starting_gain_db,
			gain_info->max_gain_db);
		rc = -EINVAL;
		goto out;

	}

	val = ((rx_gain->gain_db - gain_info->starting_gain_db) /
		gain_info->gain_step_db) + gain_info->idx_step_offset;
	ad9361_spi_writef(spi, idx_reg, RX_FULL_TBL_IDX_MASK, val);

out:
	return rc;
}

/**
 * Set the RX gain for the selected channel.
 * @param phy The AD9361 state structure.
 * @param rx_id The desired channel number (0, 1).
 * @param rx_gain The rf_rx_gain struct containing the RF gain.
 * @return 0 in case of success, negative error code otherwise.
 */
int32_t ad9361_set_rx_gain(struct ad9361_rf_phy *phy,
	uint32_t rx_id, struct rf_rx_gain *rx_gain)
{
	struct spi_device *spi = phy->spi;
	uint32_t val, idx_reg;
	uint8_t gain_ctl_shift;
	int32_t rc = 0;

	if (rx_id == 1) {
		gain_ctl_shift = RX1_GAIN_CTRL_SHIFT;
		idx_reg = REG_RX1_MANUAL_LMT_FULL_GAIN;

	}
	else if (rx_id == 2) {
		gain_ctl_shift = RX2_GAIN_CTRL_SHIFT;
		idx_reg = REG_RX2_MANUAL_LMT_FULL_GAIN;
	}
	else {
		dev_err(dev, "Unknown Rx path %"PRIu32, rx_id);
		rc = -EINVAL;
		goto out;

	}

	val = ad9361_spi_read(spi, REG_AGC_CONFIG_1);
	val = (val >> gain_ctl_shift) & RX_GAIN_CTL_MASK;

	if (val != RX_GAIN_CTL_MGC) {
		dev_dbg(dev, "Rx gain can be set in MGC mode only");
		goto out;
	}

	if (has_split_gt && phy->pdata->split_gt)
		rc = set_split_table_gain(phy, idx_reg, rx_gain);
	else
		rc = set_full_table_gain(phy, idx_reg, rx_gain);

	if (rc) {
		dev_err(dev, "Unable to write gain tbl idx reg: %"PRIu32, idx_reg);
		goto out;
	}

out:
	return rc;

}

/**
 * Initialize the rx_gain_info structure.
 * @param rx_gain The rx_gain_info structure pointer.
 * @param type Either Full or Split Table
 * @param starting_gain The starting gain value.
 * @param max_gain The maximum gain value.
 * @param gain_step The gain step.
 * @param max_idx The max table size.
 * @param idx_offset Offset in the table where linear progression starts
 * @return None
 */
static void ad9361_init_gain_info(struct rx_gain_info *rx_gain,
enum rx_gain_table_type type, int32_t starting_gain,
	int32_t max_gain, int32_t gain_step, int32_t max_idx, int32_t idx_offset)
{
	rx_gain->tbl_type = type;
	rx_gain->starting_gain_db = starting_gain;
	rx_gain->max_gain_db = max_gain;
	rx_gain->gain_step_db = gain_step;
	rx_gain->max_idx = max_idx;
	rx_gain->idx_step_offset = idx_offset;
}

/**
 * Initialize the gain table information.
 * @param phy The AD9361 state structure.
 * @return 0 in case of success, negative error code otherwise.
 */
int32_t ad9361_init_gain_tables(struct ad9361_rf_phy *phy)
{
	struct rx_gain_info *rx_gain;

	/* Intialize Meta data according to default gain tables
	* of AD9631. Changing/Writing of gain tables is not
	* supported yet.
	*/
	rx_gain = &phy->rx_gain[TBL_200_1300_MHZ];
	ad9361_init_gain_info(rx_gain, RXGAIN_FULL_TBL, 1, 77, 1,
		SIZE_FULL_TABLE, 0);

	rx_gain = &phy->rx_gain[TBL_1300_4000_MHZ];
	ad9361_init_gain_info(rx_gain, RXGAIN_FULL_TBL, -4, 71, 1,
		SIZE_FULL_TABLE, 1);

	rx_gain = &phy->rx_gain[TBL_4000_6000_MHZ];
	ad9361_init_gain_info(rx_gain, RXGAIN_FULL_TBL, -10, 62, 1,
		SIZE_FULL_TABLE, 4);

	return 0;
}

/**
 * Enable/disable the desired TX channel.
 * @param phy The AD9361 state structure.
 * @param tx_if The desired channel number [1, 2].
 * @param enable Enable/disable option.
 * @return 0 in case of success, negative error code otherwise.
 */
static int32_t ad9361_en_dis_tx(struct ad9361_rf_phy *phy, uint32_t tx_if, uint32_t enable)
{
	if (tx_if == 2 && !phy->pdata->rx2tx2 && enable)
		return -EINVAL;

	return ad9361_spi_writef(phy->spi, REG_TX_ENABLE_FILTER_CTRL,
		TX_CHANNEL_ENABLE(tx_if), enable);
}

/**
 * Enable/disable the desired RX channel.
 * @param phy The AD9361 state structure.
 * @param tx_if The desired channel number [1, 2].
 * @param enable Enable/disable option.
 * @return 0 in case of success, negative error code otherwise.
 */
static int32_t ad9361_en_dis_rx(struct ad9361_rf_phy *phy, uint32_t rx_if, uint32_t enable)
{
	if (rx_if == 2 && !phy->pdata->rx2tx2 && enable)
		return -EINVAL;

	return ad9361_spi_writef(phy->spi, REG_RX_ENABLE_FILTER_CTRL,
		RX_CHANNEL_ENABLE(rx_if), enable);
}

/**
 * Update the Gain Control.
 * @param phy The AD9361 state structure.
 * @return 0 in case of success, negative error code otherwise.
 */
static int32_t ad9361_gc_update(struct ad9361_rf_phy *phy)
{
	struct spi_device *spi = phy->spi;
	uint32_t clkrf;
	uint32_t reg, delay_lna, settling_delay, dec_pow_meas_dur;
	int32_t ret;
	uint32_t fir_div;

	clkrf = clk_get_rate(phy, phy->ref_clk_scale[CLKRF_CLK]);
	delay_lna = phy->pdata->elna_ctrl.settling_delay_ns;

	/*
	 * AGC Attack Delay (us)=ceiling((((0.2+Delay_LNA)*ClkRF+14))/(2*ClkRF))+1
	 * ClkRF in MHz, delay in us
	 */

	reg = (200 * delay_lna) / 2 + (14000000UL / (clkrf / 500U));
	reg = DIV_ROUND_UP(reg, 1000UL) +
		phy->pdata->gain_ctrl.agc_attack_delay_extra_margin_us;
	reg = clamp_t(uint8_t, reg, 0U, 31U);
	ret = ad9361_spi_writef(spi, REG_AGC_ATTACK_DELAY,
			  AGC_ATTACK_DELAY(~0), reg);

	/*
	 * Peak Overload Wait Time (ClkRF cycles)=ceiling((0.1+Delay_LNA) *clkRF+1)
	 */

	reg = (delay_lna + 100UL) * (clkrf / 1000UL);
	reg = DIV_ROUND_UP(reg, 1000000UL) + 1;
	reg = clamp_t(uint8_t, reg, 0U, 31U);
	ret |= ad9361_spi_writef(spi, REG_PEAK_WAIT_TIME,
			  PEAK_OVERLOAD_WAIT_TIME(~0), reg);

	/*
	 * Settling Delay in 0x111.  Applies to all gain control modes:
	 * 0x111[D4:D0]= ceiling(((0.2+Delay_LNA)*clkRF
	dodebug = false;+14)/2)
	 */

	reg = (delay_lna + 200UL) * (clkrf / 2000UL);
	reg = DIV_ROUND_UP(reg, 1000000UL) + 7;
	reg = settling_delay = clamp_t(uint8_t, reg, 0U, 31U);
	ret |= ad9361_spi_writef(spi, REG_FAST_CONFIG_2_SETTLING_DELAY,
			 SETTLING_DELAY(~0), reg);

	/*
	 * Gain Update Counter [15:0]= round((((time*ClkRF-0x111[D4:D0]*2)-2))/2)
	 */
	reg = phy->pdata->gain_ctrl.gain_update_interval_us * (clkrf / 1000UL) -
		settling_delay * 2000UL - 2000UL;

	reg = DIV_ROUND_CLOSEST(reg, 2000UL);
	reg = clamp_t(uint32_t, reg, 0U, 131071UL);

	if (phy->agc_mode[0] == RF_GAIN_FASTATTACK_AGC ||
		phy->agc_mode[1] == RF_GAIN_FASTATTACK_AGC) {
		dec_pow_meas_dur =
			phy->pdata->gain_ctrl.f_agc_dec_pow_measuremnt_duration;
	} else {
		fir_div = DIV_ROUND_CLOSEST(clkrf,
				clk_get_rate(phy, phy->ref_clk_scale[RX_SAMPL_CLK]));
		dec_pow_meas_dur = phy->pdata->gain_ctrl.dec_pow_measuremnt_duration;

		if (((reg * 2 / fir_div) / dec_pow_meas_dur) < 2) {
			dec_pow_meas_dur = reg / fir_div;
		}
	}

	/* Power Measurement Duration */
	ad9361_spi_writef(spi, REG_DEC_POWER_MEASURE_DURATION_0,
			  DEC_POWER_MEASUREMENT_DURATION(~0),
			  ilog2(dec_pow_meas_dur / 16));


	ret |= ad9361_spi_writef(spi, REG_DIGITAL_SAT_COUNTER,
			  DOUBLE_GAIN_COUNTER,  reg > 65535);

	if (reg > 65535)
		reg /= 2;

	ret |= ad9361_spi_write(spi, REG_GAIN_UPDATE_COUNTER1, reg & 0xFF);
	ret |= ad9361_spi_write(spi, REG_GAIN_UPDATE_COUNTER2, reg >> 8);

	/*
	 * Fast AGC State Wait Time - Energy Detect Count
	 */

	reg = DIV_ROUND_CLOSEST(phy->pdata->gain_ctrl.f_agc_state_wait_time_ns *
				(clkrf / 1000UL), 1000000UL);
	reg = clamp_t(uint32_t, reg, 0U, 31U);
	ret |= ad9361_spi_writef(spi, REG_FAST_ENERGY_DETECT_COUNT,
			  ENERGY_DETECT_COUNT(~0),  reg);

	return ret;
}

/**
 * Set the gain control mode.
 * @param phy The AD9361 state structure.
 * @param rf_gain_ctrl A rf_gain_ctrl struct that contains the the desired
 *        channel information and the gain control mode.
 * @return 0 in case of success, negative error code otherwise.
 */
int32_t ad9361_set_gain_ctrl_mode(struct ad9361_rf_phy *phy,
		struct rf_gain_ctrl *gain_ctrl)
{
	struct spi_device *spi = phy->spi;
	int32_t rc = 0;
	uint32_t gain_ctl_shift, mode;
	uint8_t val;

	rc = ad9361_spi_readm(spi, REG_AGC_CONFIG_1, &val, 1);
	if (rc) {
		dev_err(dev, "Unable to read AGC config1 register: %x",
			REG_AGC_CONFIG_1);
		goto out;
	}

	switch (gain_ctrl->mode) {
	case RF_GAIN_MGC:
		mode = RX_GAIN_CTL_MGC;
		break;
	case RF_GAIN_FASTATTACK_AGC:
		mode = RX_GAIN_CTL_AGC_FAST_ATK;
		break;
	case RF_GAIN_SLOWATTACK_AGC:
		mode = RX_GAIN_CTL_AGC_SLOW_ATK;
		break;
	case RF_GAIN_HYBRID_AGC:
		mode = RX_GAIN_CTL_AGC_SLOW_ATK_HYBD;
		break;
	default:
		rc = -EINVAL;
		goto out;
	}

	if (gain_ctrl->ant == 1) {
		gain_ctl_shift = RX1_GAIN_CTRL_SHIFT;
	}
	else if (gain_ctrl->ant == 2) {
		gain_ctl_shift = RX2_GAIN_CTRL_SHIFT;
	}
	else {
		dev_err(dev, "Unknown Rx path %"PRIu32, gain_ctrl->ant);
		rc = -EINVAL;
		goto out;
	}

	rc = ad9361_en_dis_rx(phy, gain_ctrl->ant, RX_DISABLE);
	if (rc) {
		dev_err(dev, "Unable to disable rx%"PRIu32, gain_ctrl->ant);
		goto out;
	}

	val &= ~(RX_GAIN_CTL_MASK << gain_ctl_shift);
	val |= mode << gain_ctl_shift;
	if (mode == RX_GAIN_CTL_AGC_SLOW_ATK_HYBD)
		val |= SLOW_ATTACK_HYBRID_MODE;
	else
		val &= ~SLOW_ATTACK_HYBRID_MODE;

	rc = ad9361_spi_write(spi, REG_AGC_CONFIG_1, val);
	if (rc) {
		dev_err(dev, "Unable to write AGC config1 register: %x",
			REG_AGC_CONFIG_1);
		goto out;
	}

	ad9361_en_dis_rx(phy, gain_ctrl->ant, RX_ENABLE);
	rc = ad9361_gc_update(phy);
out:
	return rc;
}

/**
 * Get the RSSI.
 * @param phy The AD9361 state structure.
 * @param rssi A rf_rssi struct to store the RSSI.
 * @return 0 in case of success, negative error code otherwise.
 */
int32_t ad9361_read_rssi(struct ad9361_rf_phy *phy, struct rf_rssi *rssi)
{
	struct spi_device *spi = phy->spi;
	uint8_t reg_val_buf[6];
	int32_t rc;

	rc = ad9361_spi_readm(spi, REG_PREAMBLE_LSB,
		reg_val_buf, ARRAY_SIZE(reg_val_buf));
	if (rssi->ant == 1) {
		rssi->symbol = RSSI_RESOLUTION *
			((reg_val_buf[5] << RSSI_LSB_SHIFT) +
			(reg_val_buf[1] & RSSI_LSB_MASK1));
		rssi->preamble = RSSI_RESOLUTION *
			((reg_val_buf[4] << RSSI_LSB_SHIFT) +
			(reg_val_buf[0] & RSSI_LSB_MASK1));
	}
	else if (rssi->ant == 2) {
		rssi->symbol = RSSI_RESOLUTION *
			((reg_val_buf[3] << RSSI_LSB_SHIFT) +
			((reg_val_buf[1] & RSSI_LSB_MASK2) >> 1));
		rssi->preamble = RSSI_RESOLUTION *
			((reg_val_buf[2] << RSSI_LSB_SHIFT) +
			((reg_val_buf[0] & RSSI_LSB_MASK2) >> 1));
	}
	else
		rc = -EFAULT;

	rssi->multiplier = RSSI_MULTIPLIER;

	return rc;
}

/**
 * Setup the RX ADC.
 * @param phy The AD9361 state structure.
 * @param bbpll_freq The BBPLL frequency [Hz].
 * @param adc_sampl_freq_Hz The ADC sampling frequency [Hz].
 * @return 0 in case of success, negative error code otherwise.
 */
static int32_t ad9361_rx_adc_setup(struct ad9361_rf_phy *phy, uint32_t bbpll_freq,
	uint32_t adc_sampl_freq_Hz)
{

	uint32_t scale_snr_1e3, maxsnr, sqrt_inv_rc_tconst_1e3, tmp_1e3,
		scaled_adc_clk_1e6, inv_scaled_adc_clk_1e3, sqrt_term_1e3,
		min_sqrt_term_1e3, bb_bw_Hz;
	uint64_t tmp, invrc_tconst_1e6;
	uint8_t data[40];
	uint32_t i;
	int32_t ret;

	uint8_t c3_msb = ad9361_spi_read(phy->spi, REG_RX_BBF_C3_MSB);
	uint8_t c3_lsb = ad9361_spi_read(phy->spi, REG_RX_BBF_C3_LSB);
	uint8_t r2346 = ad9361_spi_read(phy->spi, REG_RX_BBF_R2346);

	/*
	* BBBW = (BBPLL / RxTuneDiv) * ln(2) / (1.4 * 2PI )
	* We assume ad9361_rx_bb_analog_filter_calib() is always run prior
	*/

	tmp = bbpll_freq * 10000ULL;
	do_div(&tmp, 126906UL * phy->rxbbf_div);
	bb_bw_Hz = tmp;

	dev_dbg(&phy->spi->dev, "%s : BBBW %"PRIu32" : ADCfreq %"PRIu32,
		__func__, bb_bw_Hz, adc_sampl_freq_Hz);

	dev_dbg(&phy->spi->dev, "c3_msb 0x%X : c3_lsb 0x%X : r2346 0x%X : ",
		c3_msb, c3_lsb, r2346);

	bb_bw_Hz = clamp(bb_bw_Hz, 200000UL, 28000000UL);

	if (adc_sampl_freq_Hz < 80000000)
		scale_snr_1e3 = 1000;
	else
		scale_snr_1e3 = 1585; /* pow(10, scale_snr_dB/10); */

	if (bb_bw_Hz >= 18000000) {
		invrc_tconst_1e6 = (160975ULL * r2346 *
			(160 * c3_msb + 10 * c3_lsb + 140) *
			(bb_bw_Hz)* (1000 + (10 * (bb_bw_Hz - 18000000) / 1000000)));

		do_div(&invrc_tconst_1e6, 1000UL);

	}
	else {
		invrc_tconst_1e6 = (160975ULL * r2346 *
			(160 * c3_msb + 10 * c3_lsb + 140) *
			(bb_bw_Hz));
	}

	do_div(&invrc_tconst_1e6, 1000000000UL);

	if (invrc_tconst_1e6 > ULONG_MAX)
		dev_err(&phy->spi->dev, "invrc_tconst_1e6 > ULONG_MAX");

	sqrt_inv_rc_tconst_1e3 = int_sqrt((uint32_t)invrc_tconst_1e6);
	maxsnr = 640 / 160;
	scaled_adc_clk_1e6 = DIV_ROUND_CLOSEST(adc_sampl_freq_Hz, 640);
	inv_scaled_adc_clk_1e3 = DIV_ROUND_CLOSEST(640000000,
		DIV_ROUND_CLOSEST(adc_sampl_freq_Hz, 1000));
	tmp_1e3 = DIV_ROUND_CLOSEST(980000 + 20 * max_t(uint32_t, 1000U,
		DIV_ROUND_CLOSEST(inv_scaled_adc_clk_1e3, maxsnr)), 1000);
	sqrt_term_1e3 = int_sqrt(scaled_adc_clk_1e6);
	min_sqrt_term_1e3 = min_t(uint32_t, 1000U,
		int_sqrt(maxsnr * scaled_adc_clk_1e6));

	dev_dbg(&phy->spi->dev, "invrc_tconst_1e6 %"PRIu64", sqrt_inv_rc_tconst_1e3 %"PRIu32,
		invrc_tconst_1e6, sqrt_inv_rc_tconst_1e3);
	dev_dbg(&phy->spi->dev, "scaled_adc_clk_1e6 %"PRIu32", inv_scaled_adc_clk_1e3 %"PRIu32,
		scaled_adc_clk_1e6, inv_scaled_adc_clk_1e3);
	dev_dbg(&phy->spi->dev, "tmp_1e3 %"PRIu32", sqrt_term_1e3 %"PRIu32", min_sqrt_term_1e3 %"PRIu32,
		tmp_1e3, sqrt_term_1e3, min_sqrt_term_1e3);

	data[0] = 0;
	data[1] = 0;
	data[2] = 0;
	data[3] = 0x24;
	data[4] = 0x24;
	data[5] = 0;
	data[6] = 0;

	tmp = -50000000 + 8ULL * scale_snr_1e3 * sqrt_inv_rc_tconst_1e3 *
		min_sqrt_term_1e3;
	do_div(&tmp, 100000000UL);
	data[7] = min_t(uint64_t, 124U, tmp);

	tmp = (invrc_tconst_1e6 >> 1) + 20 * inv_scaled_adc_clk_1e3 *
		data[7] / 80 * 1000ULL;
	do_div(&tmp, invrc_tconst_1e6);
	data[8] = min_t(uint64_t, 255U, tmp);

	tmp = (-500000 + 77ULL * sqrt_inv_rc_tconst_1e3 * min_sqrt_term_1e3);
	do_div(&tmp, 1000000UL);
	data[10] = min_t(uint64_t, 127U, tmp);

	data[9] = min_t(uint32_t, 127U, ((800 * data[10]) / 1000));
	tmp = ((invrc_tconst_1e6 >> 1) + (20 * inv_scaled_adc_clk_1e3 *
		data[10] * 1000ULL));
	do_div(&tmp, invrc_tconst_1e6 * 77);
	data[11] = min_t(uint64_t, 255U, tmp);
	data[12] = min_t(uint32_t, 127U, (-500000 + 80 * sqrt_inv_rc_tconst_1e3 *
		min_sqrt_term_1e3) / 1000000UL);

	tmp = -3 * (long)(invrc_tconst_1e6 >> 1) + inv_scaled_adc_clk_1e3 *
		data[12] * (1000ULL * 20 / 80);
	do_div(&tmp, invrc_tconst_1e6);
	data[13] = min_t(uint64_t, 255, tmp);

	data[14] = 21 * (inv_scaled_adc_clk_1e3 / 10000);
	data[15] = min_t(uint32_t, 127U, (500 + 1025 * data[7]) / 1000);
	data[16] = min_t(uint32_t, 127U, (data[15] * tmp_1e3) / 1000);
	data[17] = data[15];
	data[18] = min_t(uint32_t, 127U, (500 + 975 * data[10]) / 1000);
	data[19] = min_t(uint32_t, 127U, (data[18] * tmp_1e3) / 1000);
	data[20] = data[18];
	data[21] = min_t(uint32_t, 127U, (500 + 975 * data[12]) / 1000);
	data[22] = min_t(uint32_t, 127, (data[21] * tmp_1e3) / 1000);
	data[23] = data[21];
	data[24] = 0x2E;
	data[25] = (128 + min_t(uint32_t, 63000U, DIV_ROUND_CLOSEST(63 *
		scaled_adc_clk_1e6, 1000)) / 1000);
	data[26] = min_t(uint32_t, 63U, 63 * scaled_adc_clk_1e6 / 1000000 *
		(920 + 80 * inv_scaled_adc_clk_1e3 / 1000) / 1000);
	data[27] = min_t(uint32_t, 63, (32 * sqrt_term_1e3) / 1000);
	data[28] = data[25];
	data[29] = data[26];
	data[30] = data[27];
	data[31] = data[25];
	data[32] = data[26];
	data[33] = min_t(uint32_t, 63U, 63 * sqrt_term_1e3 / 1000);
	data[34] = min_t(uint32_t, 127U, 64 * sqrt_term_1e3 / 1000);
	data[35] = 0x40;
	data[36] = 0x40;
	data[37] = 0x2C;
	data[38] = 0x00;
	data[39] = 0x00;

	for (i = 0; i < 40; i++) {
		ret = ad9361_spi_write(phy->spi, 0x200 + i, data[i]);
		if (ret < 0)
			return ret;
	}

	return 0;
}

/**
 * Perform a RX TIA calibration.
 * @param phy The AD9361 state structure.
 * @param bb_bw_Hz The baseband bandwidth [Hz].
 * @return 0 in case of success, negative error code otherwise.
 */
static int32_t ad9361_rx_tia_calib(struct ad9361_rf_phy *phy, uint32_t bb_bw_Hz)
{
	uint32_t Cbbf, R2346;
	uint64_t CTIA_fF;

	uint8_t reg1EB = ad9361_spi_read(phy->spi, REG_RX_BBF_C3_MSB);
	uint8_t reg1EC = ad9361_spi_read(phy->spi, REG_RX_BBF_C3_LSB);
	uint8_t reg1E6 = ad9361_spi_read(phy->spi, REG_RX_BBF_R2346);
	uint8_t reg1DB, reg1DF, reg1DD, reg1DC, reg1DE, temp;

	dev_dbg(&phy->spi->dev, "%s : bb_bw_Hz %"PRIu32,
		__func__, bb_bw_Hz);

	bb_bw_Hz = clamp(bb_bw_Hz, 200000UL, 20000000UL);

	Cbbf = (reg1EB * 160) + (reg1EC * 10) + 140; /* fF */
	R2346 = 18300 * RX_BBF_R2346(reg1E6);

	CTIA_fF = Cbbf * R2346 * 560ULL;
	do_div(&CTIA_fF, 3500000UL);

	if (bb_bw_Hz <= 3000000UL)
		reg1DB = 0xE0;
	else if (bb_bw_Hz <= 10000000UL)
		reg1DB = 0x60;
	else
		reg1DB = 0x20;

	if (CTIA_fF > 2920ULL) {
		reg1DC = 0x40;
		reg1DE = 0x40;
		temp = min(127U, DIV_ROUND_CLOSEST((uint32_t)CTIA_fF - 400, 320U));
		reg1DD = temp;
		reg1DF = temp;
	}
	else {
		temp = DIV_ROUND_CLOSEST((uint32_t)CTIA_fF - 400, 40U) + 0x40;
		reg1DC = temp;
		reg1DE = temp;
		reg1DD = 0;
		reg1DF = 0;
	}

	ad9361_spi_write(phy->spi, REG_RX_TIA_CONFIG, reg1DB);
	ad9361_spi_write(phy->spi, REG_TIA1_C_LSB, reg1DC);
	ad9361_spi_write(phy->spi, REG_TIA1_C_MSB, reg1DD);
	ad9361_spi_write(phy->spi, REG_TIA2_C_LSB, reg1DE);
	ad9361_spi_write(phy->spi, REG_TIA2_C_MSB, reg1DF);

	return 0;
}

/**
 * Perform a baseband RX analog filter calibration.
 * @param phy The AD9361 state structure.
 * @param rx_bb_bw The baseband bandwidth [Hz].
 * @param bbpll_freq The BBPLL frequency [Hz].
 * @return 0 in case of success, negative error code otherwise.
 */
static int32_t ad9361_rx_bb_analog_filter_calib(struct ad9361_rf_phy *phy,
	uint32_t rx_bb_bw,
	uint32_t bbpll_freq)
{
	uint32_t target;
	uint8_t tmp;
	int32_t ret;

	dev_dbg(&phy->spi->dev, "%s : rx_bb_bw %"PRIu32" bbpll_freq %"PRIu32,
		__func__, rx_bb_bw, bbpll_freq);

	rx_bb_bw = clamp(rx_bb_bw, 200000UL, 28000000UL);

	/* 1.4 * BBBW * 2PI / ln(2) */
	target = 126906UL * (rx_bb_bw / 10000UL);
	phy->rxbbf_div = min_t(uint32_t, 511UL, DIV_ROUND_UP(bbpll_freq, target));

	/* Set RX baseband filter divide value */
	ad9361_spi_write(phy->spi, REG_RX_BBF_TUNE_DIVIDE, phy->rxbbf_div);
	ad9361_spi_writef(phy->spi, REG_RX_BBF_TUNE_CONFIG, BIT(0), phy->rxbbf_div >> 8);

	/* Write the BBBW into registers 0x1FB and 0x1FC */
	ad9361_spi_write(phy->spi, REG_RX_BBBW_MHZ, rx_bb_bw / 1000000UL);

	tmp = DIV_ROUND_CLOSEST((rx_bb_bw % 1000000UL) * 128, 1000000UL);
	ad9361_spi_write(phy->spi, REG_RX_BBBW_KHZ, min_t(uint8_t, 127, tmp));

	ad9361_spi_write(phy->spi, REG_RX_MIX_LO_CM, RX_MIX_LO_CM(0x3F)); /* Set Rx Mix LO CM */
	ad9361_spi_write(phy->spi, REG_RX_MIX_GM_CONFIG, RX_MIX_GM_PLOAD(3)); /* Set GM common mode */

	/* Enable the RX BBF tune circuit by writing 0x1E2=0x02 and 0x1E3=0x02 */
	ad9361_spi_write(phy->spi, REG_RX1_TUNE_CTRL, RX1_TUNE_RESAMPLE);
	ad9361_spi_write(phy->spi, REG_RX2_TUNE_CTRL, RX2_TUNE_RESAMPLE);

	/* Start the RX Baseband Filter calibration in register 0x016[7] */
	/* Calibration is complete when register 0x016[7] self clears */
	ret = ad9361_run_calibration(phy, RX_BB_TUNE_CAL);

	/* Disable the RX baseband filter tune circuit, write 0x1E2=3, 0x1E3=3 */
	ad9361_spi_write(phy->spi, REG_RX1_TUNE_CTRL,
		RX1_TUNE_RESAMPLE | RX1_PD_TUNE);
	ad9361_spi_write(phy->spi, REG_RX2_TUNE_CTRL,
		RX2_TUNE_RESAMPLE | RX2_PD_TUNE);

	return ret;
}

/**
 * Perform a baseband TX analog filter calibration.
 * @param phy The AD9361 state structure.
 * @param tx_bb_bw The baseband bandwidth [Hz].
 * @param bbpll_freq The BBPLL frequency [Hz].
 * @return 0 in case of success, negative error code otherwise.
 */
static int32_t ad9361_tx_bb_analog_filter_calib(struct ad9361_rf_phy *phy,
	uint32_t tx_bb_bw,
	uint32_t bbpll_freq)
{
	uint32_t target, txbbf_div;
	int32_t ret;

	dev_dbg(&phy->spi->dev, "%s : tx_bb_bw %"PRIu32" bbpll_freq %"PRIu32,
		__func__, tx_bb_bw, bbpll_freq);

	tx_bb_bw = clamp(tx_bb_bw, 625000UL, 20000000UL);

	/* 1.6 * BBBW * 2PI / ln(2) */
	target = 145036 * (tx_bb_bw / 10000UL);
	txbbf_div = min_t(uint32_t, 511UL, DIV_ROUND_UP(bbpll_freq, target));

	/* Set TX baseband filter divide value */
	ad9361_spi_write(phy->spi, REG_TX_BBF_TUNE_DIVIDER, txbbf_div);
	ad9361_spi_writef(phy->spi, REG_TX_BBF_TUNE_MODE,
		TX_BBF_TUNE_DIVIDER, txbbf_div >> 8);

	/* Enable the TX baseband filter tune circuit by setting 0x0CA=0x22. */
	ad9361_spi_write(phy->spi, REG_TX_TUNE_CTRL, TUNER_RESAMPLE | TUNE_CTRL(1));

	/* Start the TX Baseband Filter calibration in register 0x016[6] */
	/* Calibration is complete when register 0x016[] self clears */
	ret = ad9361_run_calibration(phy, TX_BB_TUNE_CAL);

	/* Disable the TX baseband filter tune circuit by writing 0x0CA=0x26. */
	ad9361_spi_write(phy->spi, REG_TX_TUNE_CTRL,
		TUNER_RESAMPLE | TUNE_CTRL(1) | PD_TUNE);

	return ret;
}

/**
 * Perform a baseband TX secondary filter calibration.
 * @param phy The AD9361 state structure.
 * @param tx_rf_bw The RF bandwidth [Hz].
 * @return 0 in case of success, negative error code otherwise.
 */
static int32_t ad9361_tx_bb_second_filter_calib(struct ad9361_rf_phy *phy,
	uint32_t tx_bb_bw)
{
	uint64_t cap;
	uint32_t corner, res, div;
	uint32_t reg_conf, reg_res;
	int32_t ret, i;

	dev_dbg(&phy->spi->dev, "%s : tx_bb_bw %"PRIu32,
		__func__, tx_bb_bw);

	tx_bb_bw = clamp(tx_bb_bw, 530000UL, 20000000UL);

	/* BBBW * 5PI */
	corner = 15708 * (tx_bb_bw / 10000UL);

	for (i = 0, res = 1; i < 4; i++) {
		div = corner * res;
		cap = (500000000ULL) + (div >> 1);
		do_div(&cap, div);
		cap -= 12ULL;
		if (cap < 64ULL)
			break;

		res <<= 1;
	}

	if (cap > 63ULL)
		cap = 63ULL;

	if (tx_bb_bw <= 4500000UL)
		reg_conf = 0x59;
	else if (tx_bb_bw <= 12000000UL)
		reg_conf = 0x56;
	else
		reg_conf = 0x57;

	switch (res) {
	case 1:
		reg_res = 0x0C;
		break;
	case 2:
		reg_res = 0x04;
		break;
	case 4:
		reg_res = 0x03;
		break;
	case 8:
		reg_res = 0x01;
		break;
	default:
		reg_res = 0x01;
	}

	ret = ad9361_spi_write(phy->spi, REG_CONFIG0, reg_conf);
	ret |= ad9361_spi_write(phy->spi, REG_RESISTOR, reg_res);
	ret |= ad9361_spi_write(phy->spi, REG_CAPACITOR, (uint8_t)cap);

	return ret;
}

/**
 * Perform a RF synthesizer charge pump calibration.
 * @param phy The AD9361 state structure.
 * @param ref_clk_hz The reference clock rate [Hz].
 * @param tx The Synthesizer TX = 1, RX = 0.
 * @return 0 in case of success, negative error code otherwise.
 */
static int32_t ad9361_txrx_synth_cp_calib(struct ad9361_rf_phy *phy,
	uint32_t ref_clk_hz, bool tx)
{
	uint32_t offs = tx ? 0x40 : 0;
	uint32_t vco_cal_cnt;
	dev_dbg(&phy->spi->dev, "%s : ref_clk_hz %"PRIu32" : is_tx %d",
		__func__, ref_clk_hz, tx);

	/* REVIST: */
	ad9361_spi_write(phy->spi, REG_RX_CP_LEVEL_DETECT + offs, 0x17);

	ad9361_spi_write(phy->spi, REG_RX_DSM_SETUP_1 + offs, 0x0);

	ad9361_spi_write(phy->spi, REG_RX_LO_GEN_POWER_MODE + offs, 0x00);
	ad9361_spi_write(phy->spi, REG_RX_VCO_LDO + offs, 0x0B);
	ad9361_spi_write(phy->spi, REG_RX_VCO_PD_OVERRIDES + offs, 0x02);
	ad9361_spi_write(phy->spi, REG_RX_CP_CURRENT + offs, 0x80);
	ad9361_spi_write(phy->spi, REG_RX_CP_CONFIG + offs, 0x00);

	/* see Table 70 Example Calibration Times for RF VCO Cal */
	if (phy->pdata->fdd || phy->pdata->tdd_use_fdd_tables) {
		vco_cal_cnt = VCO_CAL_EN | VCO_CAL_COUNT(3) | FB_CLOCK_ADV(2);
	}
	else {
		if (ref_clk_hz > 40000000UL)
			vco_cal_cnt = VCO_CAL_EN | VCO_CAL_COUNT(1) |
			FB_CLOCK_ADV(2);
		else
			vco_cal_cnt = VCO_CAL_EN | VCO_CAL_COUNT(0) |
			FB_CLOCK_ADV(2);
	}

	ad9361_spi_write(phy->spi, REG_RX_VCO_CAL + offs, vco_cal_cnt);

	/* Enable FDD mode during calibrations */

	if (!phy->pdata->fdd) {
		ad9361_spi_writef(phy->spi, REG_PARALLEL_PORT_CONF_3,
				  HALF_DUPLEX_MODE, 0);
	}

	ad9361_spi_write(phy->spi, REG_ENSM_CONFIG_2, DUAL_SYNTH_MODE);
	ad9361_spi_write(phy->spi, REG_ENSM_CONFIG_1,
		FORCE_ALERT_STATE |
		TO_ALERT);
	ad9361_spi_write(phy->spi, REG_ENSM_MODE, FDD_MODE);

	ad9361_spi_write(phy->spi, REG_RX_CP_CONFIG + offs, CP_CAL_ENABLE);

	return ad9361_check_cal_done(phy, REG_RX_CAL_STATUS + offs,
		CP_CAL_VALID, 1);
}

/**
 * Perform a baseband DC offset calibration.
 * @param phy The AD9361 state structure.
 * @return 0 in case of success, negative error code otherwise.
 */
static int32_t ad9361_bb_dc_offset_calib(struct ad9361_rf_phy *phy)
{
	dev_dbg(&phy->spi->dev, "%s", __func__);

	ad9361_spi_write(phy->spi, REG_BB_DC_OFFSET_COUNT, 0x3F);
	ad9361_spi_write(phy->spi, REG_BB_DC_OFFSET_SHIFT, BB_DC_M_SHIFT(0xF));
	ad9361_spi_write(phy->spi, REG_BB_DC_OFFSET_ATTEN, BB_DC_OFFSET_ATTEN(1));

	return ad9361_run_calibration(phy, BBDC_CAL);
}

/**
 * Perform a RF DC offset calibration.
 * @param phy The AD9361 state structure.
 * @param ref_clk_hz The RX LO frequency [Hz].
 * @return 0 in case of success, negative error code otherwise.
 */
static int32_t ad9361_rf_dc_offset_calib(struct ad9361_rf_phy *phy,
	uint64_t rx_freq)
{
	struct spi_device *spi = phy->spi;

	dev_dbg(&phy->spi->dev, "%s : rx_freq %"PRIu64,
		__func__, rx_freq);

	ad9361_spi_write(spi, REG_WAIT_COUNT, 0x20);

	if (rx_freq <= 4000000000ULL) {
		ad9361_spi_write(spi, REG_RF_DC_OFFSET_COUNT,
			phy->pdata->rf_dc_offset_count_low);
		ad9361_spi_write(spi, REG_RF_DC_OFFSET_CONFIG_1,
			RF_DC_CALIBRATION_COUNT(4) | DAC_FS(2));
		ad9361_spi_write(spi, REG_RF_DC_OFFSET_ATTEN,
			RF_DC_OFFSET_ATTEN(
			phy->pdata->dc_offset_attenuation_low));
	}
	else {
		ad9361_spi_write(spi, REG_RF_DC_OFFSET_COUNT,
			phy->pdata->rf_dc_offset_count_high);
		ad9361_spi_write(spi, REG_RF_DC_OFFSET_CONFIG_1,
			RF_DC_CALIBRATION_COUNT(4) | DAC_FS(3));
		ad9361_spi_write(spi, REG_RF_DC_OFFSET_ATTEN,
			RF_DC_OFFSET_ATTEN(
			phy->pdata->dc_offset_attenuation_high));
	}

	ad9361_spi_write(spi, REG_DC_OFFSET_CONFIG2,
		USE_WAIT_COUNTER_FOR_RF_DC_INIT_CAL |
		DC_OFFSET_UPDATE(3));

	if (phy->pdata->rx1rx2_phase_inversion_en ||
		(phy->pdata->port_ctrl.pp_conf[1] & INVERT_RX2)) {
		ad9361_spi_write(spi, REG_INVERT_BITS,
				INVERT_RX1_RF_DC_CGOUT_WORD);
	} else {
		ad9361_spi_write(spi, REG_INVERT_BITS,
				INVERT_RX1_RF_DC_CGOUT_WORD |
				INVERT_RX2_RF_DC_CGOUT_WORD);
	}

	return ad9361_run_calibration(phy, RFDC_CAL);
}

/**
 * Update RF bandwidth.
 * @param phy The AD9361 state structure.
 * @param rf_rx_bw RF RX bandwidth [Hz].
 * @param rf_tx_bw RF TX bandwidth [Hz].
 * @return 0 in case of success, negative error code otherwise.
 */
static int32_t __ad9361_update_rf_bandwidth(struct ad9361_rf_phy *phy,
		uint32_t rf_rx_bw, uint32_t rf_tx_bw)
{
	uint32_t real_rx_bandwidth = rf_rx_bw / 2;
	uint32_t real_tx_bandwidth = rf_tx_bw / 2;
	uint32_t bbpll_freq;
	int32_t ret;

	dev_dbg(&phy->spi->dev, "%s: %"PRIu32" %"PRIu32,
		__func__, rf_rx_bw, rf_tx_bw);

	bbpll_freq = clk_get_rate(phy, phy->ref_clk_scale[BBPLL_CLK]);

	ret = ad9361_rx_bb_analog_filter_calib(phy,
				real_rx_bandwidth,
				bbpll_freq);
	if (ret < 0)
		return ret;

	ret = ad9361_tx_bb_analog_filter_calib(phy,
				real_tx_bandwidth,
				bbpll_freq);
	if (ret < 0)
		return ret;

	ret = ad9361_rx_tia_calib(phy, real_rx_bandwidth);
	if (ret < 0)
		return ret;

	ret = ad9361_tx_bb_second_filter_calib(phy, real_tx_bandwidth);
	if (ret < 0)
		return ret;

	ret = ad9361_rx_adc_setup(phy,
				bbpll_freq,
				clk_get_rate(phy, phy->ref_clk_scale[ADC_CLK]));
	if (ret < 0)
		return ret;

	return 0;
}

/**
 * TX Quad Calib.
 * @param phy The AD9361 state structure.
 * @param phase phase
 * @param rxnco_word Rx NCO word.
 * @param decim decim
 * @param res res
 * @return 0 in case of success, negative error code otherwise.
 */
static int32_t __ad9361_tx_quad_calib(struct ad9361_rf_phy *phy, uint32_t phase,
				  uint32_t rxnco_word, uint32_t decim, uint8_t *res)
{
	int32_t ret;

	ad9361_spi_write(phy->spi, REG_QUAD_CAL_NCO_FREQ_PHASE_OFFSET,
		RX_NCO_FREQ(rxnco_word) | RX_NCO_PHASE_OFFSET(phase));
	ad9361_spi_write(phy->spi, REG_QUAD_CAL_CTRL,
			SETTLE_MAIN_ENABLE | DC_OFFSET_ENABLE | QUAD_CAL_SOFT_RESET |
			GAIN_ENABLE | PHASE_ENABLE | M_DECIM(decim));
	ad9361_spi_write(phy->spi, REG_QUAD_CAL_CTRL,
			SETTLE_MAIN_ENABLE | DC_OFFSET_ENABLE |
			GAIN_ENABLE | PHASE_ENABLE | M_DECIM(decim));

	ret =  ad9361_run_calibration(phy, TX_QUAD_CAL);
	if (ret < 0)
		return ret;

	if (res)
		*res = ad9361_spi_read(phy->spi, REG_QUAD_CAL_STATUS_TX1) &
				(TX1_LO_CONV | TX1_SSB_CONV);

	return 0;
}

/**
 * Loop through all possible phase offsets in case the QUAD CAL doesn't converge.
 * @param phy The AD9361 state structure.
 * @param rxnco_word Rx NCO word.
 * @return 0 in case of success, negative error code otherwise.
 */
static int32_t ad9361_tx_quad_phase_search(struct ad9361_rf_phy *phy, uint32_t rxnco_word, uint8_t decim)
{
	int32_t i, ret;
	uint8_t field[64], val;
	uint32_t start;

	dev_dbg(&phy->spi->dev, "%s", __func__);

	for (i = 0; i < (int64_t)(ARRAY_SIZE(field) / 2); i++) {
		ret =  __ad9361_tx_quad_calib(phy, i, rxnco_word, decim, &val);
		if (ret < 0)
			return ret;

		/* Handle 360/0 wrap around */
		field[i] = field[i + 32] = !((val & TX1_LO_CONV) && (val & TX1_SSB_CONV));
	}

	ret = ad9361_find_opt(field, ARRAY_SIZE(field), &start);

	phy->last_tx_quad_cal_phase = (start + ret / 2) & 0x1F;

#ifdef _DEBUG
	for (i = 0; i < 64; i++) {
		printk("%c", (field[i] ? '#' : 'o'));
	}
#ifdef WIN32
	printk(" RX_NCO_PHASE_OFFSET(%d, 0x%X) \n", phy->last_tx_quad_cal_phase,
			phy->last_tx_quad_cal_phase);
#else
	printk(" RX_NCO_PHASE_OFFSET(%"PRIu32", 0x%"PRIX32") \n", phy->last_tx_quad_cal_phase,
	       phy->last_tx_quad_cal_phase);
#endif
#endif

	ret = __ad9361_tx_quad_calib(phy, phy->last_tx_quad_cal_phase, rxnco_word, decim, NULL);
	if (ret < 0)
		return ret;

	return 0;
}

/**
 * Perform a TX quadrature calibration.
 * @param phy The AD9361 state structure.
 * @param bw The bandwidth [Hz].
 * @param rx_phase The optional RX phase value overwrite (set to zero).
 * @return 0 in case of success, negative error code otherwise.
 */
static int32_t ad9361_tx_quad_calib(struct ad9361_rf_phy *phy,
	uint32_t bw_rx, uint32_t bw_tx,
	int32_t rx_phase)
{
	struct spi_device *spi = phy->spi;
	uint32_t clktf, clkrf;
	int32_t txnco_word, rxnco_word, txnco_freq, ret;
	uint8_t __rx_phase = 0, reg_inv_bits = 0, val, decim;
	const uint8_t(*tab)[3];
	uint32_t index_max, i, lpf_tia_mask;

	/*
	* Find NCO frequency that matches this equation:
	* BW / 4 = Rx NCO freq = Tx NCO freq:
	* Rx NCO = ClkRF * (rxNCO <1:0> + 1) / 32
	* Tx NCO = ClkTF * (txNCO <1:0> + 1) / 32
	*/

	clkrf = clk_get_rate(phy, phy->ref_clk_scale[CLKRF_CLK]);
	clktf = clk_get_rate(phy, phy->ref_clk_scale[CLKTF_CLK]);

	dev_dbg(&phy->spi->dev, "%s : bw_tx %"PRIu32" clkrf %"PRIu32" clktf %"PRIu32,
		__func__, bw_tx, clkrf, clktf);

	txnco_word = DIV_ROUND_CLOSEST(bw_tx * 8, clktf) - 1;
	txnco_word = clamp_t(int, txnco_word, 0, 3);
	rxnco_word = txnco_word;

	dev_dbg(dev, "Tx NCO frequency: %"PRIu32" (BW/4: %"PRIu32") txnco_word %"PRId32,
			clktf * (txnco_word + 1) / 32, bw_tx / 4, txnco_word);

	if (clktf <= 4000000UL)
		decim = 2;
	else
		decim = 3;

	if (clkrf == (2 * clktf)) {
		__rx_phase = 0x0E;
		switch (txnco_word) {
		case 0:
			txnco_word++;
			break;
		case 1:
			rxnco_word--;
			break;
		case 2:
			rxnco_word -= 2;
			txnco_word--;
			break;
		case 3:
			rxnco_word -= 2;	/* REVISIT */
			__rx_phase = 0x08;
			break;
		}
	}
	else if (clkrf == clktf) {
		switch (txnco_word) {
		case 0:
		case 3:
			__rx_phase = 0x15;
			break;
		case 2:
			__rx_phase = 0x1F;
			break;
		case 1:
			if (ad9361_spi_readf(spi,
				REG_TX_ENABLE_FILTER_CTRL, 0x3F) == 0x22)
				__rx_phase = 0x15; 	/* REVISIT */
			else
				__rx_phase = 0x1A;
			break;
		}
	}
	else
		dev_err(dev, "Unhandled case in %s line %d clkrf %"PRIu32" clktf %"PRIu32,
		__func__, __LINE__, clkrf, clktf);


	if (rx_phase >= 0)
		__rx_phase = rx_phase;

	txnco_freq = clktf * (txnco_word + 1) / 32;

	if (txnco_freq > (int64_t)(bw_rx / 4) || txnco_freq > (int64_t)(bw_tx / 4)) {
		/* Make sure the BW during calibration is wide enough */
		ret = __ad9361_update_rf_bandwidth(phy, txnco_freq * 8, txnco_freq * 8);
		if (ret < 0)
			return ret;
	}

	if (phy->pdata->rx1rx2_phase_inversion_en ||
		(phy->pdata->port_ctrl.pp_conf[1] & INVERT_RX2)) {

		ad9361_spi_writef(spi, REG_PARALLEL_PORT_CONF_2, INVERT_RX2, 0);

		reg_inv_bits = ad9361_spi_read(spi, REG_INVERT_BITS);

		ad9361_spi_write(spi, REG_INVERT_BITS,
					INVERT_RX1_RF_DC_CGOUT_WORD |
					INVERT_RX2_RF_DC_CGOUT_WORD);
	}

	ad9361_spi_writef(spi, REG_KEXP_2, TX_NCO_FREQ(~0), txnco_word);
	ad9361_spi_write(spi, REG_QUAD_CAL_COUNT, 0xFF);
	ad9361_spi_write(spi, REG_KEXP_1, KEXP_TX(1) | KEXP_TX_COMP(3) |
		KEXP_DC_I(3) | KEXP_DC_Q(3));
	ad9361_spi_write(spi, REG_MAG_FTEST_THRESH, 0x01);
	ad9361_spi_write(spi, REG_MAG_FTEST_THRESH_2, 0x01);

	if (has_split_gt && phy->pdata->split_gt) {
		tab = &split_gain_table[phy->current_table][0];
		index_max = SIZE_SPLIT_TABLE;
		lpf_tia_mask = 0x20;
	}
	else {
		tab = &full_gain_table[phy->current_table][0];
		index_max = SIZE_FULL_TABLE;
		lpf_tia_mask = 0x3F;
	}

	for (i = 0; i < index_max; i++)
	if ((tab[i][1] & lpf_tia_mask) == 0x20) {
		ad9361_spi_write(spi, REG_TX_QUAD_FULL_LMT_GAIN, i);
		break;
	}

	if (i >= index_max)
		dev_err(dev, "failed to find suitable LPF TIA value in gain table");

	ad9361_spi_write(spi, REG_QUAD_SETTLE_COUNT, 0xF0);
	ad9361_spi_write(spi, REG_TX_QUAD_LPF_GAIN, 0x00);

	ret = __ad9361_tx_quad_calib(phy, __rx_phase, rxnco_word, decim, &val);

	dev_dbg(dev, "LO leakage: %d Quadrature Calibration: %d : rx_phase %d",
		!!(val & TX1_LO_CONV), !!(val & TX1_SSB_CONV), __rx_phase);

	/* Calibration failed -> try last phase offset */
	if (val != (TX1_LO_CONV | TX1_SSB_CONV)) {
		if (phy->last_tx_quad_cal_phase < 31)
			ret = __ad9361_tx_quad_calib(phy, phy->last_tx_quad_cal_phase,
						     rxnco_word, decim, &val);
	} else {
		phy->last_tx_quad_cal_phase = __rx_phase;
	}

	/* Calibration failed -> loop through all 32 phase offsets */
	if (val != (TX1_LO_CONV | TX1_SSB_CONV))
		ret = ad9361_tx_quad_phase_search(phy, rxnco_word, decim);

	if (phy->pdata->rx1rx2_phase_inversion_en ||
		(phy->pdata->port_ctrl.pp_conf[1] & INVERT_RX2)) {
		ad9361_spi_writef(spi, REG_PARALLEL_PORT_CONF_2, INVERT_RX2, 1);
		ad9361_spi_write(spi, REG_INVERT_BITS, reg_inv_bits);
	}

	if (phy->pdata->rx1rx2_phase_inversion_en ||
		(phy->pdata->port_ctrl.pp_conf[1] & INVERT_RX2)) {
		ad9361_spi_writef(spi, REG_PARALLEL_PORT_CONF_2, INVERT_RX2, 1);
		ad9361_spi_write(spi, REG_INVERT_BITS, reg_inv_bits);
	}

	if (txnco_freq > (int64_t)(bw_rx / 4) || txnco_freq > (int64_t)(bw_tx / 4)) {
		__ad9361_update_rf_bandwidth(phy,
			phy->current_rx_bw_Hz,
			phy->current_tx_bw_Hz);
	}

	return ret;
}

/**
 * Setup RX tracking calibrations.
 * @param phy The AD9361 state structure.
 * @param bbdc_track Set true, will enable the BBDC tracking.
 * @param rfdc_track Set true, will enable the RFDC tracking.
 * @param rxquad_track Set true, will enable the RXQUAD tracking.
 * @return 0 in case of success, negative error code otherwise.
 */
int32_t ad9361_tracking_control(struct ad9361_rf_phy *phy, bool bbdc_track,
	bool rfdc_track, bool rxquad_track)
{
	struct spi_device *spi = phy->spi;
	uint32_t qtrack = 0;

	dev_dbg(&spi->dev, "%s : bbdc_track=%d, rfdc_track=%d, rxquad_track=%d",
		__func__, bbdc_track, rfdc_track, rxquad_track);

	ad9361_spi_write(spi, REG_CALIBRATION_CONFIG_2,
		CALIBRATION_CONFIG2_DFLT | K_EXP_PHASE(0x15));
	ad9361_spi_write(spi, REG_CALIBRATION_CONFIG_3,
		PREVENT_POS_LOOP_GAIN | K_EXP_AMPLITUDE(0x15));

	ad9361_spi_write(spi, REG_DC_OFFSET_CONFIG2,
		USE_WAIT_COUNTER_FOR_RF_DC_INIT_CAL |
		DC_OFFSET_UPDATE(phy->pdata->dc_offset_update_events) |
		(bbdc_track ? ENABLE_BB_DC_OFFSET_TRACKING : 0) |
		(rfdc_track ? ENABLE_RF_OFFSET_TRACKING : 0));

	ad9361_spi_writef(spi, REG_RX_QUAD_GAIN2,
			 CORRECTION_WORD_DECIMATION_M(~0),
			 phy->pdata->qec_tracking_slow_mode_en ? 4 : 0);

	if (rxquad_track)
		qtrack = ENABLE_TRACKING_MODE_CH1 |
		(phy->pdata->rx2tx2 ? ENABLE_TRACKING_MODE_CH2 : 0);

	ad9361_spi_write(spi, REG_CALIBRATION_CONFIG_1,
		ENABLE_PHASE_CORR | ENABLE_GAIN_CORR |
		FREE_RUN_MODE | ENABLE_CORR_WORD_DECIMATION |
		qtrack);

	return 0;
}

/**
 * Enable/disable the VCO cal.
 * @param phy The AD9361 state structure.
 * @param rx Set true for rx.
 * @param enable Set true to enable.
 * @return 0 in case of success, negative error code otherwise.
 */
static int32_t ad9361_trx_vco_cal_control(struct ad9361_rf_phy *phy,
	bool tx, bool enable)
{
	dev_dbg(&phy->spi->dev, "%s : state %d",
		__func__, enable);

	return ad9361_spi_writef(phy->spi,
		tx ? REG_TX_PFD_CONFIG : REG_RX_PFD_CONFIG,
		BYPASS_LD_SYNTH, !enable);
}

/**
 * Enable/disable the ext. LO.
 * @param phy The AD9361 state structure.
 * @param rx Set true for rx.
 * @param enable Set true to enable.
 * @return 0 in case of success, negative error code otherwise.
 */
static int32_t ad9361_trx_ext_lo_control(struct ad9361_rf_phy *phy,
	bool tx, bool enable)
{
	int32_t val = enable ? ~0 : 0;
	int32_t ret;

	/* REVIST:
	 * POWER_DOWN_TRX_SYNTH and MCS_RF_ENABLE somehow conflict
	 */

	bool mcs_rf_enable = ad9361_spi_readf(phy->spi,
		REG_MULTICHIP_SYNC_AND_TX_MON_CTRL, MCS_RF_ENABLE);

	dev_dbg(&phy->spi->dev, "%s : %s state %d",
		__func__, tx ? "TX" : "RX", enable);

	if (tx) {
		ret = ad9361_spi_writef(phy->spi, REG_ENSM_CONFIG_2,
				POWER_DOWN_TX_SYNTH, mcs_rf_enable ? 0 : enable);

		ret |= ad9361_spi_writef(phy->spi, REG_RFPLL_DIVIDERS,
				TX_VCO_DIVIDER(~0), enable ? 7 :
				phy->cached_tx_rfpll_div);

		ret |= ad9361_spi_write(phy->spi, REG_TX_SYNTH_POWER_DOWN_OVERRIDE,
				enable ? TX_SYNTH_VCO_ALC_POWER_DOWN |
				TX_SYNTH_PTAT_POWER_DOWN |
				TX_SYNTH_VCO_POWER_DOWN : 0);

		ret |= ad9361_spi_writef(phy->spi, REG_ANALOG_POWER_DOWN_OVERRIDE,
				TX_EXT_VCO_BUFFER_POWER_DOWN, !enable);

		ret |= ad9361_spi_write(phy->spi, REG_TX_LO_GEN_POWER_MODE,
				TX_LO_GEN_POWER_MODE(val));
	}
	else {
		ret = ad9361_spi_writef(phy->spi, REG_ENSM_CONFIG_2,
				POWER_DOWN_RX_SYNTH, mcs_rf_enable ? 0 : enable);

		ret |= ad9361_spi_writef(phy->spi, REG_RFPLL_DIVIDERS,
				RX_VCO_DIVIDER(~0), enable ? 7 :
				phy->cached_rx_rfpll_div);

		ret |= ad9361_spi_write(phy->spi, REG_RX_SYNTH_POWER_DOWN_OVERRIDE,
				enable ? RX_SYNTH_VCO_ALC_POWER_DOWN |
				RX_SYNTH_PTAT_POWER_DOWN |
				RX_SYNTH_VCO_POWER_DOWN : 0);

		ret |= ad9361_spi_writef(phy->spi, REG_ANALOG_POWER_DOWN_OVERRIDE,
				RX_EXT_VCO_BUFFER_POWER_DOWN, !enable);

		ret |= ad9361_spi_write(phy->spi, REG_RX_LO_GEN_POWER_MODE,
				RX_LO_GEN_POWER_MODE(val));
	}

	return ret;
}

/**
 * Setup the reference clock delay unit counter register.
 * @param phy The AD9361 state structure.
 * @param ref_clk_hz The reference clock frequency [Hz].
 * @return 0 in case of success, negative error code otherwise.
 */
static int32_t ad9361_set_ref_clk_cycles(struct ad9361_rf_phy *phy,
	uint32_t ref_clk_hz)
{
	dev_dbg(&phy->spi->dev, "%s : ref_clk_hz %"PRIu32,
		__func__, ref_clk_hz);

	return ad9361_spi_write(phy->spi, REG_REFERENCE_CLOCK_CYCLES,
		REFERENCE_CLOCK_CYCLES_PER_US((ref_clk_hz / 1000000UL) - 1));
}

/**
 * Setup the DCXO tune.
 * @param phy The AD9361 state structure.
 * @param coarse The DCXO tune coarse.
 * @param fine The DCXO tune fine.
 * @return 0 in case of success, negative error code otherwise.
 */
static int32_t ad9361_set_dcxo_tune(struct ad9361_rf_phy *phy,
	uint32_t coarse, uint32_t fine)
{
	dev_dbg(&phy->spi->dev, "%s : coarse %"PRIu32" fine %"PRIu32,
		__func__, coarse, fine);

	ad9361_spi_write(phy->spi, REG_DCXO_COARSE_TUNE,
		DCXO_TUNE_COARSE(coarse));
	ad9361_spi_write(phy->spi, REG_DCXO_FINE_TUNE_LOW,
		DCXO_TUNE_FINE_LOW(fine));
	return ad9361_spi_write(phy->spi, REG_DCXO_FINE_TUNE_HIGH,
		DCXO_TUNE_FINE_HIGH(fine));
}

/**
 * Setup TXMON.
 * @param phy The AD9361 state structure.
 * @param ctrl The TXMON settings.
 * @return 0 in case of success, negative error code otherwise.
 */
static int32_t ad9361_txmon_setup(struct ad9361_rf_phy *phy,
			       struct tx_monitor_control *ctrl)
{
	struct spi_device *spi = phy->spi;

	dev_dbg(&phy->spi->dev, "%s", __func__);

	ad9361_spi_write(spi, REG_TPM_MODE_ENABLE,
			 (ctrl->one_shot_mode_en ? ONE_SHOT_MODE : 0) |
			 TX_MON_DURATION(ilog2(ctrl->tx_mon_duration / 16)));

	ad9361_spi_write(spi, REG_TX_MON_DELAY, ctrl->tx_mon_delay);

	ad9361_spi_write(spi, REG_TX_MON_1_CONFIG,
			 TX_MON_1_LO_CM(ctrl->tx1_mon_lo_cm) |
			 TX_MON_1_GAIN(ctrl->tx1_mon_front_end_gain));
	ad9361_spi_write(spi, REG_TX_MON_2_CONFIG,
			 TX_MON_2_LO_CM(ctrl->tx2_mon_lo_cm) |
			 TX_MON_2_GAIN(ctrl->tx2_mon_front_end_gain));

	ad9361_spi_write(spi, REG_TX_ATTEN_THRESH,
			 ctrl->low_high_gain_threshold_mdB / 250);

	ad9361_spi_write(spi, REG_TX_MON_HIGH_GAIN,
			 TX_MON_HIGH_GAIN(ctrl->high_gain_dB));

	ad9361_spi_write(spi, REG_TX_MON_LOW_GAIN,
			 (ctrl->tx_mon_track_en ? TX_MON_TRACK : 0) |
			 TX_MON_LOW_GAIN(ctrl->low_gain_dB));

	return 0;
}

/**
 * Enable TXMON.
 * @param phy The AD9361 state structure.
 * @param en_mask The enable mask.
 * @return 0 in case of success, negative error code otherwise.
 */
static int32_t ad9361_txmon_control(struct ad9361_rf_phy *phy,
				int32_t en_mask)
{
	dev_dbg(&phy->spi->dev, "%s: mask 0x%"PRIx32, __func__, en_mask);

#if 0
	if (!phy->pdata->fdd && en_mask) {
		ad9361_spi_writef(phy->spi, REG_ENSM_CONFIG_1,
				ENABLE_RX_DATA_PORT_FOR_CAL, 1);
		phy->txmon_tdd_en = true;
	} else {
		ad9361_spi_writef(phy->spi, REG_ENSM_CONFIG_1,
				ENABLE_RX_DATA_PORT_FOR_CAL, 0);
		phy->txmon_tdd_en = false;
	}
#endif

	ad9361_spi_writef(phy->spi, REG_ANALOG_POWER_DOWN_OVERRIDE,
			TX_MONITOR_POWER_DOWN(~0), ~en_mask);

	ad9361_spi_writef(phy->spi, REG_TPM_MODE_ENABLE,
			TX1_MON_ENABLE, !!(en_mask & TX_1));

	return ad9361_spi_writef(phy->spi, REG_TPM_MODE_ENABLE,
			TX2_MON_ENABLE, !!(en_mask & TX_2));
}

/**
* Setup the RF port.
* Note:
* val
* 0	(RX1A_N &  RX1A_P) and (RX2A_N & RX2A_P) enabled; balanced
* 1	(RX1B_N &  RX1B_P) and (RX2B_N & RX2B_P) enabled; balanced
* 2	(RX1C_N &  RX1C_P) and (RX2C_N & RX2C_P) enabled; balanced
*
* 3	RX1A_N and RX2A_N enabled; unbalanced
* 4	RX1A_P and RX2A_P enabled; unbalanced
* 5	RX1B_N and RX2B_N enabled; unbalanced
* 6	RX1B_P and RX2B_P enabled; unbalanced
* 7	RX1C_N and RX2C_N enabled; unbalanced
* 8	RX1C_P and RX2C_P enabled; unbalanced
* 9 TX_MON1
* 10 TX_MON2
* 11 TX_MON1 & TX_MON2
* @param phy The AD9361 state structure.
* @param rx_inputs RX input option identifier
* @param txb TX output option identifier
* @return 0 in case of success, negative error code otherwise.
*/
int32_t ad9361_rf_port_setup(struct ad9361_rf_phy *phy, bool is_out,
				    uint32_t rx_inputs, uint32_t txb)
{
	uint32_t val;

	if (rx_inputs > 11)
		return -EINVAL;

	if (!is_out) {
		if (rx_inputs > 8)
			return ad9361_txmon_control(phy, rx_inputs & (TX_1 | TX_2));
		else
			ad9361_txmon_control(phy, 0);
	}

	if (rx_inputs < 3)
		val = 3 << (rx_inputs * 2);
	else
		val = 1 << (rx_inputs - 3);

	if (txb)
		val |= TX_OUTPUT; /* Select TX1B, TX2B */

	dev_dbg(&phy->spi->dev, "%s : INPUT_SELECT 0x%"PRIx32,
		__func__, val);

	return ad9361_spi_write(phy->spi, REG_INPUT_SELECT, val);
}

/**
 * Setup the Parallel Port (Digital Data Interface).
 * @param phy The AD9361 state structure.
 * @param restore_c3 Set true, will restore the Parallel Port Configuration 3
 *                   register.
 * @return 0 in case of success, negative error code otherwise.
 */
static int32_t ad9361_pp_port_setup(struct ad9361_rf_phy *phy, bool restore_c3)
{
	struct spi_device *spi = phy->spi;
	struct ad9361_phy_platform_data *pd = phy->pdata;

	dev_dbg(&phy->spi->dev, "%s", __func__);

	if (restore_c3) {
		return ad9361_spi_write(spi, REG_PARALLEL_PORT_CONF_3,
			pd->port_ctrl.pp_conf[2]);
	}

	/* Sanity check */
	if (pd->port_ctrl.pp_conf[2] & LVDS_MODE)
		pd->port_ctrl.pp_conf[2] &=
		~(HALF_DUPLEX_MODE | SINGLE_DATA_RATE | SINGLE_PORT_MODE);

	if (pd->port_ctrl.pp_conf[2] & FULL_PORT)
		pd->port_ctrl.pp_conf[2] &= ~(HALF_DUPLEX_MODE | SINGLE_PORT_MODE);

	ad9361_spi_write(spi, REG_PARALLEL_PORT_CONF_1, pd->port_ctrl.pp_conf[0]);
	ad9361_spi_write(spi, REG_PARALLEL_PORT_CONF_2, pd->port_ctrl.pp_conf[1]);
	ad9361_spi_write(spi, REG_PARALLEL_PORT_CONF_3, pd->port_ctrl.pp_conf[2]);
	ad9361_spi_write(spi, REG_RX_CLOCK_DATA_DELAY, pd->port_ctrl.rx_clk_data_delay);
	ad9361_spi_write(spi, REG_TX_CLOCK_DATA_DELAY, pd->port_ctrl.tx_clk_data_delay);

	ad9361_spi_write(spi, REG_LVDS_BIAS_CTRL, pd->port_ctrl.lvds_bias_ctrl);
	//	ad9361_spi_write(spi, REG_DIGITAL_IO_CTRL, pd->port_ctrl.digital_io_ctrl);
	ad9361_spi_write(spi, REG_LVDS_INVERT_CTRL1, pd->port_ctrl.lvds_invert[0]);
	ad9361_spi_write(spi, REG_LVDS_INVERT_CTRL2, pd->port_ctrl.lvds_invert[1]);

	if (pd->rx1rx2_phase_inversion_en ||
		(pd->port_ctrl.pp_conf[1] & INVERT_RX2)) {

		ad9361_spi_writef(spi, REG_PARALLEL_PORT_CONF_2, INVERT_RX2, 1);
		ad9361_spi_writef(spi, REG_INVERT_BITS,
				  INVERT_RX2_RF_DC_CGOUT_WORD, 0);
	}

	return 0;
}

/**
 * Setup the Gain Control Blocks (common function for MGC, AGC modes)
 * @param phy The AD9361 state structure.
 * @param ctrl The gain control settings.
 * @return 0 in case of success, negative error code otherwise.
 */
static int32_t ad9361_gc_setup(struct ad9361_rf_phy *phy, struct gain_control *ctrl)
{
	struct spi_device *spi = phy->spi;
	uint32_t reg, tmp1, tmp2;

	dev_dbg(&phy->spi->dev, "%s", __func__);

	reg = DEC_PWR_FOR_GAIN_LOCK_EXIT | DEC_PWR_FOR_LOCK_LEVEL |
		DEC_PWR_FOR_LOW_PWR;

	if (ctrl->rx1_mode == RF_GAIN_HYBRID_AGC ||
		ctrl->rx2_mode == RF_GAIN_HYBRID_AGC)
		reg |= SLOW_ATTACK_HYBRID_MODE;

	reg |= RX1_GAIN_CTRL_SETUP(ctrl->rx1_mode) |
		RX2_GAIN_CTRL_SETUP(ctrl->rx2_mode);

	phy->agc_mode[0] = ctrl->rx1_mode;
	phy->agc_mode[1] = ctrl->rx2_mode;

	ad9361_spi_write(spi, REG_AGC_CONFIG_1, reg); // Gain Control Mode Select

	/* AGC_USE_FULL_GAIN_TABLE handled in ad9361_load_gt() */
	ad9361_spi_writef(spi, REG_AGC_CONFIG_2, MAN_GAIN_CTRL_RX1,
		ctrl->mgc_rx1_ctrl_inp_en);
	ad9361_spi_writef(spi, REG_AGC_CONFIG_2, MAN_GAIN_CTRL_RX2,
		ctrl->mgc_rx2_ctrl_inp_en);
	ad9361_spi_writef(spi, REG_AGC_CONFIG_2, DIG_GAIN_EN,
		ctrl->dig_gain_en);

	ctrl->adc_ovr_sample_size = clamp_t(uint8_t, ctrl->adc_ovr_sample_size, 1U, 8U);
	reg = ADC_OVERRANGE_SAMPLE_SIZE(ctrl->adc_ovr_sample_size - 1);

	if (has_split_gt && phy->pdata->split_gt &&
		(ctrl->mgc_rx1_ctrl_inp_en || ctrl->mgc_rx2_ctrl_inp_en)) {
		switch (ctrl->mgc_split_table_ctrl_inp_gain_mode) {
		case 1:
			reg &= ~INCDEC_LMT_GAIN;
			break;
		case 2:
			reg |= INCDEC_LMT_GAIN;
			break;
		default:
		case 0:
			reg |= USE_AGC_FOR_LMTLPF_GAIN;
			break;
		}
	}

	ctrl->mgc_inc_gain_step = clamp_t(uint8_t, ctrl->mgc_inc_gain_step, 1U, 8U);
	reg |= MANUAL_INCR_STEP_SIZE(ctrl->mgc_inc_gain_step - 1);
	ad9361_spi_write(spi, REG_AGC_CONFIG_3, reg); // Incr Step Size, ADC Overrange Size

	if (has_split_gt && phy->pdata->split_gt) {
		reg = SIZE_SPLIT_TABLE - 1;
	}
	else {
		reg = SIZE_FULL_TABLE - 1;
	}
	ad9361_spi_write(spi, REG_MAX_LMT_FULL_GAIN, reg); // Max Full/LMT Gain Table Index
	ad9361_spi_write(spi, REG_RX1_MANUAL_LMT_FULL_GAIN, reg); // Rx1 Full/LMT Gain Index
	ad9361_spi_write(spi, REG_RX2_MANUAL_LMT_FULL_GAIN, reg); // Rx2 Full/LMT Gain Index

	ctrl->mgc_dec_gain_step = clamp_t(uint8_t, ctrl->mgc_dec_gain_step, 1U, 8U);
	reg = MANUAL_CTRL_IN_DECR_GAIN_STP_SIZE(ctrl->mgc_dec_gain_step);
	ad9361_spi_write(spi, REG_PEAK_WAIT_TIME, reg); // Decr Step Size, Peak Overload Time

	if (ctrl->dig_gain_en)
		ad9361_spi_write(spi, REG_DIGITAL_GAIN,
		MAXIMUM_DIGITAL_GAIN(ctrl->max_dig_gain) |
		DIG_GAIN_STP_SIZE(ctrl->dig_gain_step_size));

	if (ctrl->adc_large_overload_thresh >= ctrl->adc_small_overload_thresh) {
		ad9361_spi_write(spi, REG_ADC_SMALL_OVERLOAD_THRESH,
			ctrl->adc_small_overload_thresh); // ADC Small Overload Threshold
		ad9361_spi_write(spi, REG_ADC_LARGE_OVERLOAD_THRESH,
			ctrl->adc_large_overload_thresh); // ADC Large Overload Threshold
	}
	else {
		ad9361_spi_write(spi, REG_ADC_SMALL_OVERLOAD_THRESH,
			ctrl->adc_large_overload_thresh); // ADC Small Overload Threshold
		ad9361_spi_write(spi, REG_ADC_LARGE_OVERLOAD_THRESH,
			ctrl->adc_small_overload_thresh); // ADC Large Overload Threshold
	}

	reg = (ctrl->lmt_overload_high_thresh / 16) - 1;
	reg = clamp(reg, 0U, 63U);
	ad9361_spi_write(spi, REG_LARGE_LMT_OVERLOAD_THRESH, reg);
	reg = (ctrl->lmt_overload_low_thresh / 16) - 1;
	reg = clamp(reg, 0U, 63U);
	ad9361_spi_writef(spi, REG_SMALL_LMT_OVERLOAD_THRESH,
		SMALL_LMT_OVERLOAD_THRESH(~0), reg);

	if (has_split_gt && phy->pdata->split_gt) {
		/* REVIST */
		ad9361_spi_write(spi, REG_RX1_MANUAL_LPF_GAIN, 0x58); // Rx1 LPF Gain Index
		ad9361_spi_write(spi, REG_RX2_MANUAL_LPF_GAIN, 0x18); // Rx2 LPF Gain Index
		ad9361_spi_write(spi, REG_FAST_INITIAL_LMT_GAIN_LIMIT, 0x27); // Initial LMT Gain Limit
	}

	ad9361_spi_write(spi, REG_RX1_MANUAL_DIGITALFORCED_GAIN, 0x00); // Rx1 Digital Gain Index
	ad9361_spi_write(spi, REG_RX2_MANUAL_DIGITALFORCED_GAIN, 0x00); // Rx2 Digital Gain Index

	reg = clamp_t(uint8_t, ctrl->low_power_thresh, 0U, 64U) * 2;
	ad9361_spi_write(spi, REG_FAST_LOW_POWER_THRESH, reg); // Low Power Threshold
	ad9361_spi_write(spi, REG_TX_SYMBOL_ATTEN_CONFIG, 0x00); // Tx Symbol Gain Control

	ad9361_spi_writef(spi, REG_DEC_POWER_MEASURE_DURATION_0,
		USE_HB1_OUT_FOR_DEC_PWR_MEAS, 1); // Power Measurement Duration

	ad9361_spi_writef(spi, REG_DEC_POWER_MEASURE_DURATION_0,
		ENABLE_DEC_PWR_MEAS, 1); // Power Measurement Duration

	if (ctrl->rx1_mode == RF_GAIN_FASTATTACK_AGC ||
		ctrl->rx2_mode == RF_GAIN_FASTATTACK_AGC)
		reg = ilog2(ctrl->f_agc_dec_pow_measuremnt_duration / 16);
	else
		reg = ilog2(ctrl->dec_pow_measuremnt_duration / 16);

	ad9361_spi_writef(spi, REG_DEC_POWER_MEASURE_DURATION_0,
		DEC_POWER_MEASUREMENT_DURATION(~0), reg); // Power Measurement Duration

	/* AGC */

	tmp1 = reg = clamp_t(uint8_t, ctrl->agc_inner_thresh_high, 0U, 127U);
	ad9361_spi_writef(spi, REG_AGC_LOCK_LEVEL,
		AGC_LOCK_LEVEL_FAST_AGC_INNER_HIGH_THRESH_SLOW(~0),
		reg);

	tmp2 = reg = clamp_t(uint8_t, ctrl->agc_inner_thresh_low, 0U, 127U);
	reg |= (ctrl->adc_lmt_small_overload_prevent_gain_inc ?
	PREVENT_GAIN_INC : 0);
	ad9361_spi_write(spi, REG_AGC_INNER_LOW_THRESH, reg);

	reg = AGC_OUTER_HIGH_THRESH(tmp1 - ctrl->agc_outer_thresh_high) |
		AGC_OUTER_LOW_THRESH(ctrl->agc_outer_thresh_low - tmp2);
	ad9361_spi_write(spi, REG_OUTER_POWER_THRESHS, reg);

	reg = AGC_OUTER_HIGH_THRESH_EXED_STP_SIZE(ctrl->agc_outer_thresh_high_dec_steps) |
		AGC_OUTER_LOW_THRESH_EXED_STP_SIZE(ctrl->agc_outer_thresh_low_inc_steps);
	ad9361_spi_write(spi, REG_GAIN_STP_2, reg);

	reg = ((ctrl->immed_gain_change_if_large_adc_overload) ?
	IMMED_GAIN_CHANGE_IF_LG_ADC_OVERLOAD : 0) |
										   ((ctrl->immed_gain_change_if_large_lmt_overload) ?
									   IMMED_GAIN_CHANGE_IF_LG_LMT_OVERLOAD : 0) |
																			  AGC_INNER_HIGH_THRESH_EXED_STP_SIZE(ctrl->agc_inner_thresh_high_dec_steps) |
																			  AGC_INNER_LOW_THRESH_EXED_STP_SIZE(ctrl->agc_inner_thresh_low_inc_steps);
	ad9361_spi_write(spi, REG_GAIN_STP1, reg);

	reg = LARGE_ADC_OVERLOAD_EXED_COUNTER(ctrl->adc_large_overload_exceed_counter) |
		SMALL_ADC_OVERLOAD_EXED_COUNTER(ctrl->adc_small_overload_exceed_counter);
	ad9361_spi_write(spi, REG_ADC_OVERLOAD_COUNTERS, reg);

	ad9361_spi_writef(spi, REG_GAIN_STP_CONFIG_2, LARGE_LPF_GAIN_STEP(~0),
		LARGE_LPF_GAIN_STEP(ctrl->adc_large_overload_inc_steps));

	reg = LARGE_LMT_OVERLOAD_EXED_COUNTER(ctrl->lmt_overload_large_exceed_counter) |
		SMALL_LMT_OVERLOAD_EXED_COUNTER(ctrl->lmt_overload_small_exceed_counter);
	ad9361_spi_write(spi, REG_LMT_OVERLOAD_COUNTERS, reg);

	ad9361_spi_writef(spi, REG_GAIN_STP_CONFIG1,
		DEC_STP_SIZE_FOR_LARGE_LMT_OVERLOAD(~0),
		ctrl->lmt_overload_large_inc_steps);

	reg = DIG_SATURATION_EXED_COUNTER(ctrl->dig_saturation_exceed_counter) |
		(ctrl->sync_for_gain_counter_en ?
	ENABLE_SYNC_FOR_GAIN_COUNTER : 0);
	ad9361_spi_write(spi, REG_DIGITAL_SAT_COUNTER, reg);

	/*
	* Fast AGC
	*/

	/* Fast AGC - Low Power */
	ad9361_spi_writef(spi, REG_FAST_CONFIG_1,
		ENABLE_INCR_GAIN,
		ctrl->f_agc_allow_agc_gain_increase);

	ad9361_spi_write(spi, REG_FAST_INCREMENT_TIME,
		ctrl->f_agc_lp_thresh_increment_time);

	reg = ctrl->f_agc_lp_thresh_increment_steps - 1;
	reg = clamp_t(uint32_t, reg, 0U, 7U);
	ad9361_spi_writef(spi, REG_FAST_ENERGY_DETECT_COUNT,
		INCREMENT_GAIN_STP_LPFLMT(~0), reg);

	/* Fast AGC - Lock Level */
	/* Dual use see also agc_inner_thresh_high */
	ad9361_spi_writef(spi, REG_FAST_CONFIG_2_SETTLING_DELAY,
		ENABLE_LMT_GAIN_INC_FOR_LOCK_LEVEL,
		ctrl->f_agc_lock_level_lmt_gain_increase_en);

	reg = ctrl->f_agc_lock_level_gain_increase_upper_limit;
	reg = clamp_t(uint32_t, reg, 0U, 63U);
	ad9361_spi_writef(spi, REG_FAST_AGCLL_UPPER_LIMIT,
		AGCLL_MAX_INCREASE(~0), reg);

	/* Fast AGC - Peak Detectors and Final Settling */
	reg = ctrl->f_agc_lpf_final_settling_steps;
	reg = clamp_t(uint32_t, reg, 0U, 3U);
	ad9361_spi_writef(spi, REG_FAST_ENERGY_LOST_THRESH,
		POST_LOCK_LEVEL_STP_SIZE_FOR_LPF_TABLE_FULL_TABLE(~0),
		reg);

	reg = ctrl->f_agc_lmt_final_settling_steps;
	reg = clamp_t(uint32_t, reg, 0U, 3U);
	ad9361_spi_writef(spi, REG_FAST_STRONGER_SIGNAL_THRESH,
		POST_LOCK_LEVEL_STP_FOR_LMT_TABLE(~0), reg);

	reg = ctrl->f_agc_final_overrange_count;
	reg = clamp_t(uint32_t, reg, 0U, 7U);
	ad9361_spi_writef(spi, REG_FAST_FINAL_OVER_RANGE_AND_OPT_GAIN,
		FINAL_OVER_RANGE_COUNT(~0), reg);

	/* Fast AGC - Final Power Test */
	ad9361_spi_writef(spi, REG_FAST_CONFIG_1,
		ENABLE_GAIN_INC_AFTER_GAIN_LOCK,
		ctrl->f_agc_gain_increase_after_gain_lock_en);

	/* Fast AGC - Unlocking the Gain */
	/* 0 = MAX Gain, 1 = Optimized Gain, 2 = Set Gain */

	reg = ctrl->f_agc_gain_index_type_after_exit_rx_mode;
	ad9361_spi_writef(spi, REG_FAST_CONFIG_1,
		GOTO_SET_GAIN_IF_EXIT_RX_STATE, reg == SET_GAIN);
	ad9361_spi_writef(spi, REG_FAST_CONFIG_1,
		GOTO_OPTIMIZED_GAIN_IF_EXIT_RX_STATE,
		reg == OPTIMIZED_GAIN);

	ad9361_spi_writef(spi, REG_FAST_CONFIG_2_SETTLING_DELAY,
		USE_LAST_LOCK_LEVEL_FOR_SET_GAIN,
		ctrl->f_agc_use_last_lock_level_for_set_gain_en);

	reg = ctrl->f_agc_optimized_gain_offset;
	reg = clamp_t(uint32_t, reg, 0U, 15U);
	ad9361_spi_writef(spi, REG_FAST_FINAL_OVER_RANGE_AND_OPT_GAIN,
		OPTIMIZE_GAIN_OFFSET(~0), reg);

	tmp1 = !ctrl->f_agc_rst_gla_stronger_sig_thresh_exceeded_en ||
		!ctrl->f_agc_rst_gla_engergy_lost_sig_thresh_exceeded_en ||
		!ctrl->f_agc_rst_gla_large_adc_overload_en ||
		!ctrl->f_agc_rst_gla_large_lmt_overload_en ||
		ctrl->f_agc_rst_gla_en_agc_pulled_high_en;

	ad9361_spi_writef(spi, REG_AGC_CONFIG_2,
		AGC_GAIN_UNLOCK_CTRL, tmp1);

	reg = !ctrl->f_agc_rst_gla_stronger_sig_thresh_exceeded_en;
	ad9361_spi_writef(spi, REG_FAST_STRONG_SIGNAL_FREEZE,
		DONT_UNLOCK_GAIN_IF_STRONGER_SIGNAL, reg);

	reg = ctrl->f_agc_rst_gla_stronger_sig_thresh_above_ll;
	reg = clamp_t(uint32_t, reg, 0U, 63U);
	ad9361_spi_writef(spi, REG_FAST_STRONGER_SIGNAL_THRESH,
		STRONGER_SIGNAL_THRESH(~0), reg);

	reg = ctrl->f_agc_rst_gla_engergy_lost_sig_thresh_below_ll;
	reg = clamp_t(uint32_t, reg, 0U, 63U);
	ad9361_spi_writef(spi, REG_FAST_ENERGY_LOST_THRESH,
			  ENERGY_LOST_THRESH(~0),  reg);

	reg = ctrl->f_agc_rst_gla_engergy_lost_goto_optim_gain_en;
	ad9361_spi_writef(spi, REG_FAST_CONFIG_1,
		GOTO_OPT_GAIN_IF_ENERGY_LOST_OR_EN_AGC_HIGH, reg);

	reg = !ctrl->f_agc_rst_gla_engergy_lost_sig_thresh_exceeded_en;
	ad9361_spi_writef(spi, REG_FAST_CONFIG_1,
		DONT_UNLOCK_GAIN_IF_ENERGY_LOST, reg);

	reg = ctrl->f_agc_energy_lost_stronger_sig_gain_lock_exit_cnt;
	reg = clamp_t(uint32_t, reg, 0U, 63U);
	ad9361_spi_writef(spi, REG_FAST_GAIN_LOCK_EXIT_COUNT,
		GAIN_LOCK_EXIT_COUNT(~0), reg);

	reg = !ctrl->f_agc_rst_gla_large_adc_overload_en ||
		!ctrl->f_agc_rst_gla_large_lmt_overload_en;
	ad9361_spi_writef(spi, REG_FAST_CONFIG_1,
		DONT_UNLOCK_GAIN_IF_LG_ADC_OR_LMT_OVRG, reg);

	reg = !ctrl->f_agc_rst_gla_large_adc_overload_en;
	ad9361_spi_writef(spi, REG_FAST_LOW_POWER_THRESH,
		DONT_UNLOCK_GAIN_IF_ADC_OVRG, reg);

	/* 0 = Max Gain, 1 = Set Gain, 2 = Optimized Gain, 3 = No Gain Change */

	if (ctrl->f_agc_rst_gla_en_agc_pulled_high_en) {
		switch (ctrl->f_agc_rst_gla_if_en_agc_pulled_high_mode) {
		case MAX_GAIN:
			ad9361_spi_writef(spi, REG_FAST_CONFIG_2_SETTLING_DELAY,
				GOTO_MAX_GAIN_OR_OPT_GAIN_IF_EN_AGC_HIGH, 1);

			ad9361_spi_writef(spi, REG_FAST_CONFIG_1,
				GOTO_SET_GAIN_IF_EN_AGC_HIGH, 0);

			ad9361_spi_writef(spi, REG_FAST_CONFIG_1,
				GOTO_OPT_GAIN_IF_ENERGY_LOST_OR_EN_AGC_HIGH, 0);
			break;
		case SET_GAIN:
			ad9361_spi_writef(spi, REG_FAST_CONFIG_2_SETTLING_DELAY,
				GOTO_MAX_GAIN_OR_OPT_GAIN_IF_EN_AGC_HIGH, 0);

			ad9361_spi_writef(spi, REG_FAST_CONFIG_1,
				GOTO_SET_GAIN_IF_EN_AGC_HIGH, 1);
			break;
		case OPTIMIZED_GAIN:
			ad9361_spi_writef(spi, REG_FAST_CONFIG_2_SETTLING_DELAY,
				GOTO_MAX_GAIN_OR_OPT_GAIN_IF_EN_AGC_HIGH, 1);

			ad9361_spi_writef(spi, REG_FAST_CONFIG_1,
				GOTO_SET_GAIN_IF_EN_AGC_HIGH, 0);

			ad9361_spi_writef(spi, REG_FAST_CONFIG_1,
				GOTO_OPT_GAIN_IF_ENERGY_LOST_OR_EN_AGC_HIGH, 1);
			break;
		case NO_GAIN_CHANGE:
			ad9361_spi_writef(spi, REG_FAST_CONFIG_1,
				GOTO_SET_GAIN_IF_EN_AGC_HIGH, 0);
			ad9361_spi_writef(spi, REG_FAST_CONFIG_2_SETTLING_DELAY,
				GOTO_MAX_GAIN_OR_OPT_GAIN_IF_EN_AGC_HIGH, 0);
			break;
		}
	}
	else {
		ad9361_spi_writef(spi, REG_FAST_CONFIG_1,
			GOTO_SET_GAIN_IF_EN_AGC_HIGH, 0);
		ad9361_spi_writef(spi, REG_FAST_CONFIG_2_SETTLING_DELAY,
			GOTO_MAX_GAIN_OR_OPT_GAIN_IF_EN_AGC_HIGH, 0);
	}

	reg = ilog2(ctrl->f_agc_power_measurement_duration_in_state5 / 16);
	reg = clamp_t(uint32_t, reg, 0U, 15U);
	ad9361_spi_writef(spi, REG_RX1_MANUAL_LPF_GAIN,
		POWER_MEAS_IN_STATE_5(~0), reg);
	ad9361_spi_writef(spi, REG_RX1_MANUAL_LMT_FULL_GAIN,
		POWER_MEAS_IN_STATE_5_MSB, reg >> 3);

	return ad9361_gc_update(phy);
}

/**
 * Set the Aux DAC.
 * @param phy The AD9361 state structure.
 * @param dac The DAC.
 * @param val_mV The value.
 * @return 0 in case of success, negative error code otherwise.
 */
static int32_t ad9361_auxdac_set(struct ad9361_rf_phy *phy, int32_t dac,
	int32_t val_mV)
{
	struct spi_device *spi = phy->spi;
	uint32_t val, tmp;

	dev_dbg(&phy->spi->dev, "%s DAC%"PRId32" = %"PRId32" mV", __func__, dac, val_mV);

	/* Disable DAC if val == 0, Ignored in ENSM Auto Mode */
	ad9361_spi_writef(spi, REG_AUXDAC_ENABLE_CTRL,
		AUXDAC_MANUAL_BAR(dac), val_mV ? 0 : 1);

	if (val_mV < 306)
		val_mV = 306;

	if (val_mV < 1888) {
		val = ((val_mV - 306) * 1000) / 1404; /* Vref = 1V, Step = 2 */
		tmp = AUXDAC_1_VREF(0);
	}
	else {
		val = ((val_mV - 1761) * 1000) / 1836; /* Vref = 2.5V, Step = 2 */
		tmp = AUXDAC_1_VREF(3);
	}

	val = clamp_t(uint32_t, val, 0, 1023);

	switch (dac) {
	case 1:
		ad9361_spi_write(spi, REG_AUXDAC_1_WORD, val >> 2);
		ad9361_spi_write(spi, REG_AUXDAC_1_CONFIG, AUXDAC_1_WORD_LSB(val) | tmp);
		phy->auxdac1_value = val_mV;
		break;
	case 2:
		ad9361_spi_write(spi, REG_AUXDAC_2_WORD, val >> 2);
		ad9361_spi_write(spi, REG_AUXDAC_2_CONFIG, AUXDAC_2_WORD_LSB(val) | tmp);
		phy->auxdac2_value = val_mV;
		break;
	default:
		return -EINVAL;
	}

	return 0;
}

/**
 * Get the Aux DAC value.
 * @param phy The AD9361 state structure.
 * @param dac The DAC.
 * @return The value in case of success, negative error code otherwise.
 */
int32_t ad9361_auxdac_get(struct ad9361_rf_phy *phy, int32_t dac)
{

	switch (dac) {
	case 1:
		return phy->auxdac1_value;
	case 2:
		return phy->auxdac2_value;
	default:
		return -EINVAL;
	}

	return 0;
}

/**
 * Setup the AuxDAC.
 * @param phy The AD9361 state structure.
 * @param ctrl Pointer to auxdac_control structure.
 * @return 0 in case of success, negative error code otherwise.
 */
static int32_t ad9361_auxdac_setup(struct ad9361_rf_phy *phy,
struct auxdac_control *ctrl)
{
	struct spi_device *spi = phy->spi;
	uint8_t tmp;

	dev_dbg(&phy->spi->dev, "%s", __func__);

	ad9361_auxdac_set(phy, 1, ctrl->dac1_default_value);
	ad9361_auxdac_set(phy, 2, ctrl->dac2_default_value);

	tmp = ~(AUXDAC_AUTO_TX_BAR(ctrl->dac2_in_tx_en << 1 | ctrl->dac1_in_tx_en) |
		AUXDAC_AUTO_RX_BAR(ctrl->dac2_in_rx_en << 1 | ctrl->dac1_in_rx_en) |
		AUXDAC_INIT_BAR(ctrl->dac2_in_alert_en << 1 | ctrl->dac1_in_alert_en));

	ad9361_spi_writef(spi, REG_AUXDAC_ENABLE_CTRL,
		AUXDAC_AUTO_TX_BAR(~0) |
		AUXDAC_AUTO_RX_BAR(~0) |
		AUXDAC_INIT_BAR(~0),
		tmp); /* Auto Control */

	ad9361_spi_writef(spi, REG_EXTERNAL_LNA_CTRL,
		AUXDAC_MANUAL_SELECT, ctrl->auxdac_manual_mode_en);
	ad9361_spi_write(spi, REG_AUXDAC1_RX_DELAY, ctrl->dac1_rx_delay_us);
	ad9361_spi_write(spi, REG_AUXDAC1_TX_DELAY, ctrl->dac1_tx_delay_us);
	ad9361_spi_write(spi, REG_AUXDAC2_RX_DELAY, ctrl->dac2_rx_delay_us);
	ad9361_spi_write(spi, REG_AUXDAC2_TX_DELAY, ctrl->dac2_tx_delay_us);

	return 0;
}

/**
 * Setup the AuxADC.
 * @param phy The AD9361 state structure.
 * @param ctrl The AuxADC settings.
 * @param bbpll_freq The BBPLL frequency [Hz].
 * @return 0 in case of success, negative error code otherwise.
 */
static int32_t ad9361_auxadc_setup(struct ad9361_rf_phy *phy,
struct auxadc_control *ctrl,
	uint32_t bbpll_freq)
{
	struct spi_device *spi = phy->spi;
	uint32_t val;

	dev_dbg(&phy->spi->dev, "%s", __func__);

	val = DIV_ROUND_CLOSEST(ctrl->temp_time_inteval_ms *
		(bbpll_freq / 1000UL), (1 << 29));

	ad9361_spi_write(spi, REG_TEMP_OFFSET, ctrl->offset);
	ad9361_spi_write(spi, REG_START_TEMP_READING, 0x00);
	ad9361_spi_write(spi, REG_TEMP_SENSE2,
		MEASUREMENT_TIME_INTERVAL(val) |
		(ctrl->periodic_temp_measuremnt ?
	TEMP_SENSE_PERIODIC_ENABLE : 0));
	ad9361_spi_write(spi, REG_TEMP_SENSOR_CONFIG,
		TEMP_SENSOR_DECIMATION(
		ilog2(ctrl->temp_sensor_decimation) - 8));
	ad9361_spi_write(spi, REG_AUXADC_CLOCK_DIVIDER,
		bbpll_freq / ctrl->auxadc_clock_rate);
	ad9361_spi_write(spi, REG_AUXADC_CONFIG,
		AUX_ADC_DECIMATION(
		ilog2(ctrl->auxadc_decimation) - 8));

	return 0;
}

/**
 * Get the measured temperature of the device.
 * @param phy The AD9361 state structure.
 * @return The measured temperature of the device.
 */
int32_t ad9361_get_temp(struct ad9361_rf_phy *phy)
{
	uint32_t val;

	ad9361_spi_writef(phy->spi, REG_AUXADC_CONFIG, AUXADC_POWER_DOWN, 1);
	val = ad9361_spi_read(phy->spi, REG_TEMPERATURE);
	ad9361_spi_writef(phy->spi, REG_AUXADC_CONFIG, AUXADC_POWER_DOWN, 0);

	return DIV_ROUND_CLOSEST(val * 1000000, 1140);
}

/**
 * Get the Aux ADC value.
 * @param phy The AD9361 state structure.
 * @return The value in case of success, negative error code otherwise.
 */
int32_t ad9361_get_auxadc(struct ad9361_rf_phy *phy)
{
	uint8_t buf[2];

	ad9361_spi_writef(phy->spi, REG_AUXADC_CONFIG, AUXADC_POWER_DOWN, 1);
	ad9361_spi_readm(phy->spi, REG_AUXADC_LSB, buf, 2);
	ad9361_spi_writef(phy->spi, REG_AUXADC_CONFIG, AUXADC_POWER_DOWN, 0);

	return (buf[1] << 4) | AUXADC_WORD_LSB(buf[0]);
}

/**
 * Setup the Control Output pins.
 * @param phy The AD9361 state structure.
 * @param ctrl The Control Output pins settings.
 * @return 0 in case of success, negative error code otherwise.
 */
static int32_t ad9361_ctrl_outs_setup(struct ad9361_rf_phy *phy,
struct ctrl_outs_control *ctrl)
{
	struct spi_device *spi = phy->spi;

	dev_dbg(&phy->spi->dev, "%s", __func__);

	ad9361_spi_write(spi, REG_CTRL_OUTPUT_POINTER, ctrl->index); // Ctrl Out index
	return ad9361_spi_write(spi, REG_CTRL_OUTPUT_ENABLE, ctrl->en_mask); // Ctrl Out [7:0] output enable
}
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
