daveshah1/RFToolSDR/fpga/projects/rx_tx_gen/rx_tx_gen.srcs/sources_1/ip/iq_sample_fifo/iq_sample_fifo_sim_netlist.v

// Copyright 1986-2016 Xilinx, Inc. All Rights Reserved.
// --------------------------------------------------------------------------------
// Tool Version: Vivado v.2016.3 (lin64) Build 1682563 Mon Oct 10 19:07:26 MDT 2016
// Date        : Sat Apr 15 09:49:57 2017
// Host        : david-desktop-arch running 64-bit unknown
// Command     : write_verilog -force -mode funcsim
//               /home/dave/misc-projects/rftool-fpga/projects/rx_only/rx_only.srcs/sources_1/ip/iq_sample_fifo/iq_sample_fifo_sim_netlist.v
// Design      : iq_sample_fifo
// Purpose     : This verilog netlist is a functional simulation representation of the design and should not be modified
//               or synthesized. This netlist cannot be used for SDF annotated simulation.
// Device      : xc7a50tftg256-2
// --------------------------------------------------------------------------------
`timescale 1 ps / 1 ps

(* CHECK_LICENSE_TYPE = "iq_sample_fifo,fifo_generator_v13_1_2,{}" *) (* downgradeipidentifiedwarnings = "yes" *) (* x_core_info = "fifo_generator_v13_1_2,Vivado 2016.3" *) 
(* NotValidForBitStream *)
module iq_sample_fifo
   (wr_clk,
    rd_clk,
    din,
    wr_en,
    rd_en,
    dout,
    full,
    empty);
  (* x_interface_info = "xilinx.com:signal:clock:1.0 write_clk CLK" *) input wr_clk;
  (* x_interface_info = "xilinx.com:signal:clock:1.0 read_clk CLK" *) input rd_clk;
  (* x_interface_info = "xilinx.com:interface:fifo_write:1.0 FIFO_WRITE WR_DATA" *) input [23:0]din;
  (* x_interface_info = "xilinx.com:interface:fifo_write:1.0 FIFO_WRITE WR_EN" *) input wr_en;
  (* x_interface_info = "xilinx.com:interface:fifo_read:1.0 FIFO_READ RD_EN" *) input rd_en;
  (* x_interface_info = "xilinx.com:interface:fifo_read:1.0 FIFO_READ RD_DATA" *) output [23:0]dout;
  (* x_interface_info = "xilinx.com:interface:fifo_write:1.0 FIFO_WRITE FULL" *) output full;
  (* x_interface_info = "xilinx.com:interface:fifo_read:1.0 FIFO_READ EMPTY" *) output empty;

  wire [23:0]din;
  wire [23:0]dout;
  wire empty;
  wire full;
  wire rd_clk;
  wire rd_en;
  wire wr_clk;
  wire wr_en;
  wire NLW_U0_almost_empty_UNCONNECTED;
  wire NLW_U0_almost_full_UNCONNECTED;
  wire NLW_U0_axi_ar_dbiterr_UNCONNECTED;
  wire NLW_U0_axi_ar_overflow_UNCONNECTED;
  wire NLW_U0_axi_ar_prog_empty_UNCONNECTED;
  wire NLW_U0_axi_ar_prog_full_UNCONNECTED;
  wire NLW_U0_axi_ar_sbiterr_UNCONNECTED;
  wire NLW_U0_axi_ar_underflow_UNCONNECTED;
  wire NLW_U0_axi_aw_dbiterr_UNCONNECTED;
  wire NLW_U0_axi_aw_overflow_UNCONNECTED;
  wire NLW_U0_axi_aw_prog_empty_UNCONNECTED;
  wire NLW_U0_axi_aw_prog_full_UNCONNECTED;
  wire NLW_U0_axi_aw_sbiterr_UNCONNECTED;
  wire NLW_U0_axi_aw_underflow_UNCONNECTED;
  wire NLW_U0_axi_b_dbiterr_UNCONNECTED;
  wire NLW_U0_axi_b_overflow_UNCONNECTED;
  wire NLW_U0_axi_b_prog_empty_UNCONNECTED;
  wire NLW_U0_axi_b_prog_full_UNCONNECTED;
  wire NLW_U0_axi_b_sbiterr_UNCONNECTED;
  wire NLW_U0_axi_b_underflow_UNCONNECTED;
  wire NLW_U0_axi_r_dbiterr_UNCONNECTED;
  wire NLW_U0_axi_r_overflow_UNCONNECTED;
  wire NLW_U0_axi_r_prog_empty_UNCONNECTED;
  wire NLW_U0_axi_r_prog_full_UNCONNECTED;
  wire NLW_U0_axi_r_sbiterr_UNCONNECTED;
  wire NLW_U0_axi_r_underflow_UNCONNECTED;
  wire NLW_U0_axi_w_dbiterr_UNCONNECTED;
  wire NLW_U0_axi_w_overflow_UNCONNECTED;
  wire NLW_U0_axi_w_prog_empty_UNCONNECTED;
  wire NLW_U0_axi_w_prog_full_UNCONNECTED;
  wire NLW_U0_axi_w_sbiterr_UNCONNECTED;
  wire NLW_U0_axi_w_underflow_UNCONNECTED;
  wire NLW_U0_axis_dbiterr_UNCONNECTED;
  wire NLW_U0_axis_overflow_UNCONNECTED;
  wire NLW_U0_axis_prog_empty_UNCONNECTED;
  wire NLW_U0_axis_prog_full_UNCONNECTED;
  wire NLW_U0_axis_sbiterr_UNCONNECTED;
  wire NLW_U0_axis_underflow_UNCONNECTED;
  wire NLW_U0_dbiterr_UNCONNECTED;
  wire NLW_U0_m_axi_arvalid_UNCONNECTED;
  wire NLW_U0_m_axi_awvalid_UNCONNECTED;
  wire NLW_U0_m_axi_bready_UNCONNECTED;
  wire NLW_U0_m_axi_rready_UNCONNECTED;
  wire NLW_U0_m_axi_wlast_UNCONNECTED;
  wire NLW_U0_m_axi_wvalid_UNCONNECTED;
  wire NLW_U0_m_axis_tlast_UNCONNECTED;
  wire NLW_U0_m_axis_tvalid_UNCONNECTED;
  wire NLW_U0_overflow_UNCONNECTED;
  wire NLW_U0_prog_empty_UNCONNECTED;
  wire NLW_U0_prog_full_UNCONNECTED;
  wire NLW_U0_rd_rst_busy_UNCONNECTED;
  wire NLW_U0_s_axi_arready_UNCONNECTED;
  wire NLW_U0_s_axi_awready_UNCONNECTED;
  wire NLW_U0_s_axi_bvalid_UNCONNECTED;
  wire NLW_U0_s_axi_rlast_UNCONNECTED;
  wire NLW_U0_s_axi_rvalid_UNCONNECTED;
  wire NLW_U0_s_axi_wready_UNCONNECTED;
  wire NLW_U0_s_axis_tready_UNCONNECTED;
  wire NLW_U0_sbiterr_UNCONNECTED;
  wire NLW_U0_underflow_UNCONNECTED;
  wire NLW_U0_valid_UNCONNECTED;
  wire NLW_U0_wr_ack_UNCONNECTED;
  wire NLW_U0_wr_rst_busy_UNCONNECTED;
  wire [4:0]NLW_U0_axi_ar_data_count_UNCONNECTED;
  wire [4:0]NLW_U0_axi_ar_rd_data_count_UNCONNECTED;
  wire [4:0]NLW_U0_axi_ar_wr_data_count_UNCONNECTED;
  wire [4:0]NLW_U0_axi_aw_data_count_UNCONNECTED;
  wire [4:0]NLW_U0_axi_aw_rd_data_count_UNCONNECTED;
  wire [4:0]NLW_U0_axi_aw_wr_data_count_UNCONNECTED;
  wire [4:0]NLW_U0_axi_b_data_count_UNCONNECTED;
  wire [4:0]NLW_U0_axi_b_rd_data_count_UNCONNECTED;
  wire [4:0]NLW_U0_axi_b_wr_data_count_UNCONNECTED;
  wire [10:0]NLW_U0_axi_r_data_count_UNCONNECTED;
  wire [10:0]NLW_U0_axi_r_rd_data_count_UNCONNECTED;
  wire [10:0]NLW_U0_axi_r_wr_data_count_UNCONNECTED;
  wire [10:0]NLW_U0_axi_w_data_count_UNCONNECTED;
  wire [10:0]NLW_U0_axi_w_rd_data_count_UNCONNECTED;
  wire [10:0]NLW_U0_axi_w_wr_data_count_UNCONNECTED;
  wire [10:0]NLW_U0_axis_data_count_UNCONNECTED;
  wire [10:0]NLW_U0_axis_rd_data_count_UNCONNECTED;
  wire [10:0]NLW_U0_axis_wr_data_count_UNCONNECTED;
  wire [12:0]NLW_U0_data_count_UNCONNECTED;
  wire [31:0]NLW_U0_m_axi_araddr_UNCONNECTED;
  wire [1:0]NLW_U0_m_axi_arburst_UNCONNECTED;
  wire [3:0]NLW_U0_m_axi_arcache_UNCONNECTED;
  wire [0:0]NLW_U0_m_axi_arid_UNCONNECTED;
  wire [7:0]NLW_U0_m_axi_arlen_UNCONNECTED;
  wire [0:0]NLW_U0_m_axi_arlock_UNCONNECTED;
  wire [2:0]NLW_U0_m_axi_arprot_UNCONNECTED;
  wire [3:0]NLW_U0_m_axi_arqos_UNCONNECTED;
  wire [3:0]NLW_U0_m_axi_arregion_UNCONNECTED;
  wire [2:0]NLW_U0_m_axi_arsize_UNCONNECTED;
  wire [0:0]NLW_U0_m_axi_aruser_UNCONNECTED;
  wire [31:0]NLW_U0_m_axi_awaddr_UNCONNECTED;
  wire [1:0]NLW_U0_m_axi_awburst_UNCONNECTED;
  wire [3:0]NLW_U0_m_axi_awcache_UNCONNECTED;
  wire [0:0]NLW_U0_m_axi_awid_UNCONNECTED;
  wire [7:0]NLW_U0_m_axi_awlen_UNCONNECTED;
  wire [0:0]NLW_U0_m_axi_awlock_UNCONNECTED;
  wire [2:0]NLW_U0_m_axi_awprot_UNCONNECTED;
  wire [3:0]NLW_U0_m_axi_awqos_UNCONNECTED;
  wire [3:0]NLW_U0_m_axi_awregion_UNCONNECTED;
  wire [2:0]NLW_U0_m_axi_awsize_UNCONNECTED;
  wire [0:0]NLW_U0_m_axi_awuser_UNCONNECTED;
  wire [63:0]NLW_U0_m_axi_wdata_UNCONNECTED;
  wire [0:0]NLW_U0_m_axi_wid_UNCONNECTED;
  wire [7:0]NLW_U0_m_axi_wstrb_UNCONNECTED;
  wire [0:0]NLW_U0_m_axi_wuser_UNCONNECTED;
  wire [7:0]NLW_U0_m_axis_tdata_UNCONNECTED;
  wire [0:0]NLW_U0_m_axis_tdest_UNCONNECTED;
  wire [0:0]NLW_U0_m_axis_tid_UNCONNECTED;
  wire [0:0]NLW_U0_m_axis_tkeep_UNCONNECTED;
  wire [0:0]NLW_U0_m_axis_tstrb_UNCONNECTED;
  wire [3:0]NLW_U0_m_axis_tuser_UNCONNECTED;
  wire [12:0]NLW_U0_rd_data_count_UNCONNECTED;
  wire [0:0]NLW_U0_s_axi_bid_UNCONNECTED;
  wire [1:0]NLW_U0_s_axi_bresp_UNCONNECTED;
  wire [0:0]NLW_U0_s_axi_buser_UNCONNECTED;
  wire [63:0]NLW_U0_s_axi_rdata_UNCONNECTED;
  wire [0:0]NLW_U0_s_axi_rid_UNCONNECTED;
  wire [1:0]NLW_U0_s_axi_rresp_UNCONNECTED;
  wire [0:0]NLW_U0_s_axi_ruser_UNCONNECTED;
  wire [12:0]NLW_U0_wr_data_count_UNCONNECTED;

  (* C_ADD_NGC_CONSTRAINT = "0" *) 
  (* C_APPLICATION_TYPE_AXIS = "0" *) 
  (* C_APPLICATION_TYPE_RACH = "0" *) 
  (* C_APPLICATION_TYPE_RDCH = "0" *) 
  (* C_APPLICATION_TYPE_WACH = "0" *) 
  (* C_APPLICATION_TYPE_WDCH = "0" *) 
  (* C_APPLICATION_TYPE_WRCH = "0" *) 
  (* C_AXIS_TDATA_WIDTH = "8" *) 
  (* C_AXIS_TDEST_WIDTH = "1" *) 
  (* C_AXIS_TID_WIDTH = "1" *) 
  (* C_AXIS_TKEEP_WIDTH = "1" *) 
  (* C_AXIS_TSTRB_WIDTH = "1" *) 
  (* C_AXIS_TUSER_WIDTH = "4" *) 
  (* C_AXIS_TYPE = "0" *) 
  (* C_AXI_ADDR_WIDTH = "32" *) 
  (* C_AXI_ARUSER_WIDTH = "1" *) 
  (* C_AXI_AWUSER_WIDTH = "1" *) 
  (* C_AXI_BUSER_WIDTH = "1" *) 
  (* C_AXI_DATA_WIDTH = "64" *) 
  (* C_AXI_ID_WIDTH = "1" *) 
  (* C_AXI_LEN_WIDTH = "8" *) 
  (* C_AXI_LOCK_WIDTH = "1" *) 
  (* C_AXI_RUSER_WIDTH = "1" *) 
  (* C_AXI_TYPE = "1" *) 
  (* C_AXI_WUSER_WIDTH = "1" *) 
  (* C_COMMON_CLOCK = "0" *) 
  (* C_COUNT_TYPE = "0" *) 
  (* C_DATA_COUNT_WIDTH = "13" *) 
  (* C_DEFAULT_VALUE = "BlankString" *) 
  (* C_DIN_WIDTH = "24" *) 
  (* C_DIN_WIDTH_AXIS = "1" *) 
  (* C_DIN_WIDTH_RACH = "32" *) 
  (* C_DIN_WIDTH_RDCH = "64" *) 
  (* C_DIN_WIDTH_WACH = "1" *) 
  (* C_DIN_WIDTH_WDCH = "64" *) 
  (* C_DIN_WIDTH_WRCH = "2" *) 
  (* C_DOUT_RST_VAL = "0" *) 
  (* C_DOUT_WIDTH = "24" *) 
  (* C_ENABLE_RLOCS = "0" *) 
  (* C_ENABLE_RST_SYNC = "1" *) 
  (* C_EN_SAFETY_CKT = "0" *) 
  (* C_ERROR_INJECTION_TYPE = "0" *) 
  (* C_ERROR_INJECTION_TYPE_AXIS = "0" *) 
  (* C_ERROR_INJECTION_TYPE_RACH = "0" *) 
  (* C_ERROR_INJECTION_TYPE_RDCH = "0" *) 
  (* C_ERROR_INJECTION_TYPE_WACH = "0" *) 
  (* C_ERROR_INJECTION_TYPE_WDCH = "0" *) 
  (* C_ERROR_INJECTION_TYPE_WRCH = "0" *) 
  (* C_FAMILY = "artix7" *) 
  (* C_FULL_FLAGS_RST_VAL = "0" *) 
  (* C_HAS_ALMOST_EMPTY = "0" *) 
  (* C_HAS_ALMOST_FULL = "0" *) 
  (* C_HAS_AXIS_TDATA = "1" *) 
  (* C_HAS_AXIS_TDEST = "0" *) 
  (* C_HAS_AXIS_TID = "0" *) 
  (* C_HAS_AXIS_TKEEP = "0" *) 
  (* C_HAS_AXIS_TLAST = "0" *) 
  (* C_HAS_AXIS_TREADY = "1" *) 
  (* C_HAS_AXIS_TSTRB = "0" *) 
  (* C_HAS_AXIS_TUSER = "1" *) 
  (* C_HAS_AXI_ARUSER = "0" *) 
  (* C_HAS_AXI_AWUSER = "0" *) 
  (* C_HAS_AXI_BUSER = "0" *) 
  (* C_HAS_AXI_ID = "0" *) 
  (* C_HAS_AXI_RD_CHANNEL = "1" *) 
  (* C_HAS_AXI_RUSER = "0" *) 
  (* C_HAS_AXI_WR_CHANNEL = "1" *) 
  (* C_HAS_AXI_WUSER = "0" *) 
  (* C_HAS_BACKUP = "0" *) 
  (* C_HAS_DATA_COUNT = "0" *) 
  (* C_HAS_DATA_COUNTS_AXIS = "0" *) 
  (* C_HAS_DATA_COUNTS_RACH = "0" *) 
  (* C_HAS_DATA_COUNTS_RDCH = "0" *) 
  (* C_HAS_DATA_COUNTS_WACH = "0" *) 
  (* C_HAS_DATA_COUNTS_WDCH = "0" *) 
  (* C_HAS_DATA_COUNTS_WRCH = "0" *) 
  (* C_HAS_INT_CLK = "0" *) 
  (* C_HAS_MASTER_CE = "0" *) 
  (* C_HAS_MEMINIT_FILE = "0" *) 
  (* C_HAS_OVERFLOW = "0" *) 
  (* C_HAS_PROG_FLAGS_AXIS = "0" *) 
  (* C_HAS_PROG_FLAGS_RACH = "0" *) 
  (* C_HAS_PROG_FLAGS_RDCH = "0" *) 
  (* C_HAS_PROG_FLAGS_WACH = "0" *) 
  (* C_HAS_PROG_FLAGS_WDCH = "0" *) 
  (* C_HAS_PROG_FLAGS_WRCH = "0" *) 
  (* C_HAS_RD_DATA_COUNT = "0" *) 
  (* C_HAS_RD_RST = "0" *) 
  (* C_HAS_RST = "0" *) 
  (* C_HAS_SLAVE_CE = "0" *) 
  (* C_HAS_SRST = "0" *) 
  (* C_HAS_UNDERFLOW = "0" *) 
  (* C_HAS_VALID = "0" *) 
  (* C_HAS_WR_ACK = "0" *) 
  (* C_HAS_WR_DATA_COUNT = "0" *) 
  (* C_HAS_WR_RST = "0" *) 
  (* C_IMPLEMENTATION_TYPE = "2" *) 
  (* C_IMPLEMENTATION_TYPE_AXIS = "1" *) 
  (* C_IMPLEMENTATION_TYPE_RACH = "1" *) 
  (* C_IMPLEMENTATION_TYPE_RDCH = "1" *) 
  (* C_IMPLEMENTATION_TYPE_WACH = "1" *) 
  (* C_IMPLEMENTATION_TYPE_WDCH = "1" *) 
  (* C_IMPLEMENTATION_TYPE_WRCH = "1" *) 
  (* C_INIT_WR_PNTR_VAL = "0" *) 
  (* C_INTERFACE_TYPE = "0" *) 
  (* C_MEMORY_TYPE = "1" *) 
  (* C_MIF_FILE_NAME = "BlankString" *) 
  (* C_MSGON_VAL = "1" *) 
  (* C_OPTIMIZATION_MODE = "0" *) 
  (* C_OVERFLOW_LOW = "0" *) 
  (* C_POWER_SAVING_MODE = "0" *) 
  (* C_PRELOAD_LATENCY = "1" *) 
  (* C_PRELOAD_REGS = "0" *) 
  (* C_PRIM_FIFO_TYPE = "8kx4" *) 
  (* C_PRIM_FIFO_TYPE_AXIS = "1kx18" *) 
  (* C_PRIM_FIFO_TYPE_RACH = "512x36" *) 
  (* C_PRIM_FIFO_TYPE_RDCH = "1kx36" *) 
  (* C_PRIM_FIFO_TYPE_WACH = "512x36" *) 
  (* C_PRIM_FIFO_TYPE_WDCH = "1kx36" *) 
  (* C_PRIM_FIFO_TYPE_WRCH = "512x36" *) 
  (* C_PROG_EMPTY_THRESH_ASSERT_VAL = "2" *) 
  (* C_PROG_EMPTY_THRESH_ASSERT_VAL_AXIS = "1022" *) 
  (* C_PROG_EMPTY_THRESH_ASSERT_VAL_RACH = "1022" *) 
  (* C_PROG_EMPTY_THRESH_ASSERT_VAL_RDCH = "1022" *) 
  (* C_PROG_EMPTY_THRESH_ASSERT_VAL_WACH = "1022" *) 
  (* C_PROG_EMPTY_THRESH_ASSERT_VAL_WDCH = "1022" *) 
  (* C_PROG_EMPTY_THRESH_ASSERT_VAL_WRCH = "1022" *) 
  (* C_PROG_EMPTY_THRESH_NEGATE_VAL = "3" *) 
  (* C_PROG_EMPTY_TYPE = "0" *) 
  (* C_PROG_EMPTY_TYPE_AXIS = "0" *) 
  (* C_PROG_EMPTY_TYPE_RACH = "0" *) 
  (* C_PROG_EMPTY_TYPE_RDCH = "0" *) 
  (* C_PROG_EMPTY_TYPE_WACH = "0" *) 
  (* C_PROG_EMPTY_TYPE_WDCH = "0" *) 
  (* C_PROG_EMPTY_TYPE_WRCH = "0" *) 
  (* C_PROG_FULL_THRESH_ASSERT_VAL = "8189" *) 
  (* C_PROG_FULL_THRESH_ASSERT_VAL_AXIS = "1023" *) 
  (* C_PROG_FULL_THRESH_ASSERT_VAL_RACH = "1023" *) 
  (* C_PROG_FULL_THRESH_ASSERT_VAL_RDCH = "1023" *) 
  (* C_PROG_FULL_THRESH_ASSERT_VAL_WACH = "1023" *) 
  (* C_PROG_FULL_THRESH_ASSERT_VAL_WDCH = "1023" *) 
  (* C_PROG_FULL_THRESH_ASSERT_VAL_WRCH = "1023" *) 
  (* C_PROG_FULL_THRESH_NEGATE_VAL = "8188" *) 
  (* C_PROG_FULL_TYPE = "0" *) 
  (* C_PROG_FULL_TYPE_AXIS = "0" *) 
  (* C_PROG_FULL_TYPE_RACH = "0" *) 
  (* C_PROG_FULL_TYPE_RDCH = "0" *) 
  (* C_PROG_FULL_TYPE_WACH = "0" *) 
  (* C_PROG_FULL_TYPE_WDCH = "0" *) 
  (* C_PROG_FULL_TYPE_WRCH = "0" *) 
  (* C_RACH_TYPE = "0" *) 
  (* C_RDCH_TYPE = "0" *) 
  (* C_RD_DATA_COUNT_WIDTH = "13" *) 
  (* C_RD_DEPTH = "8192" *) 
  (* C_RD_FREQ = "1" *) 
  (* C_RD_PNTR_WIDTH = "13" *) 
  (* C_REG_SLICE_MODE_AXIS = "0" *) 
  (* C_REG_SLICE_MODE_RACH = "0" *) 
  (* C_REG_SLICE_MODE_RDCH = "0" *) 
  (* C_REG_SLICE_MODE_WACH = "0" *) 
  (* C_REG_SLICE_MODE_WDCH = "0" *) 
  (* C_REG_SLICE_MODE_WRCH = "0" *) 
  (* C_SELECT_XPM = "0" *) 
  (* C_SYNCHRONIZER_STAGE = "2" *) 
  (* C_UNDERFLOW_LOW = "0" *) 
  (* C_USE_COMMON_OVERFLOW = "0" *) 
  (* C_USE_COMMON_UNDERFLOW = "0" *) 
  (* C_USE_DEFAULT_SETTINGS = "0" *) 
  (* C_USE_DOUT_RST = "0" *) 
  (* C_USE_ECC = "0" *) 
  (* C_USE_ECC_AXIS = "0" *) 
  (* C_USE_ECC_RACH = "0" *) 
  (* C_USE_ECC_RDCH = "0" *) 
  (* C_USE_ECC_WACH = "0" *) 
  (* C_USE_ECC_WDCH = "0" *) 
  (* C_USE_ECC_WRCH = "0" *) 
  (* C_USE_EMBEDDED_REG = "0" *) 
  (* C_USE_FIFO16_FLAGS = "0" *) 
  (* C_USE_FWFT_DATA_COUNT = "0" *) 
  (* C_USE_PIPELINE_REG = "0" *) 
  (* C_VALID_LOW = "0" *) 
  (* C_WACH_TYPE = "0" *) 
  (* C_WDCH_TYPE = "0" *) 
  (* C_WRCH_TYPE = "0" *) 
  (* C_WR_ACK_LOW = "0" *) 
  (* C_WR_DATA_COUNT_WIDTH = "13" *) 
  (* C_WR_DEPTH = "8192" *) 
  (* C_WR_DEPTH_AXIS = "1024" *) 
  (* C_WR_DEPTH_RACH = "16" *) 
  (* C_WR_DEPTH_RDCH = "1024" *) 
  (* C_WR_DEPTH_WACH = "16" *) 
  (* C_WR_DEPTH_WDCH = "1024" *) 
  (* C_WR_DEPTH_WRCH = "16" *) 
  (* C_WR_FREQ = "1" *) 
  (* C_WR_PNTR_WIDTH = "13" *) 
  (* C_WR_PNTR_WIDTH_AXIS = "10" *) 
  (* C_WR_PNTR_WIDTH_RACH = "4" *) 
  (* C_WR_PNTR_WIDTH_RDCH = "10" *) 
  (* C_WR_PNTR_WIDTH_WACH = "4" *) 
  (* C_WR_PNTR_WIDTH_WDCH = "10" *) 
  (* C_WR_PNTR_WIDTH_WRCH = "4" *) 
  (* C_WR_RESPONSE_LATENCY = "1" *) 
  iq_sample_fifo_fifo_generator_v13_1_2 U0
       (.almost_empty(NLW_U0_almost_empty_UNCONNECTED),
        .almost_full(NLW_U0_almost_full_UNCONNECTED),
        .axi_ar_data_count(NLW_U0_axi_ar_data_count_UNCONNECTED[4:0]),
        .axi_ar_dbiterr(NLW_U0_axi_ar_dbiterr_UNCONNECTED),
        .axi_ar_injectdbiterr(1'b0),
        .axi_ar_injectsbiterr(1'b0),
        .axi_ar_overflow(NLW_U0_axi_ar_overflow_UNCONNECTED),
        .axi_ar_prog_empty(NLW_U0_axi_ar_prog_empty_UNCONNECTED),
        .axi_ar_prog_empty_thresh({1'b0,1'b0,1'b0,1'b0}),
        .axi_ar_prog_full(NLW_U0_axi_ar_prog_full_UNCONNECTED),
        .axi_ar_prog_full_thresh({1'b0,1'b0,1'b0,1'b0}),
        .axi_ar_rd_data_count(NLW_U0_axi_ar_rd_data_count_UNCONNECTED[4:0]),
        .axi_ar_sbiterr(NLW_U0_axi_ar_sbiterr_UNCONNECTED),
        .axi_ar_underflow(NLW_U0_axi_ar_underflow_UNCONNECTED),
        .axi_ar_wr_data_count(NLW_U0_axi_ar_wr_data_count_UNCONNECTED[4:0]),
        .axi_aw_data_count(NLW_U0_axi_aw_data_count_UNCONNECTED[4:0]),
        .axi_aw_dbiterr(NLW_U0_axi_aw_dbiterr_UNCONNECTED),
        .axi_aw_injectdbiterr(1'b0),
        .axi_aw_injectsbiterr(1'b0),
        .axi_aw_overflow(NLW_U0_axi_aw_overflow_UNCONNECTED),
        .axi_aw_prog_empty(NLW_U0_axi_aw_prog_empty_UNCONNECTED),
        .axi_aw_prog_empty_thresh({1'b0,1'b0,1'b0,1'b0}),
        .axi_aw_prog_full(NLW_U0_axi_aw_prog_full_UNCONNECTED),
        .axi_aw_prog_full_thresh({1'b0,1'b0,1'b0,1'b0}),
        .axi_aw_rd_data_count(NLW_U0_axi_aw_rd_data_count_UNCONNECTED[4:0]),
        .axi_aw_sbiterr(NLW_U0_axi_aw_sbiterr_UNCONNECTED),
        .axi_aw_underflow(NLW_U0_axi_aw_underflow_UNCONNECTED),
        .axi_aw_wr_data_count(NLW_U0_axi_aw_wr_data_count_UNCONNECTED[4:0]),
        .axi_b_data_count(NLW_U0_axi_b_data_count_UNCONNECTED[4:0]),
        .axi_b_dbiterr(NLW_U0_axi_b_dbiterr_UNCONNECTED),
        .axi_b_injectdbiterr(1'b0),
        .axi_b_injectsbiterr(1'b0),
        .axi_b_overflow(NLW_U0_axi_b_overflow_UNCONNECTED),
        .axi_b_prog_empty(NLW_U0_axi_b_prog_empty_UNCONNECTED),
        .axi_b_prog_empty_thresh({1'b0,1'b0,1'b0,1'b0}),
        .axi_b_prog_full(NLW_U0_axi_b_prog_full_UNCONNECTED),
        .axi_b_prog_full_thresh({1'b0,1'b0,1'b0,1'b0}),
        .axi_b_rd_data_count(NLW_U0_axi_b_rd_data_count_UNCONNECTED[4:0]),
        .axi_b_sbiterr(NLW_U0_axi_b_sbiterr_UNCONNECTED),
        .axi_b_underflow(NLW_U0_axi_b_underflow_UNCONNECTED),
        .axi_b_wr_data_count(NLW_U0_axi_b_wr_data_count_UNCONNECTED[4:0]),
        .axi_r_data_count(NLW_U0_axi_r_data_count_UNCONNECTED[10:0]),
        .axi_r_dbiterr(NLW_U0_axi_r_dbiterr_UNCONNECTED),
        .axi_r_injectdbiterr(1'b0),
        .axi_r_injectsbiterr(1'b0),
        .axi_r_overflow(NLW_U0_axi_r_overflow_UNCONNECTED),
        .axi_r_prog_empty(NLW_U0_axi_r_prog_empty_UNCONNECTED),
        .axi_r_prog_empty_thresh({1'b0,1'b0,1'b0,1'b0,1'b0,1'b0,1'b0,1'b0,1'b0,1'b0}),
        .axi_r_prog_full(NLW_U0_axi_r_prog_full_UNCONNECTED),
        .axi_r_prog_full_thresh({1'b0,1'b0,1'b0,1'b0,1'b0,1'b0,1'b0,1'b0,1'b0,1'b0}),
        .axi_r_rd_data_count(NLW_U0_axi_r_rd_data_count_UNCONNECTED[10:0]),
        .axi_r_sbiterr(NLW_U0_axi_r_sbiterr_UNCONNECTED),
        .axi_r_underflow(NLW_U0_axi_r_underflow_UNCONNECTED),
        .axi_r_wr_data_count(NLW_U0_axi_r_wr_data_count_UNCONNECTED[10:0]),
        .axi_w_data_count(NLW_U0_axi_w_data_count_UNCONNECTED[10:0]),
        .axi_w_dbiterr(NLW_U0_axi_w_dbiterr_UNCONNECTED),
        .axi_w_injectdbiterr(1'b0),
        .axi_w_injectsbiterr(1'b0),
        .axi_w_overflow(NLW_U0_axi_w_overflow_UNCONNECTED),
        .axi_w_prog_empty(NLW_U0_axi_w_prog_empty_UNCONNECTED),
        .axi_w_prog_empty_thresh({1'b0,1'b0,1'b0,1'b0,1'b0,1'b0,1'b0,1'b0,1'b0,1'b0}),
        .axi_w_prog_full(NLW_U0_axi_w_prog_full_UNCONNECTED),
        .axi_w_prog_full_thresh({1'b0,1'b0,1'b0,1'b0,1'b0,1'b0,1'b0,1'b0,1'b0,1'b0}),
        .axi_w_rd_data_count(NLW_U0_axi_w_rd_data_count_UNCONNECTED[10:0]),
        .axi_w_sbiterr(NLW_U0_axi_w_sbiterr_UNCONNECTED),
        .axi_w_underflow(NLW_U0_axi_w_underflow_UNCONNECTED),
        .axi_w_wr_data_count(NLW_U0_axi_w_wr_data_count_UNCONNECTED[10:0]),
        .axis_data_count(NLW_U0_axis_data_count_UNCONNECTED[10:0]),
        .axis_dbiterr(NLW_U0_axis_dbiterr_UNCONNECTED),
        .axis_injectdbiterr(1'b0),
        .axis_injectsbiterr(1'b0),
        .axis_overflow(NLW_U0_axis_overflow_UNCONNECTED),
        .axis_prog_empty(NLW_U0_axis_prog_empty_UNCONNECTED),
        .axis_prog_empty_thresh({1'b0,1'b0,1'b0,1'b0,1'b0,1'b0,1'b0,1'b0,1'b0,1'b0}),
        .axis_prog_full(NLW_U0_axis_prog_full_UNCONNECTED),
        .axis_prog_full_thresh({1'b0,1'b0,1'b0,1'b0,1'b0,1'b0,1'b0,1'b0,1'b0,1'b0}),
        .axis_rd_data_count(NLW_U0_axis_rd_data_count_UNCONNECTED[10:0]),
        .axis_sbiterr(NLW_U0_axis_sbiterr_UNCONNECTED),
        .axis_underflow(NLW_U0_axis_underflow_UNCONNECTED),
        .axis_wr_data_count(NLW_U0_axis_wr_data_count_UNCONNECTED[10:0]),
        .backup(1'b0),
        .backup_marker(1'b0),
        .clk(1'b0),
        .data_count(NLW_U0_data_count_UNCONNECTED[12:0]),
        .dbiterr(NLW_U0_dbiterr_UNCONNECTED),
        .din(din),
        .dout(dout),
        .empty(empty),
        .full(full),
        .injectdbiterr(1'b0),
        .injectsbiterr(1'b0),
        .int_clk(1'b0),
        .m_aclk(1'b0),
        .m_aclk_en(1'b0),
        .m_axi_araddr(NLW_U0_m_axi_araddr_UNCONNECTED[31:0]),
        .m_axi_arburst(NLW_U0_m_axi_arburst_UNCONNECTED[1:0]),
        .m_axi_arcache(NLW_U0_m_axi_arcache_UNCONNECTED[3:0]),
        .m_axi_arid(NLW_U0_m_axi_arid_UNCONNECTED[0]),
        .m_axi_arlen(NLW_U0_m_axi_arlen_UNCONNECTED[7:0]),
        .m_axi_arlock(NLW_U0_m_axi_arlock_UNCONNECTED[0]),
        .m_axi_arprot(NLW_U0_m_axi_arprot_UNCONNECTED[2:0]),
        .m_axi_arqos(NLW_U0_m_axi_arqos_UNCONNECTED[3:0]),
        .m_axi_arready(1'b0),
        .m_axi_arregion(NLW_U0_m_axi_arregion_UNCONNECTED[3:0]),
        .m_axi_arsize(NLW_U0_m_axi_arsize_UNCONNECTED[2:0]),
        .m_axi_aruser(NLW_U0_m_axi_aruser_UNCONNECTED[0]),
        .m_axi_arvalid(NLW_U0_m_axi_arvalid_UNCONNECTED),
        .m_axi_awaddr(NLW_U0_m_axi_awaddr_UNCONNECTED[31:0]),
        .m_axi_awburst(NLW_U0_m_axi_awburst_UNCONNECTED[1:0]),
        .m_axi_awcache(NLW_U0_m_axi_awcache_UNCONNECTED[3:0]),
        .m_axi_awid(NLW_U0_m_axi_awid_UNCONNECTED[0]),
        .m_axi_awlen(NLW_U0_m_axi_awlen_UNCONNECTED[7:0]),
        .m_axi_awlock(NLW_U0_m_axi_awlock_UNCONNECTED[0]),
        .m_axi_awprot(NLW_U0_m_axi_awprot_UNCONNECTED[2:0]),
        .m_axi_awqos(NLW_U0_m_axi_awqos_UNCONNECTED[3:0]),
        .m_axi_awready(1'b0),
        .m_axi_awregion(NLW_U0_m_axi_awregion_UNCONNECTED[3:0]),
        .m_axi_awsize(NLW_U0_m_axi_awsize_UNCONNECTED[2:0]),
        .m_axi_awuser(NLW_U0_m_axi_awuser_UNCONNECTED[0]),
        .m_axi_awvalid(NLW_U0_m_axi_awvalid_UNCONNECTED),
        .m_axi_bid(1'b0),
        .m_axi_bready(NLW_U0_m_axi_bready_UNCONNECTED),
        .m_axi_bresp({1'b0,1'b0}),
        .m_axi_buser(1'b0),
        .m_axi_bvalid(1'b0),
        .m_axi_rdata({1'b0,1'b0,1'b0,1'b0,1'b0,1'b0,1'b0,1'b0,1'b0,1'b0,1'b0,1'b0,1'b0,1'b0,1'b0,1'b0,1'b0,1'b0,1'b0,1'b0,1'b0,1'b0,1'b0,1'b0,1'b0,1'b0,1'b0,1'b0,1'b0,1'b0,1'b0,1'b0,1'b0,1'b0,1'b0,1'b0,1'b0,1'b0,1'b0,1'b0,1'b0,1'b0,1'b0,1'b0,1'b0,1'b0,1'b0,1'b0,1'b0,1'b0,1'b0,1'b0,1'b0,1'b0,1'b0,1'b0,1'b0,1'b0,1'b0,1'b0,1'b0,1'b0,1'b0,1'b0}),
        .m_axi_rid(1'b0),
        .m_axi_rlast(1'b0),
        .m_axi_rready(NLW_U0_m_axi_rready_UNCONNECTED),
        .m_axi_rresp({1'b0,1'b0}),
        .m_axi_ruser(1'b0),
        .m_axi_rvalid(1'b0),
        .m_axi_wdata(NLW_U0_m_axi_wdata_UNCONNECTED[63:0]),
        .m_axi_wid(NLW_U0_m_axi_wid_UNCONNECTED[0]),
        .m_axi_wlast(NLW_U0_m_axi_wlast_UNCONNECTED),
        .m_axi_wready(1'b0),
        .m_axi_wstrb(NLW_U0_m_axi_wstrb_UNCONNECTED[7:0]),
        .m_axi_wuser(NLW_U0_m_axi_wuser_UNCONNECTED[0]),
        .m_axi_wvalid(NLW_U0_m_axi_wvalid_UNCONNECTED),
        .m_axis_tdata(NLW_U0_m_axis_tdata_UNCONNECTED[7:0]),
        .m_axis_tdest(NLW_U0_m_axis_tdest_UNCONNECTED[0]),
        .m_axis_tid(NLW_U0_m_axis_tid_UNCONNECTED[0]),
        .m_axis_tkeep(NLW_U0_m_axis_tkeep_UNCONNECTED[0]),
        .m_axis_tlast(NLW_U0_m_axis_tlast_UNCONNECTED),
        .m_axis_tready(1'b0),
        .m_axis_tstrb(NLW_U0_m_axis_tstrb_UNCONNECTED[0]),
        .m_axis_tuser(NLW_U0_m_axis_tuser_UNCONNECTED[3:0]),
        .m_axis_tvalid(NLW_U0_m_axis_tvalid_UNCONNECTED),
        .overflow(NLW_U0_overflow_UNCONNECTED),
        .prog_empty(NLW_U0_prog_empty_UNCONNECTED),
        .prog_empty_thresh({1'b0,1'b0,1'b0,1'b0,1'b0,1'b0,1'b0,1'b0,1'b0,1'b0,1'b0,1'b0,1'b0}),
        .prog_empty_thresh_assert({1'b0,1'b0,1'b0,1'b0,1'b0,1'b0,1'b0,1'b0,1'b0,1'b0,1'b0,1'b0,1'b0}),
        .prog_empty_thresh_negate({1'b0,1'b0,1'b0,1'b0,1'b0,1'b0,1'b0,1'b0,1'b0,1'b0,1'b0,1'b0,1'b0}),
        .prog_full(NLW_U0_prog_full_UNCONNECTED),
        .prog_full_thresh({1'b0,1'b0,1'b0,1'b0,1'b0,1'b0,1'b0,1'b0,1'b0,1'b0,1'b0,1'b0,1'b0}),
        .prog_full_thresh_assert({1'b0,1'b0,1'b0,1'b0,1'b0,1'b0,1'b0,1'b0,1'b0,1'b0,1'b0,1'b0,1'b0}),
        .prog_full_thresh_negate({1'b0,1'b0,1'b0,1'b0,1'b0,1'b0,1'b0,1'b0,1'b0,1'b0,1'b0,1'b0,1'b0}),
        .rd_clk(rd_clk),
        .rd_data_count(NLW_U0_rd_data_count_UNCONNECTED[12:0]),
        .rd_en(rd_en),
        .rd_rst(1'b0),
        .rd_rst_busy(NLW_U0_rd_rst_busy_UNCONNECTED),
        .rst(1'b0),
        .s_aclk(1'b0),
        .s_aclk_en(1'b0),
        .s_aresetn(1'b0),
        .s_axi_araddr({1'b0,1'b0,1'b0,1'b0,1'b0,1'b0,1'b0,1'b0,1'b0,1'b0,1'b0,1'b0,1'b0,1'b0,1'b0,1'b0,1'b0,1'b0,1'b0,1'b0,1'b0,1'b0,1'b0,1'b0,1'b0,1'b0,1'b0,1'b0,1'b0,1'b0,1'b0,1'b0}),
        .s_axi_arburst({1'b0,1'b0}),
        .s_axi_arcache({1'b0,1'b0,1'b0,1'b0}),
        .s_axi_arid(1'b0),
        .s_axi_arlen({1'b0,1'b0,1'b0,1'b0,1'b0,1'b0,1'b0,1'b0}),
        .s_axi_arlock(1'b0),
        .s_axi_arprot({1'b0,1'b0,1'b0}),
        .s_axi_arqos({1'b0,1'b0,1'b0,1'b0}),
        .s_axi_arready(NLW_U0_s_axi_arready_UNCONNECTED),
        .s_axi_arregion({1'b0,1'b0,1'b0,1'b0}),
        .s_axi_arsize({1'b0,1'b0,1'b0}),
        .s_axi_aruser(1'b0),
        .s_axi_arvalid(1'b0),
        .s_axi_awaddr({1'b0,1'b0,1'b0,1'b0,1'b0,1'b0,1'b0,1'b0,1'b0,1'b0,1'b0,1'b0,1'b0,1'b0,1'b0,1'b0,1'b0,1'b0,1'b0,1'b0,1'b0,1'b0,1'b0,1'b0,1'b0,1'b0,1'b0,1'b0,1'b0,1'b0,1'b0,1'b0}),
        .s_axi_awburst({1'b0,1'b0}),
        .s_axi_awcache({1'b0,1'b0,1'b0,1'b0}),
        .s_axi_awid(1'b0),
        .s_axi_awlen({1'b0,1'b0,1'b0,1'b0,1'b0,1'b0,1'b0,1'b0}),
        .s_axi_awlock(1'b0),
        .s_axi_awprot({1'b0,1'b0,1'b0}),
        .s_axi_awqos({1'b0,1'b0,1'b0,1'b0}),
        .s_axi_awready(NLW_U0_s_axi_awready_UNCONNECTED),
        .s_axi_awregion({1'b0,1'b0,1'b0,1'b0}),
        .s_axi_awsize({1'b0,1'b0,1'b0}),
        .s_axi_awuser(1'b0),
        .s_axi_awvalid(1'b0),
        .s_axi_bid(NLW_U0_s_axi_bid_UNCONNECTED[0]),
        .s_axi_bready(1'b0),
        .s_axi_bresp(NLW_U0_s_axi_bresp_UNCONNECTED[1:0]),
        .s_axi_buser(NLW_U0_s_axi_buser_UNCONNECTED[0]),
        .s_axi_bvalid(NLW_U0_s_axi_bvalid_UNCONNECTED),
        .s_axi_rdata(NLW_U0_s_axi_rdata_UNCONNECTED[63:0]),
        .s_axi_rid(NLW_U0_s_axi_rid_UNCONNECTED[0]),
        .s_axi_rlast(NLW_U0_s_axi_rlast_UNCONNECTED),
        .s_axi_rready(1'b0),
        .s_axi_rresp(NLW_U0_s_axi_rresp_UNCONNECTED[1:0]),
        .s_axi_ruser(NLW_U0_s_axi_ruser_UNCONNECTED[0]),
        .s_axi_rvalid(NLW_U0_s_axi_rvalid_UNCONNECTED),
        .s_axi_wdata({1'b0,1'b0,1'b0,1'b0,1'b0,1'b0,1'b0,1'b0,1'b0,1'b0,1'b0,1'b0,1'b0,1'b0,1'b0,1'b0,1'b0,1'b0,1'b0,1'b0,1'b0,1'b0,1'b0,1'b0,1'b0,1'b0,1'b0,1'b0,1'b0,1'b0,1'b0,1'b0,1'b0,1'b0,1'b0,1'b0,1'b0,1'b0,1'b0,1'b0,1'b0,1'b0,1'b0,1'b0,1'b0,1'b0,1'b0,1'b0,1'b0,1'b0,1'b0,1'b0,1'b0,1'b0,1'b0,1'b0,1'b0,1'b0,1'b0,1'b0,1'b0,1'b0,1'b0,1'b0}),
        .s_axi_wid(1'b0),
        .s_axi_wlast(1'b0),
        .s_axi_wready(NLW_U0_s_axi_wready_UNCONNECTED),
        .s_axi_wstrb({1'b0,1'b0,1'b0,1'b0,1'b0,1'b0,1'b0,1'b0}),
        .s_axi_wuser(1'b0),
        .s_axi_wvalid(1'b0),
        .s_axis_tdata({1'b0,1'b0,1'b0,1'b0,1'b0,1'b0,1'b0,1'b0}),
        .s_axis_tdest(1'b0),
        .s_axis_tid(1'b0),
        .s_axis_tkeep(1'b0),
        .s_axis_tlast(1'b0),
        .s_axis_tready(NLW_U0_s_axis_tready_UNCONNECTED),
        .s_axis_tstrb(1'b0),
        .s_axis_tuser({1'b0,1'b0,1'b0,1'b0}),
        .s_axis_tvalid(1'b0),
        .sbiterr(NLW_U0_sbiterr_UNCONNECTED),
        .sleep(1'b0),
        .srst(1'b0),
        .underflow(NLW_U0_underflow_UNCONNECTED),
        .valid(NLW_U0_valid_UNCONNECTED),
        .wr_ack(NLW_U0_wr_ack_UNCONNECTED),
        .wr_clk(wr_clk),
        .wr_data_count(NLW_U0_wr_data_count_UNCONNECTED[12:0]),
        .wr_en(wr_en),
        .wr_rst(1'b0),
        .wr_rst_busy(NLW_U0_wr_rst_busy_UNCONNECTED));
endmodule

(* ORIG_REF_NAME = "blk_mem_gen_generic_cstr" *) 
module iq_sample_fifo_blk_mem_gen_generic_cstr
   (dout,
    \no_softecc_sel_reg.ce_pri.sel_pipe_reg[0] ,
    wr_clk,
    rd_clk,
    ram_full_fb_i_reg,
    ram_empty_fb_i_reg,
    Q,
    \gc0.count_d1_reg[12] ,
    din,
    WEA,
    ram_full_fb_i_reg_0,
    ram_empty_fb_i_reg_0,
    ena_array,
    enb_array,
    \gc0.count_d1_reg[12]_0 );
  output [23:0]dout;
  output \no_softecc_sel_reg.ce_pri.sel_pipe_reg[0] ;
  input wr_clk;
  input rd_clk;
  input ram_full_fb_i_reg;
  input ram_empty_fb_i_reg;
  input [12:0]Q;
  input [12:0]\gc0.count_d1_reg[12] ;
  input [23:0]din;
  input [0:0]WEA;
  input ram_full_fb_i_reg_0;
  input ram_empty_fb_i_reg_0;
  input [0:0]ena_array;
  input [0:0]enb_array;
  input \gc0.count_d1_reg[12]_0 ;

  wire [12:0]Q;
  wire [0:0]WEA;
  wire [23:0]din;
  wire [23:0]dout;
  wire [0:0]ena_array;
  wire [0:0]enb_array;
  wire [12:0]\gc0.count_d1_reg[12] ;
  wire \gc0.count_d1_reg[12]_0 ;
  wire \no_softecc_sel_reg.ce_pri.sel_pipe_reg[0] ;
  wire ram_empty_fb_i_reg;
  wire ram_empty_fb_i_reg_0;
  wire ram_full_fb_i_reg;
  wire ram_full_fb_i_reg_0;
  wire \ramloop[2].ram.r_n_0 ;
  wire \ramloop[2].ram.r_n_1 ;
  wire \ramloop[2].ram.r_n_2 ;
  wire \ramloop[2].ram.r_n_3 ;
  wire \ramloop[2].ram.r_n_4 ;
  wire \ramloop[2].ram.r_n_5 ;
  wire \ramloop[2].ram.r_n_6 ;
  wire \ramloop[2].ram.r_n_7 ;
  wire \ramloop[2].ram.r_n_8 ;
  wire \ramloop[3].ram.r_n_0 ;
  wire \ramloop[3].ram.r_n_1 ;
  wire \ramloop[3].ram.r_n_2 ;
  wire \ramloop[3].ram.r_n_3 ;
  wire \ramloop[3].ram.r_n_4 ;
  wire \ramloop[3].ram.r_n_5 ;
  wire \ramloop[3].ram.r_n_6 ;
  wire \ramloop[3].ram.r_n_7 ;
  wire \ramloop[3].ram.r_n_8 ;
  wire \ramloop[4].ram.r_n_0 ;
  wire \ramloop[4].ram.r_n_1 ;
  wire \ramloop[4].ram.r_n_2 ;
  wire \ramloop[4].ram.r_n_3 ;
  wire \ramloop[4].ram.r_n_4 ;
  wire \ramloop[4].ram.r_n_5 ;
  wire \ramloop[4].ram.r_n_6 ;
  wire \ramloop[4].ram.r_n_7 ;
  wire \ramloop[4].ram.r_n_8 ;
  wire \ramloop[5].ram.r_n_0 ;
  wire \ramloop[5].ram.r_n_1 ;
  wire \ramloop[5].ram.r_n_2 ;
  wire \ramloop[5].ram.r_n_3 ;
  wire \ramloop[5].ram.r_n_4 ;
  wire \ramloop[5].ram.r_n_5 ;
  wire \ramloop[5].ram.r_n_6 ;
  wire \ramloop[5].ram.r_n_7 ;
  wire \ramloop[5].ram.r_n_8 ;
  wire rd_clk;
  wire wr_clk;

  iq_sample_fifo_blk_mem_gen_mux__parameterized0 \has_mux_b.B 
       (.\DEVICE_7SERIES.NO_BMM_INFO.SDP.SIMPLE_PRIM36.ram ({\ramloop[2].ram.r_n_0 ,\ramloop[2].ram.r_n_1 ,\ramloop[2].ram.r_n_2 ,\ramloop[2].ram.r_n_3 ,\ramloop[2].ram.r_n_4 ,\ramloop[2].ram.r_n_5 ,\ramloop[2].ram.r_n_6 ,\ramloop[2].ram.r_n_7 }),
        .\DEVICE_7SERIES.NO_BMM_INFO.SDP.SIMPLE_PRIM36.ram_0 (\ramloop[2].ram.r_n_8 ),
        .\DEVICE_7SERIES.NO_BMM_INFO.SDP.SIMPLE_PRIM36.ram_1 ({\ramloop[5].ram.r_n_0 ,\ramloop[5].ram.r_n_1 ,\ramloop[5].ram.r_n_2 ,\ramloop[5].ram.r_n_3 ,\ramloop[5].ram.r_n_4 ,\ramloop[5].ram.r_n_5 ,\ramloop[5].ram.r_n_6 ,\ramloop[5].ram.r_n_7 }),
        .\DEVICE_7SERIES.NO_BMM_INFO.SDP.SIMPLE_PRIM36.ram_2 ({\ramloop[4].ram.r_n_0 ,\ramloop[4].ram.r_n_1 ,\ramloop[4].ram.r_n_2 ,\ramloop[4].ram.r_n_3 ,\ramloop[4].ram.r_n_4 ,\ramloop[4].ram.r_n_5 ,\ramloop[4].ram.r_n_6 ,\ramloop[4].ram.r_n_7 }),
        .\DEVICE_7SERIES.NO_BMM_INFO.SDP.SIMPLE_PRIM36.ram_3 (\ramloop[5].ram.r_n_8 ),
        .\DEVICE_7SERIES.NO_BMM_INFO.SDP.SIMPLE_PRIM36.ram_4 (\ramloop[4].ram.r_n_8 ),
        .DOBDO({\ramloop[3].ram.r_n_0 ,\ramloop[3].ram.r_n_1 ,\ramloop[3].ram.r_n_2 ,\ramloop[3].ram.r_n_3 ,\ramloop[3].ram.r_n_4 ,\ramloop[3].ram.r_n_5 ,\ramloop[3].ram.r_n_6 ,\ramloop[3].ram.r_n_7 }),
        .DOPBDOP(\ramloop[3].ram.r_n_8 ),
        .dout(dout[23:6]),
        .\gc0.count_d1_reg[12] (\gc0.count_d1_reg[12]_0 ),
        .\no_softecc_sel_reg.ce_pri.sel_pipe_reg[0]_0 (\no_softecc_sel_reg.ce_pri.sel_pipe_reg[0] ),
        .rd_clk(rd_clk));
  iq_sample_fifo_blk_mem_gen_prim_width \ramloop[0].ram.r 
       (.Q(Q),
        .WEA(WEA),
        .din(din[1:0]),
        .dout(dout[1:0]),
        .\gc0.count_d1_reg[12] (\gc0.count_d1_reg[12] ),
        .ram_empty_fb_i_reg(ram_empty_fb_i_reg),
        .ram_full_fb_i_reg(ram_full_fb_i_reg),
        .rd_clk(rd_clk),
        .wr_clk(wr_clk));
  iq_sample_fifo_blk_mem_gen_prim_width__parameterized0 \ramloop[1].ram.r 
       (.Q(Q),
        .WEA(WEA),
        .din(din[5:2]),
        .dout(dout[5:2]),
        .\gc0.count_d1_reg[12] (\gc0.count_d1_reg[12] ),
        .ram_empty_fb_i_reg(ram_empty_fb_i_reg),
        .ram_full_fb_i_reg(ram_full_fb_i_reg),
        .rd_clk(rd_clk),
        .wr_clk(wr_clk));
  iq_sample_fifo_blk_mem_gen_prim_width__parameterized1 \ramloop[2].ram.r 
       (.Q(Q[11:0]),
        .WEA(WEA),
        .din(din[14:6]),
        .\dout[13] ({\ramloop[2].ram.r_n_0 ,\ramloop[2].ram.r_n_1 ,\ramloop[2].ram.r_n_2 ,\ramloop[2].ram.r_n_3 ,\ramloop[2].ram.r_n_4 ,\ramloop[2].ram.r_n_5 ,\ramloop[2].ram.r_n_6 ,\ramloop[2].ram.r_n_7 }),
        .\dout[14] (\ramloop[2].ram.r_n_8 ),
        .\gc0.count_d1_reg[11] (\gc0.count_d1_reg[12] [11:0]),
        .ram_empty_fb_i_reg(ram_empty_fb_i_reg_0),
        .ram_full_fb_i_reg(ram_full_fb_i_reg_0),
        .rd_clk(rd_clk),
        .wr_clk(wr_clk));
  iq_sample_fifo_blk_mem_gen_prim_width__parameterized2 \ramloop[3].ram.r 
       (.DOBDO({\ramloop[3].ram.r_n_0 ,\ramloop[3].ram.r_n_1 ,\ramloop[3].ram.r_n_2 ,\ramloop[3].ram.r_n_3 ,\ramloop[3].ram.r_n_4 ,\ramloop[3].ram.r_n_5 ,\ramloop[3].ram.r_n_6 ,\ramloop[3].ram.r_n_7 }),
        .DOPBDOP(\ramloop[3].ram.r_n_8 ),
        .Q(Q[11:0]),
        .WEA(WEA),
        .din(din[14:6]),
        .ena_array(ena_array),
        .enb_array(enb_array),
        .\gc0.count_d1_reg[11] (\gc0.count_d1_reg[12] [11:0]),
        .rd_clk(rd_clk),
        .wr_clk(wr_clk));
  iq_sample_fifo_blk_mem_gen_prim_width__parameterized3 \ramloop[4].ram.r 
       (.Q(Q[11:0]),
        .WEA(WEA),
        .din(din[23:15]),
        .\dout[22] ({\ramloop[4].ram.r_n_0 ,\ramloop[4].ram.r_n_1 ,\ramloop[4].ram.r_n_2 ,\ramloop[4].ram.r_n_3 ,\ramloop[4].ram.r_n_4 ,\ramloop[4].ram.r_n_5 ,\ramloop[4].ram.r_n_6 ,\ramloop[4].ram.r_n_7 }),
        .\dout[23] (\ramloop[4].ram.r_n_8 ),
        .\gc0.count_d1_reg[11] (\gc0.count_d1_reg[12] [11:0]),
        .ram_empty_fb_i_reg(ram_empty_fb_i_reg_0),
        .ram_full_fb_i_reg(ram_full_fb_i_reg_0),
        .rd_clk(rd_clk),
        .wr_clk(wr_clk));
  iq_sample_fifo_blk_mem_gen_prim_width__parameterized4 \ramloop[5].ram.r 
       (.Q(Q[11:0]),
        .WEA(WEA),
        .din(din[23:15]),
        .\dout[22] ({\ramloop[5].ram.r_n_0 ,\ramloop[5].ram.r_n_1 ,\ramloop[5].ram.r_n_2 ,\ramloop[5].ram.r_n_3 ,\ramloop[5].ram.r_n_4 ,\ramloop[5].ram.r_n_5 ,\ramloop[5].ram.r_n_6 ,\ramloop[5].ram.r_n_7 }),
        .\dout[23] (\ramloop[5].ram.r_n_8 ),
        .ena_array(ena_array),
        .enb_array(enb_array),
        .\gc0.count_d1_reg[11] (\gc0.count_d1_reg[12] [11:0]),
        .rd_clk(rd_clk),
        .wr_clk(wr_clk));
endmodule

(* ORIG_REF_NAME = "blk_mem_gen_mux" *) 
module iq_sample_fifo_blk_mem_gen_mux__parameterized0
   (\no_softecc_sel_reg.ce_pri.sel_pipe_reg[0]_0 ,
    dout,
    \gc0.count_d1_reg[12] ,
    rd_clk,
    DOBDO,
    \DEVICE_7SERIES.NO_BMM_INFO.SDP.SIMPLE_PRIM36.ram ,
    DOPBDOP,
    \DEVICE_7SERIES.NO_BMM_INFO.SDP.SIMPLE_PRIM36.ram_0 ,
    \DEVICE_7SERIES.NO_BMM_INFO.SDP.SIMPLE_PRIM36.ram_1 ,
    \DEVICE_7SERIES.NO_BMM_INFO.SDP.SIMPLE_PRIM36.ram_2 ,
    \DEVICE_7SERIES.NO_BMM_INFO.SDP.SIMPLE_PRIM36.ram_3 ,
    \DEVICE_7SERIES.NO_BMM_INFO.SDP.SIMPLE_PRIM36.ram_4 );
  output \no_softecc_sel_reg.ce_pri.sel_pipe_reg[0]_0 ;
  output [17:0]dout;
  input \gc0.count_d1_reg[12] ;
  input rd_clk;
  input [7:0]DOBDO;
  input [7:0]\DEVICE_7SERIES.NO_BMM_INFO.SDP.SIMPLE_PRIM36.ram ;
  input [0:0]DOPBDOP;
  input [0:0]\DEVICE_7SERIES.NO_BMM_INFO.SDP.SIMPLE_PRIM36.ram_0 ;
  input [7:0]\DEVICE_7SERIES.NO_BMM_INFO.SDP.SIMPLE_PRIM36.ram_1 ;
  input [7:0]\DEVICE_7SERIES.NO_BMM_INFO.SDP.SIMPLE_PRIM36.ram_2 ;
  input [0:0]\DEVICE_7SERIES.NO_BMM_INFO.SDP.SIMPLE_PRIM36.ram_3 ;
  input [0:0]\DEVICE_7SERIES.NO_BMM_INFO.SDP.SIMPLE_PRIM36.ram_4 ;

  wire [7:0]\DEVICE_7SERIES.NO_BMM_INFO.SDP.SIMPLE_PRIM36.ram ;
  wire [0:0]\DEVICE_7SERIES.NO_BMM_INFO.SDP.SIMPLE_PRIM36.ram_0 ;
  wire [7:0]\DEVICE_7SERIES.NO_BMM_INFO.SDP.SIMPLE_PRIM36.ram_1 ;
  wire [7:0]\DEVICE_7SERIES.NO_BMM_INFO.SDP.SIMPLE_PRIM36.ram_2 ;
  wire [0:0]\DEVICE_7SERIES.NO_BMM_INFO.SDP.SIMPLE_PRIM36.ram_3 ;
  wire [0:0]\DEVICE_7SERIES.NO_BMM_INFO.SDP.SIMPLE_PRIM36.ram_4 ;
  wire [7:0]DOBDO;
  wire [0:0]DOPBDOP;
  wire [17:0]dout;
  wire \gc0.count_d1_reg[12] ;
  wire \no_softecc_sel_reg.ce_pri.sel_pipe_reg[0]_0 ;
  wire rd_clk;

  (* SOFT_HLUTNM = "soft_lutpair14" *) 
  LUT3 #(
    .INIT(8'hAC)) 
    \dout[10]_INST_0 
       (.I0(DOBDO[4]),
        .I1(\DEVICE_7SERIES.NO_BMM_INFO.SDP.SIMPLE_PRIM36.ram [4]),
        .I2(\no_softecc_sel_reg.ce_pri.sel_pipe_reg[0]_0 ),
        .O(dout[4]));
  (* SOFT_HLUTNM = "soft_lutpair14" *) 
  LUT3 #(
    .INIT(8'hAC)) 
    \dout[11]_INST_0 
       (.I0(DOBDO[5]),
        .I1(\DEVICE_7SERIES.NO_BMM_INFO.SDP.SIMPLE_PRIM36.ram [5]),
        .I2(\no_softecc_sel_reg.ce_pri.sel_pipe_reg[0]_0 ),
        .O(dout[5]));
  (* SOFT_HLUTNM = "soft_lutpair15" *) 
  LUT3 #(
    .INIT(8'hAC)) 
    \dout[12]_INST_0 
       (.I0(DOBDO[6]),
        .I1(\DEVICE_7SERIES.NO_BMM_INFO.SDP.SIMPLE_PRIM36.ram [6]),
        .I2(\no_softecc_sel_reg.ce_pri.sel_pipe_reg[0]_0 ),
        .O(dout[6]));
  (* SOFT_HLUTNM = "soft_lutpair15" *) 
  LUT3 #(
    .INIT(8'hAC)) 
    \dout[13]_INST_0 
       (.I0(DOBDO[7]),
        .I1(\DEVICE_7SERIES.NO_BMM_INFO.SDP.SIMPLE_PRIM36.ram [7]),
        .I2(\no_softecc_sel_reg.ce_pri.sel_pipe_reg[0]_0 ),
        .O(dout[7]));
  (* SOFT_HLUTNM = "soft_lutpair16" *) 
  LUT3 #(
    .INIT(8'hAC)) 
    \dout[14]_INST_0 
       (.I0(DOPBDOP),
        .I1(\DEVICE_7SERIES.NO_BMM_INFO.SDP.SIMPLE_PRIM36.ram_0 ),
        .I2(\no_softecc_sel_reg.ce_pri.sel_pipe_reg[0]_0 ),
        .O(dout[8]));
  (* SOFT_HLUTNM = "soft_lutpair16" *) 
  LUT3 #(
    .INIT(8'hAC)) 
    \dout[15]_INST_0 
       (.I0(\DEVICE_7SERIES.NO_BMM_INFO.SDP.SIMPLE_PRIM36.ram_1 [0]),
        .I1(\DEVICE_7SERIES.NO_BMM_INFO.SDP.SIMPLE_PRIM36.ram_2 [0]),
        .I2(\no_softecc_sel_reg.ce_pri.sel_pipe_reg[0]_0 ),
        .O(dout[9]));
  (* SOFT_HLUTNM = "soft_lutpair17" *) 
  LUT3 #(
    .INIT(8'hAC)) 
    \dout[16]_INST_0 
       (.I0(\DEVICE_7SERIES.NO_BMM_INFO.SDP.SIMPLE_PRIM36.ram_1 [1]),
        .I1(\DEVICE_7SERIES.NO_BMM_INFO.SDP.SIMPLE_PRIM36.ram_2 [1]),
        .I2(\no_softecc_sel_reg.ce_pri.sel_pipe_reg[0]_0 ),
        .O(dout[10]));
  (* SOFT_HLUTNM = "soft_lutpair17" *) 
  LUT3 #(
    .INIT(8'hAC)) 
    \dout[17]_INST_0 
       (.I0(\DEVICE_7SERIES.NO_BMM_INFO.SDP.SIMPLE_PRIM36.ram_1 [2]),
        .I1(\DEVICE_7SERIES.NO_BMM_INFO.SDP.SIMPLE_PRIM36.ram_2 [2]),
        .I2(\no_softecc_sel_reg.ce_pri.sel_pipe_reg[0]_0 ),
        .O(dout[11]));
  (* SOFT_HLUTNM = "soft_lutpair18" *) 
  LUT3 #(
    .INIT(8'hAC)) 
    \dout[18]_INST_0 
       (.I0(\DEVICE_7SERIES.NO_BMM_INFO.SDP.SIMPLE_PRIM36.ram_1 [3]),
        .I1(\DEVICE_7SERIES.NO_BMM_INFO.SDP.SIMPLE_PRIM36.ram_2 [3]),
        .I2(\no_softecc_sel_reg.ce_pri.sel_pipe_reg[0]_0 ),
        .O(dout[12]));
  (* SOFT_HLUTNM = "soft_lutpair18" *) 
  LUT3 #(
    .INIT(8'hAC)) 
    \dout[19]_INST_0 
       (.I0(\DEVICE_7SERIES.NO_BMM_INFO.SDP.SIMPLE_PRIM36.ram_1 [4]),
        .I1(\DEVICE_7SERIES.NO_BMM_INFO.SDP.SIMPLE_PRIM36.ram_2 [4]),
        .I2(\no_softecc_sel_reg.ce_pri.sel_pipe_reg[0]_0 ),
        .O(dout[13]));
  (* SOFT_HLUTNM = "soft_lutpair19" *) 
  LUT3 #(
    .INIT(8'hAC)) 
    \dout[20]_INST_0 
       (.I0(\DEVICE_7SERIES.NO_BMM_INFO.SDP.SIMPLE_PRIM36.ram_1 [5]),
        .I1(\DEVICE_7SERIES.NO_BMM_INFO.SDP.SIMPLE_PRIM36.ram_2 [5]),
        .I2(\no_softecc_sel_reg.ce_pri.sel_pipe_reg[0]_0 ),
        .O(dout[14]));
  (* SOFT_HLUTNM = "soft_lutpair19" *) 
  LUT3 #(
    .INIT(8'hAC)) 
    \dout[21]_INST_0 
       (.I0(\DEVICE_7SERIES.NO_BMM_INFO.SDP.SIMPLE_PRIM36.ram_1 [6]),
        .I1(\DEVICE_7SERIES.NO_BMM_INFO.SDP.SIMPLE_PRIM36.ram_2 [6]),
        .I2(\no_softecc_sel_reg.ce_pri.sel_pipe_reg[0]_0 ),
        .O(dout[15]));
  (* SOFT_HLUTNM = "soft_lutpair20" *) 
  LUT3 #(
    .INIT(8'hAC)) 
    \dout[22]_INST_0 
       (.I0(\DEVICE_7SERIES.NO_BMM_INFO.SDP.SIMPLE_PRIM36.ram_1 [7]),
        .I1(\DEVICE_7SERIES.NO_BMM_INFO.SDP.SIMPLE_PRIM36.ram_2 [7]),
        .I2(\no_softecc_sel_reg.ce_pri.sel_pipe_reg[0]_0 ),
        .O(dout[16]));
  (* SOFT_HLUTNM = "soft_lutpair20" *) 
  LUT3 #(
    .INIT(8'hAC)) 
    \dout[23]_INST_0 
       (.I0(\DEVICE_7SERIES.NO_BMM_INFO.SDP.SIMPLE_PRIM36.ram_3 ),
        .I1(\DEVICE_7SERIES.NO_BMM_INFO.SDP.SIMPLE_PRIM36.ram_4 ),
        .I2(\no_softecc_sel_reg.ce_pri.sel_pipe_reg[0]_0 ),
        .O(dout[17]));
  (* SOFT_HLUTNM = "soft_lutpair12" *) 
  LUT3 #(
    .INIT(8'hAC)) 
    \dout[6]_INST_0 
       (.I0(DOBDO[0]),
        .I1(\DEVICE_7SERIES.NO_BMM_INFO.SDP.SIMPLE_PRIM36.ram [0]),
        .I2(\no_softecc_sel_reg.ce_pri.sel_pipe_reg[0]_0 ),
        .O(dout[0]));
  (* SOFT_HLUTNM = "soft_lutpair12" *) 
  LUT3 #(
    .INIT(8'hAC)) 
    \dout[7]_INST_0 
       (.I0(DOBDO[1]),
        .I1(\DEVICE_7SERIES.NO_BMM_INFO.SDP.SIMPLE_PRIM36.ram [1]),
        .I2(\no_softecc_sel_reg.ce_pri.sel_pipe_reg[0]_0 ),
        .O(dout[1]));
  (* SOFT_HLUTNM = "soft_lutpair13" *) 
  LUT3 #(
    .INIT(8'hAC)) 
    \dout[8]_INST_0 
       (.I0(DOBDO[2]),
        .I1(\DEVICE_7SERIES.NO_BMM_INFO.SDP.SIMPLE_PRIM36.ram [2]),
        .I2(\no_softecc_sel_reg.ce_pri.sel_pipe_reg[0]_0 ),
        .O(dout[2]));
  (* SOFT_HLUTNM = "soft_lutpair13" *) 
  LUT3 #(
    .INIT(8'hAC)) 
    \dout[9]_INST_0 
       (.I0(DOBDO[3]),
        .I1(\DEVICE_7SERIES.NO_BMM_INFO.SDP.SIMPLE_PRIM36.ram [3]),
        .I2(\no_softecc_sel_reg.ce_pri.sel_pipe_reg[0]_0 ),
        .O(dout[3]));
  FDRE #(
    .INIT(1'b0)) 
    \no_softecc_sel_reg.ce_pri.sel_pipe_reg[0] 
       (.C(rd_clk),
        .CE(1'b1),
        .D(\gc0.count_d1_reg[12] ),
        .Q(\no_softecc_sel_reg.ce_pri.sel_pipe_reg[0]_0 ),
        .R(1'b0));
endmodule

(* ORIG_REF_NAME = "blk_mem_gen_prim_width" *) 
module iq_sample_fifo_blk_mem_gen_prim_width
   (dout,
    wr_clk,
    rd_clk,
    ram_full_fb_i_reg,
    ram_empty_fb_i_reg,
    Q,
    \gc0.count_d1_reg[12] ,
    din,
    WEA);
  output [1:0]dout;
  input wr_clk;
  input rd_clk;
  input ram_full_fb_i_reg;
  input ram_empty_fb_i_reg;
  input [12:0]Q;
  input [12:0]\gc0.count_d1_reg[12] ;
  input [1:0]din;
  input [0:0]WEA;

  wire [12:0]Q;
  wire [0:0]WEA;
  wire [1:0]din;
  wire [1:0]dout;
  wire [12:0]\gc0.count_d1_reg[12] ;
  wire ram_empty_fb_i_reg;
  wire ram_full_fb_i_reg;
  wire rd_clk;
  wire wr_clk;

  iq_sample_fifo_blk_mem_gen_prim_wrapper \prim_noinit.ram 
       (.Q(Q),
        .WEA(WEA),
        .din(din),
        .dout(dout),
        .\gc0.count_d1_reg[12] (\gc0.count_d1_reg[12] ),
        .ram_empty_fb_i_reg(ram_empty_fb_i_reg),
        .ram_full_fb_i_reg(ram_full_fb_i_reg),
        .rd_clk(rd_clk),
        .wr_clk(wr_clk));
endmodule

(* ORIG_REF_NAME = "blk_mem_gen_prim_width" *) 
module iq_sample_fifo_blk_mem_gen_prim_width__parameterized0
   (dout,
    wr_clk,
    rd_clk,
    ram_full_fb_i_reg,
    ram_empty_fb_i_reg,
    Q,
    \gc0.count_d1_reg[12] ,
    din,
    WEA);
  output [3:0]dout;
  input wr_clk;
  input rd_clk;
  input ram_full_fb_i_reg;
  input ram_empty_fb_i_reg;
  input [12:0]Q;
  input [12:0]\gc0.count_d1_reg[12] ;
  input [3:0]din;
  input [0:0]WEA;

  wire [12:0]Q;
  wire [0:0]WEA;
  wire [3:0]din;
  wire [3:0]dout;
  wire [12:0]\gc0.count_d1_reg[12] ;
  wire ram_empty_fb_i_reg;
  wire ram_full_fb_i_reg;
  wire rd_clk;
  wire wr_clk;

  iq_sample_fifo_blk_mem_gen_prim_wrapper__parameterized0 \prim_noinit.ram 
       (.Q(Q),
        .WEA(WEA),
        .din(din),
        .dout(dout),
        .\gc0.count_d1_reg[12] (\gc0.count_d1_reg[12] ),
        .ram_empty_fb_i_reg(ram_empty_fb_i_reg),
        .ram_full_fb_i_reg(ram_full_fb_i_reg),
        .rd_clk(rd_clk),
        .wr_clk(wr_clk));
endmodule

(* ORIG_REF_NAME = "blk_mem_gen_prim_width" *) 
module iq_sample_fifo_blk_mem_gen_prim_width__parameterized1
   (\dout[13] ,
    \dout[14] ,
    wr_clk,
    rd_clk,
    ram_full_fb_i_reg,
    ram_empty_fb_i_reg,
    Q,
    \gc0.count_d1_reg[11] ,
    din,
    WEA);
  output [7:0]\dout[13] ;
  output [0:0]\dout[14] ;
  input wr_clk;
  input rd_clk;
  input ram_full_fb_i_reg;
  input ram_empty_fb_i_reg;
  input [11:0]Q;
  input [11:0]\gc0.count_d1_reg[11] ;
  input [8:0]din;
  input [0:0]WEA;

  wire [11:0]Q;
  wire [0:0]WEA;
  wire [8:0]din;
  wire [7:0]\dout[13] ;
  wire [0:0]\dout[14] ;
  wire [11:0]\gc0.count_d1_reg[11] ;
  wire ram_empty_fb_i_reg;
  wire ram_full_fb_i_reg;
  wire rd_clk;
  wire wr_clk;

  iq_sample_fifo_blk_mem_gen_prim_wrapper__parameterized1 \prim_noinit.ram 
       (.Q(Q),
        .WEA(WEA),
        .din(din),
        .\dout[13] (\dout[13] ),
        .\dout[14] (\dout[14] ),
        .\gc0.count_d1_reg[11] (\gc0.count_d1_reg[11] ),
        .ram_empty_fb_i_reg(ram_empty_fb_i_reg),
        .ram_full_fb_i_reg(ram_full_fb_i_reg),
        .rd_clk(rd_clk),
        .wr_clk(wr_clk));
endmodule

(* ORIG_REF_NAME = "blk_mem_gen_prim_width" *) 
module iq_sample_fifo_blk_mem_gen_prim_width__parameterized2
   (DOBDO,
    DOPBDOP,
    wr_clk,
    rd_clk,
    ena_array,
    enb_array,
    Q,
    \gc0.count_d1_reg[11] ,
    din,
    WEA);
  output [7:0]DOBDO;
  output [0:0]DOPBDOP;
  input wr_clk;
  input rd_clk;
  input [0:0]ena_array;
  input [0:0]enb_array;
  input [11:0]Q;
  input [11:0]\gc0.count_d1_reg[11] ;
  input [8:0]din;
  input [0:0]WEA;

  wire [7:0]DOBDO;
  wire [0:0]DOPBDOP;
  wire [11:0]Q;
  wire [0:0]WEA;
  wire [8:0]din;
  wire [0:0]ena_array;
  wire [0:0]enb_array;
  wire [11:0]\gc0.count_d1_reg[11] ;
  wire rd_clk;
  wire wr_clk;

  iq_sample_fifo_blk_mem_gen_prim_wrapper__parameterized2 \prim_noinit.ram 
       (.DOBDO(DOBDO),
        .DOPBDOP(DOPBDOP),
        .Q(Q),
        .WEA(WEA),
        .din(din),
        .ena_array(ena_array),
        .enb_array(enb_array),
        .\gc0.count_d1_reg[11] (\gc0.count_d1_reg[11] ),
        .rd_clk(rd_clk),
        .wr_clk(wr_clk));
endmodule

(* ORIG_REF_NAME = "blk_mem_gen_prim_width" *) 
module iq_sample_fifo_blk_mem_gen_prim_width__parameterized3
   (\dout[22] ,
    \dout[23] ,
    wr_clk,
    rd_clk,
    ram_full_fb_i_reg,
    ram_empty_fb_i_reg,
    Q,
    \gc0.count_d1_reg[11] ,
    din,
    WEA);
  output [7:0]\dout[22] ;
  output [0:0]\dout[23] ;
  input wr_clk;
  input rd_clk;
  input ram_full_fb_i_reg;
  input ram_empty_fb_i_reg;
  input [11:0]Q;
  input [11:0]\gc0.count_d1_reg[11] ;
  input [8:0]din;
  input [0:0]WEA;

  wire [11:0]Q;
  wire [0:0]WEA;
  wire [8:0]din;
  wire [7:0]\dout[22] ;
  wire [0:0]\dout[23] ;
  wire [11:0]\gc0.count_d1_reg[11] ;
  wire ram_empty_fb_i_reg;
  wire ram_full_fb_i_reg;
  wire rd_clk;
  wire wr_clk;

  iq_sample_fifo_blk_mem_gen_prim_wrapper__parameterized3 \prim_noinit.ram 
       (.Q(Q),
        .WEA(WEA),
        .din(din),
        .\dout[22] (\dout[22] ),
        .\dout[23] (\dout[23] ),
        .\gc0.count_d1_reg[11] (\gc0.count_d1_reg[11] ),
        .ram_empty_fb_i_reg(ram_empty_fb_i_reg),
        .ram_full_fb_i_reg(ram_full_fb_i_reg),
        .rd_clk(rd_clk),
        .wr_clk(wr_clk));
endmodule

(* ORIG_REF_NAME = "blk_mem_gen_prim_width" *) 
module iq_sample_fifo_blk_mem_gen_prim_width__parameterized4
   (\dout[22] ,
    \dout[23] ,
    wr_clk,
    rd_clk,
    ena_array,
    enb_array,
    Q,
    \gc0.count_d1_reg[11] ,
    din,
    WEA);
  output [7:0]\dout[22] ;
  output [0:0]\dout[23] ;
  input wr_clk;
  input rd_clk;
  input [0:0]ena_array;
  input [0:0]enb_array;
  input [11:0]Q;
  input [11:0]\gc0.count_d1_reg[11] ;
  input [8:0]din;
  input [0:0]WEA;

  wire [11:0]Q;
  wire [0:0]WEA;
  wire [8:0]din;
  wire [7:0]\dout[22] ;
  wire [0:0]\dout[23] ;
  wire [0:0]ena_array;
  wire [0:0]enb_array;
  wire [11:0]\gc0.count_d1_reg[11] ;
  wire rd_clk;
  wire wr_clk;

  iq_sample_fifo_blk_mem_gen_prim_wrapper__parameterized4 \prim_noinit.ram 
       (.Q(Q),
        .WEA(WEA),
        .din(din),
        .\dout[22] (\dout[22] ),
        .\dout[23] (\dout[23] ),
        .ena_array(ena_array),
        .enb_array(enb_array),
        .\gc0.count_d1_reg[11] (\gc0.count_d1_reg[11] ),
        .rd_clk(rd_clk),
        .wr_clk(wr_clk));
endmodule

(* ORIG_REF_NAME = "blk_mem_gen_prim_wrapper" *) 
module iq_sample_fifo_blk_mem_gen_prim_wrapper
   (dout,
    wr_clk,
    rd_clk,
    ram_full_fb_i_reg,
    ram_empty_fb_i_reg,
    Q,
    \gc0.count_d1_reg[12] ,
    din,
    WEA);
  output [1:0]dout;
  input wr_clk;
  input rd_clk;
  input ram_full_fb_i_reg;
  input ram_empty_fb_i_reg;
  input [12:0]Q;
  input [12:0]\gc0.count_d1_reg[12] ;
  input [1:0]din;
  input [0:0]WEA;

  wire [12:0]Q;
  wire [0:0]WEA;
  wire [1:0]din;
  wire [1:0]dout;
  wire [12:0]\gc0.count_d1_reg[12] ;
  wire ram_empty_fb_i_reg;
  wire ram_full_fb_i_reg;
  wire rd_clk;
  wire wr_clk;
  wire [15:0]\NLW_DEVICE_7SERIES.NO_BMM_INFO.SDP.SIMPLE_PRIM18.ram_DOADO_UNCONNECTED ;
  wire [15:2]\NLW_DEVICE_7SERIES.NO_BMM_INFO.SDP.SIMPLE_PRIM18.ram_DOBDO_UNCONNECTED ;
  wire [1:0]\NLW_DEVICE_7SERIES.NO_BMM_INFO.SDP.SIMPLE_PRIM18.ram_DOPADOP_UNCONNECTED ;
  wire [1:0]\NLW_DEVICE_7SERIES.NO_BMM_INFO.SDP.SIMPLE_PRIM18.ram_DOPBDOP_UNCONNECTED ;

  (* CLOCK_DOMAINS = "INDEPENDENT" *) 
  (* box_type = "PRIMITIVE" *) 
  RAMB18E1 #(
    .DOA_REG(0),
    .DOB_REG(0),
    .INITP_00(256'h0000000000000000000000000000000000000000000000000000000000000000),
    .INITP_01(256'h0000000000000000000000000000000000000000000000000000000000000000),
    .INITP_02(256'h0000000000000000000000000000000000000000000000000000000000000000),
    .INITP_03(256'h0000000000000000000000000000000000000000000000000000000000000000),
    .INITP_04(256'h0000000000000000000000000000000000000000000000000000000000000000),
    .INITP_05(256'h0000000000000000000000000000000000000000000000000000000000000000),
    .INITP_06(256'h0000000000000000000000000000000000000000000000000000000000000000),
    .INITP_07(256'h0000000000000000000000000000000000000000000000000000000000000000),
    .INIT_00(256'h0000000000000000000000000000000000000000000000000000000000000000),
    .INIT_01(256'h0000000000000000000000000000000000000000000000000000000000000000),
    .INIT_02(256'h0000000000000000000000000000000000000000000000000000000000000000),
    .INIT_03(256'h0000000000000000000000000000000000000000000000000000000000000000),
    .INIT_04(256'h0000000000000000000000000000000000000000000000000000000000000000),
    .INIT_05(256'h0000000000000000000000000000000000000000000000000000000000000000),
    .INIT_06(256'h0000000000000000000000000000000000000000000000000000000000000000),
    .INIT_07(256'h0000000000000000000000000000000000000000000000000000000000000000),
    .INIT_08(256'h0000000000000000000000000000000000000000000000000000000000000000),
    .INIT_09(256'h0000000000000000000000000000000000000000000000000000000000000000),
    .INIT_0A(256'h0000000000000000000000000000000000000000000000000000000000000000),
    .INIT_0B(256'h0000000000000000000000000000000000000000000000000000000000000000),
    .INIT_0C(256'h0000000000000000000000000000000000000000000000000000000000000000),
    .INIT_0D(256'h0000000000000000000000000000000000000000000000000000000000000000),
    .INIT_0E(256'h0000000000000000000000000000000000000000000000000000000000000000),
    .INIT_0F(256'h0000000000000000000000000000000000000000000000000000000000000000),
    .INIT_10(256'h0000000000000000000000000000000000000000000000000000000000000000),
    .INIT_11(256'h0000000000000000000000000000000000000000000000000000000000000000),
    .INIT_12(256'h0000000000000000000000000000000000000000000000000000000000000000),
    .INIT_13(256'h0000000000000000000000000000000000000000000000000000000000000000),
    .INIT_14(256'h0000000000000000000000000000000000000000000000000000000000000000),
    .INIT_15(256'h0000000000000000000000000000000000000000000000000000000000000000),
    .INIT_16(256'h0000000000000000000000000000000000000000000000000000000000000000),
    .INIT_17(256'h0000000000000000000000000000000000000000000000000000000000000000),
    .INIT_18(256'h0000000000000000000000000000000000000000000000000000000000000000),
    .INIT_19(256'h0000000000000000000000000000000000000000000000000000000000000000),
    .INIT_1A(256'h0000000000000000000000000000000000000000000000000000000000000000),
    .INIT_1B(256'h0000000000000000000000000000000000000000000000000000000000000000),
    .INIT_1C(256'h0000000000000000000000000000000000000000000000000000000000000000),
    .INIT_1D(256'h0000000000000000000000000000000000000000000000000000000000000000),
    .INIT_1E(256'h0000000000000000000000000000000000000000000000000000000000000000),
    .INIT_1F(256'h0000000000000000000000000000000000000000000000000000000000000000),
    .INIT_20(256'h0000000000000000000000000000000000000000000000000000000000000000),
    .INIT_21(256'h0000000000000000000000000000000000000000000000000000000000000000),
    .INIT_22(256'h0000000000000000000000000000000000000000000000000000000000000000),
    .INIT_23(256'h0000000000000000000000000000000000000000000000000000000000000000),
    .INIT_24(256'h0000000000000000000000000000000000000000000000000000000000000000),
    .INIT_25(256'h0000000000000000000000000000000000000000000000000000000000000000),
    .INIT_26(256'h0000000000000000000000000000000000000000000000000000000000000000),
    .INIT_27(256'h0000000000000000000000000000000000000000000000000000000000000000),
    .INIT_28(256'h0000000000000000000000000000000000000000000000000000000000000000),
    .INIT_29(256'h0000000000000000000000000000000000000000000000000000000000000000),
    .INIT_2A(256'h0000000000000000000000000000000000000000000000000000000000000000),
    .INIT_2B(256'h0000000000000000000000000000000000000000000000000000000000000000),
    .INIT_2C(256'h0000000000000000000000000000000000000000000000000000000000000000),
    .INIT_2D(256'h0000000000000000000000000000000000000000000000000000000000000000),
    .INIT_2E(256'h0000000000000000000000000000000000000000000000000000000000000000),
    .INIT_2F(256'h0000000000000000000000000000000000000000000000000000000000000000),
    .INIT_30(256'h0000000000000000000000000000000000000000000000000000000000000000),
    .INIT_31(256'h0000000000000000000000000000000000000000000000000000000000000000),
    .INIT_32(256'h0000000000000000000000000000000000000000000000000000000000000000),
    .INIT_33(256'h0000000000000000000000000000000000000000000000000000000000000000),
    .INIT_34(256'h0000000000000000000000000000000000000000000000000000000000000000),
    .INIT_35(256'h0000000000000000000000000000000000000000000000000000000000000000),
    .INIT_36(256'h0000000000000000000000000000000000000000000000000000000000000000),
    .INIT_37(256'h0000000000000000000000000000000000000000000000000000000000000000),
    .INIT_38(256'h0000000000000000000000000000000000000000000000000000000000000000),
    .INIT_39(256'h0000000000000000000000000000000000000000000000000000000000000000),
    .INIT_3A(256'h0000000000000000000000000000000000000000000000000000000000000000),
    .INIT_3B(256'h0000000000000000000000000000000000000000000000000000000000000000),
    .INIT_3C(256'h0000000000000000000000000000000000000000000000000000000000000000),
    .INIT_3D(256'h0000000000000000000000000000000000000000000000000000000000000000),
    .INIT_3E(256'h0000000000000000000000000000000000000000000000000000000000000000),
    .INIT_3F(256'h0000000000000000000000000000000000000000000000000000000000000000),
    .INIT_A(18'h00000),
    .INIT_B(18'h00000),
    .INIT_FILE("NONE"),
    .IS_CLKARDCLK_INVERTED(1'b0),
    .IS_CLKBWRCLK_INVERTED(1'b0),
    .IS_ENARDEN_INVERTED(1'b0),
    .IS_ENBWREN_INVERTED(1'b0),
    .IS_RSTRAMARSTRAM_INVERTED(1'b0),
    .IS_RSTRAMB_INVERTED(1'b0),
    .IS_RSTREGARSTREG_INVERTED(1'b0),
    .IS_RSTREGB_INVERTED(1'b0),
    .RAM_MODE("TDP"),
    .RDADDR_COLLISION_HWCONFIG("DELAYED_WRITE"),
    .READ_WIDTH_A(2),
    .READ_WIDTH_B(2),
    .RSTREG_PRIORITY_A("REGCE"),
    .RSTREG_PRIORITY_B("REGCE"),
    .SIM_COLLISION_CHECK("ALL"),
    .SIM_DEVICE("7SERIES"),
    .SRVAL_A(18'h00000),
    .SRVAL_B(18'h00000),
    .WRITE_MODE_A("WRITE_FIRST"),
    .WRITE_MODE_B("WRITE_FIRST"),
    .WRITE_WIDTH_A(2),
    .WRITE_WIDTH_B(2)) 
    \DEVICE_7SERIES.NO_BMM_INFO.SDP.SIMPLE_PRIM18.ram 
       (.ADDRARDADDR({Q,1'b0}),
        .ADDRBWRADDR({\gc0.count_d1_reg[12] ,1'b0}),
        .CLKARDCLK(wr_clk),
        .CLKBWRCLK(rd_clk),
        .DIADI({1'b0,1'b0,1'b0,1'b0,1'b0,1'b0,1'b0,1'b0,1'b0,1'b0,1'b0,1'b0,1'b0,1'b0,din}),
        .DIBDI({1'b0,1'b0,1'b0,1'b0,1'b0,1'b0,1'b0,1'b0,1'b0,1'b0,1'b0,1'b0,1'b0,1'b0,1'b0,1'b0}),
        .DIPADIP({1'b0,1'b0}),
        .DIPBDIP({1'b0,1'b0}),
        .DOADO(\NLW_DEVICE_7SERIES.NO_BMM_INFO.SDP.SIMPLE_PRIM18.ram_DOADO_UNCONNECTED [15:0]),
        .DOBDO({\NLW_DEVICE_7SERIES.NO_BMM_INFO.SDP.SIMPLE_PRIM18.ram_DOBDO_UNCONNECTED [15:2],dout}),
        .DOPADOP(\NLW_DEVICE_7SERIES.NO_BMM_INFO.SDP.SIMPLE_PRIM18.ram_DOPADOP_UNCONNECTED [1:0]),
        .DOPBDOP(\NLW_DEVICE_7SERIES.NO_BMM_INFO.SDP.SIMPLE_PRIM18.ram_DOPBDOP_UNCONNECTED [1:0]),
        .ENARDEN(ram_full_fb_i_reg),
        .ENBWREN(ram_empty_fb_i_reg),
        .REGCEAREGCE(1'b0),
        .REGCEB(1'b0),
        .RSTRAMARSTRAM(1'b0),
        .RSTRAMB(1'b0),
        .RSTREGARSTREG(1'b0),
        .RSTREGB(1'b0),
        .WEA({WEA,WEA}),
        .WEBWE({1'b0,1'b0,1'b0,1'b0}));
endmodule
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
