daveshah1/RFToolSDR/linux-app/spectrum-analyser/ad9361/util.c

/***************************************************************************//**
 *   @file   util.c
 *   @brief  Implementation of Util Driver.
 *   @author DBogdan (dragos.bogdan@analog.com)
********************************************************************************
 * Copyright 2013(c) Analog Devices, Inc.
 *
 * All rights reserved.
 *
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
 * THIS SOFTWARE IS PROVIDED BY ANALOG DEVICES "AS IS" AND ANY EXPRESS OR
 * IMPLIED WARRANTIES, INCLUDING, BUT NOT LIMITED TO, NON-INFRINGEMENT,
 * MERCHANTABILITY AND FITNESS FOR A PARTICULAR PURPOSE ARE DISCLAIMED.
 * IN NO EVENT SHALL ANALOG DEVICES BE LIABLE FOR ANY DIRECT, INDIRECT,
 * INCIDENTAL, SPECIAL, EXEMPLARY, OR CONSEQUENTIAL DAMAGES (INCLUDING, BUT NOT
 * LIMITED TO, INTELLECTUAL PROPERTY RIGHTS, PROCUREMENT OF SUBSTITUTE GOODS OR
 * SERVICES; LOSS OF USE, DATA, OR PROFITS; OR BUSINESS INTERRUPTION) HOWEVER
 * CAUSED AND ON ANY THEORY OF LIABILITY, WHETHER IN CONTRACT, STRICT LIABILITY,
 * OR TORT (INCLUDING NEGLIGENCE OR OTHERWISE) ARISING IN ANY WAY OUT OF THE USE
 * OF THIS SOFTWARE, EVEN IF ADVISED OF THE POSSIBILITY OF SUCH DAMAGE.
*******************************************************************************/

/******************************************************************************/
/***************************** Include Files **********************************/
/******************************************************************************/
#include "util.h"
#include "string.h"
#include "platform.h"

/******************************************************************************/
/*************************** Macros Definitions *******************************/
/******************************************************************************/
#define BITS_PER_LONG		32

/***************************************************************************//**
 * @brief clk_prepare_enable
*******************************************************************************/
int32_t clk_prepare_enable(struct clk *clk)
{
	if (clk) {
		// Unused variable - fix compiler warning
	}

	return 0;
}

/***************************************************************************//**
 * @brief clk_get_rate
*******************************************************************************/
uint32_t clk_get_rate(struct ad9361_rf_phy *phy,
					  struct refclk_scale *clk_priv)
{
	uint32_t rate = 0;
	uint32_t source;

	source = clk_priv->source;

	switch (source) {
		case TX_REFCLK:
		case RX_REFCLK:
		case BB_REFCLK:
			rate = ad9361_clk_factor_recalc_rate(clk_priv,
						phy->clk_refin->rate);
			break;
		case TX_RFPLL_INT:
		case RX_RFPLL_INT:
			rate = ad9361_rfpll_int_recalc_rate(clk_priv,
						phy->clks[clk_priv->parent_source]->rate);
		case RX_RFPLL_DUMMY:
		case TX_RFPLL_DUMMY:
			rate = ad9361_rfpll_dummy_recalc_rate(clk_priv);
			break;
		case TX_RFPLL:
		case RX_RFPLL:
			rate = ad9361_rfpll_recalc_rate(clk_priv);
			break;
		case BBPLL_CLK:
			rate = ad9361_bbpll_recalc_rate(clk_priv,
						phy->clks[clk_priv->parent_source]->rate);
			break;
		case ADC_CLK:
		case R2_CLK:
		case R1_CLK:
		case CLKRF_CLK:
		case RX_SAMPL_CLK:
		case DAC_CLK:
		case T2_CLK:
		case T1_CLK:
		case CLKTF_CLK:
		case TX_SAMPL_CLK:
			rate = ad9361_clk_factor_recalc_rate(clk_priv,
						phy->clks[clk_priv->parent_source]->rate);
			break;
		default:
			break;
	}

	return rate;
}
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
