daveshah1/RFToolSDR/(commit log)

2016-12-20 Hardware Rev 1.0
    [ad9364.sch, fpga.sch, periph.sch, power.sch, rf_fe.sch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]
2017-01-16 Improve responsivity at lower sample rates
2017-04-15 Linux App Improvements
    - Fix some memory access bugs
    - Add optional support for CUDA FFTs
    - Compile a shared library, as part of a gnuradio integration project
    [FFTRenderer.cpp, FFTRenderer.hpp, RFThread.cpp, RFThread.hpp, ad9361.c, common.h, librftool.cpp, librftool.h]
2017-10-03 Add DDS and noise signal generator, plus WIP demodulation
    [DSPCore.cpp, DSPCore.hpp, DSPDemodulate.hpp, DemodThread.cpp, DemodThread.hpp, FFTRenderer.cpp, FFTRenderer.hpp, RFThread.cpp]
