daveshah1/RFToolSDR/(notices)

Notices in the files:
hardware/rftool/power.sch:
CC-BY-SA
